beetlebugorg/penplotter/hardware/reference/SOURCES.md

# CR-10 V2/V3 reference models

Creality does not publish CAD for the CR-10 V3. These are models that owners made from the real parts.

| File | Source | Author | License |
|---|---|---|---|
| `carriage_plate_Bear.step` | <https://www.printables.com/model/205016> | Bear | CC BY |
| `carriage_plate_J_Cross.step` | <https://www.printables.com/model/139901> | J_Cross | CC BY |
| `titan_coupling_InternalError33.step` | <https://www.printables.com/model/188638> | InternalError33 | Public domain |

The two carriage plate models agree on the tool head hole pattern to about 1 mm.
