beetlebugorg/penplotter/hardware/docs/hero-dark.png

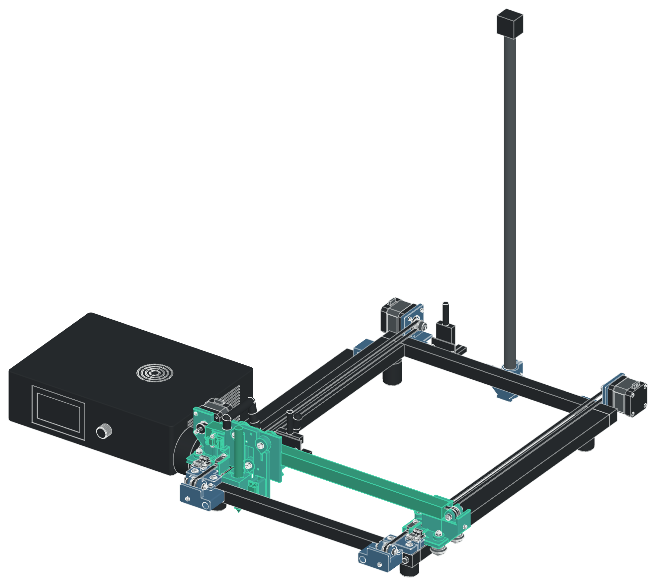
hardware/docs/hero-dark.png
