beetlebugorg/penplotter/hardware/cad/pen-lift-assembly.step

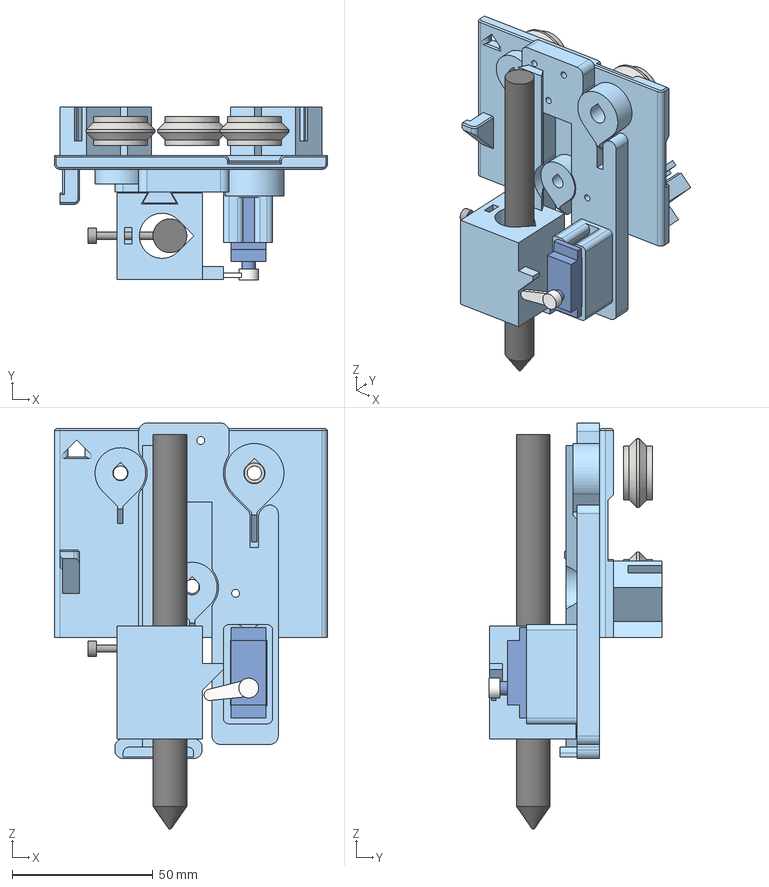
[picture p3: CAD file, 2026-11-12]
hardware/cad/pen-lift-assembly.step
96.9 x 61.5 x 144.0 mm
pen_lift
pen_slider
servo
horn_down
pen
screw
X plate
X wheel 0
X wheel 1
X wheel 2
