beetlebugorg/penplotter/hardware/cad/y_idler_bracket_right.step

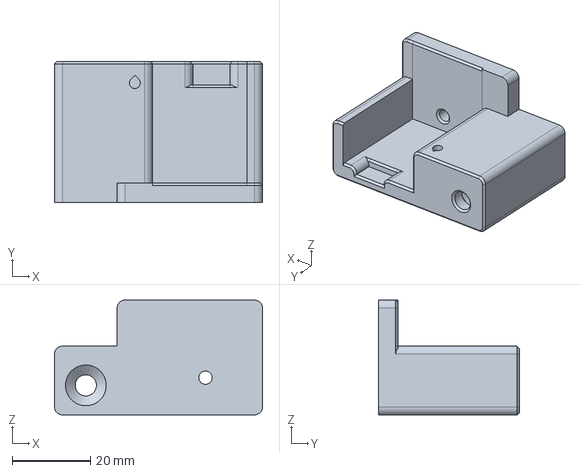
[picture p4: CAD file, 2026-11-12]
hardware/cad/y_idler_bracket_right.step
53.1 x 36.0 x 29.3 mm
