beetlebugorg/penplotter/hardware/stl/context/x_wheels.stl

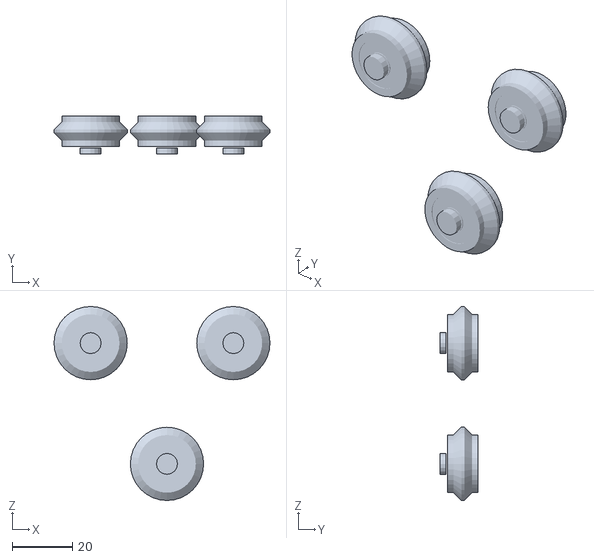
[picture p5: CAD file, 2026-11-12]
hardware/stl/context/x_wheels.stl
71.9 x 12.7 x 64.6
