beetlebugorg/penplotter/hardware/stl/detail/gantry_steel.stl

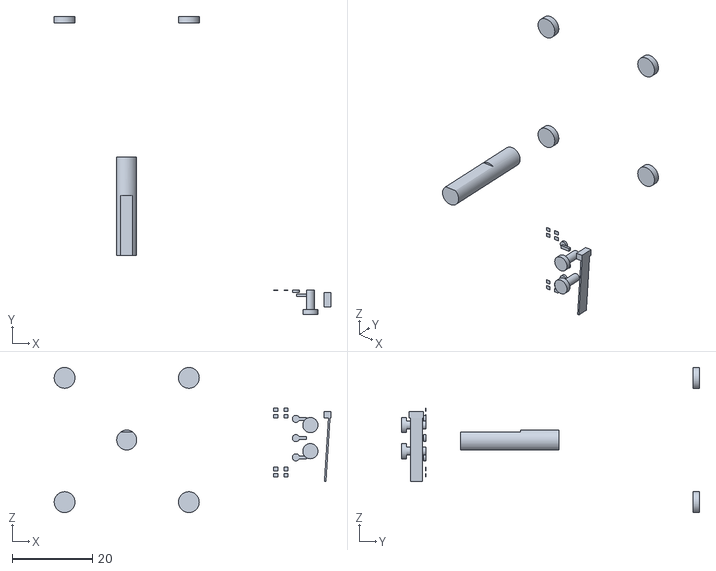
[picture p6: CAD file, 2026-11-12]
hardware/stl/detail/gantry_steel.stl
69.0 x 74.3 x 36.2
