beetlebugorg/penplotter/hardware/stl/sim2/fasteners_carriage.stl

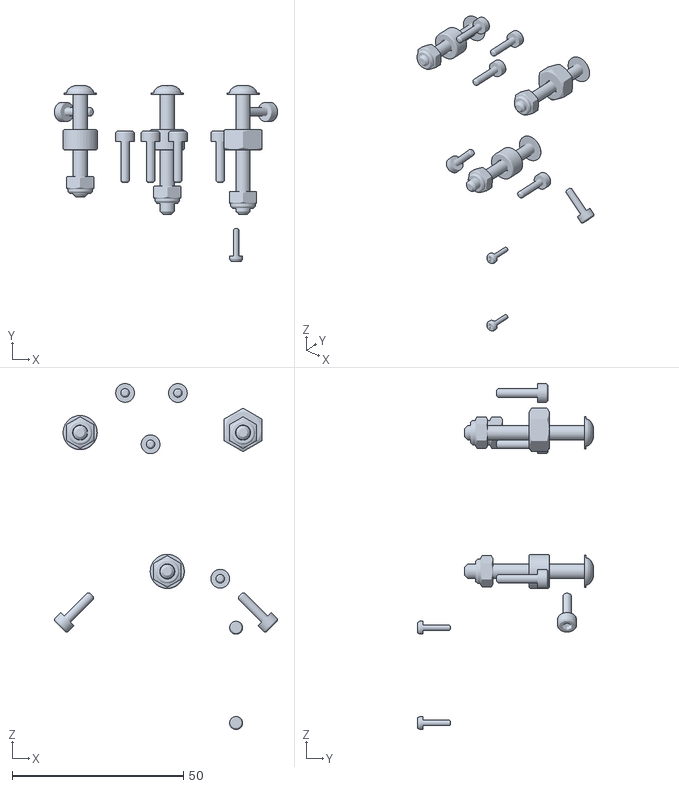
[picture p7: CAD file, 2026-11-12]
hardware/stl/sim2/fasteners_carriage.stl
65.1 x 51.3 x 101.0
