beetlebugorg/penplotter/hardware/cad/x_idler_fork.step

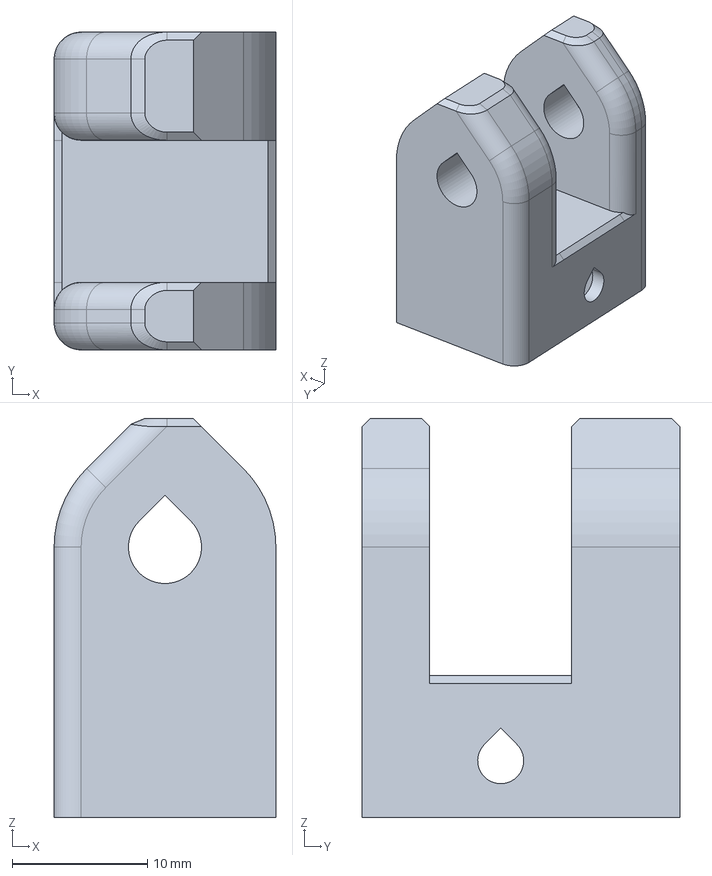
[picture p8: CAD file, 2026-11-12]
hardware/cad/x_idler_fork.step
16.4 x 23.5 x 29.5 mm
