beetlebugorg/penplotter/hardware/stl/context/x_belt.stl

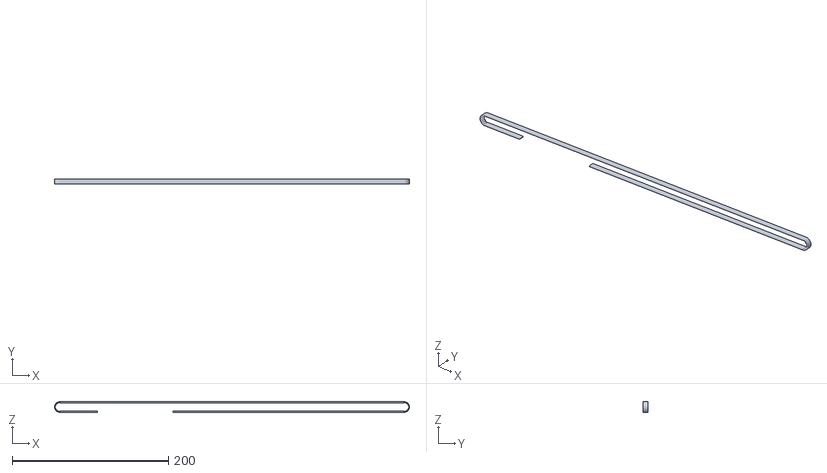
[picture p9: CAD file, 2026-11-12]
hardware/stl/context/x_belt.stl
454.0 x 6.00 x 13.5
