beetlebugorg/penplotter/hardware/stl/detail/gantry_smd_light.stl

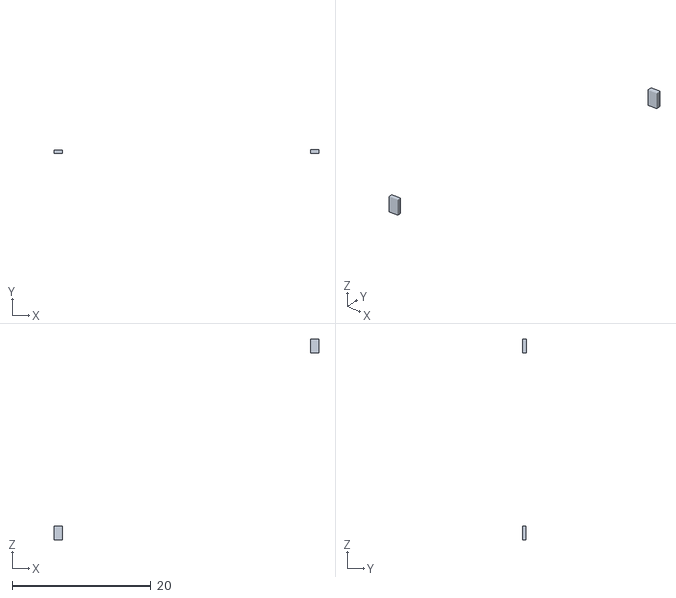
[picture p10: CAD file, 2026-11-12]
hardware/stl/detail/gantry_smd_light.stl
38.2 x 0.6 x 29.0
