beetlebugorg/penplotter/hardware/stl/sim2/y_carriage_right.stl

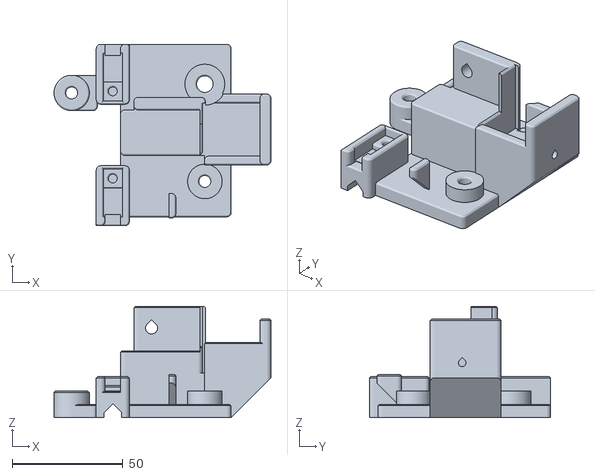
[picture p11: CAD file, 2026-11-12]
hardware/stl/sim2/y_carriage_right.stl
98.1 x 82.0 x 50.3
