beetlebugorg/penplotter/hardware/cad/pen_slider.step

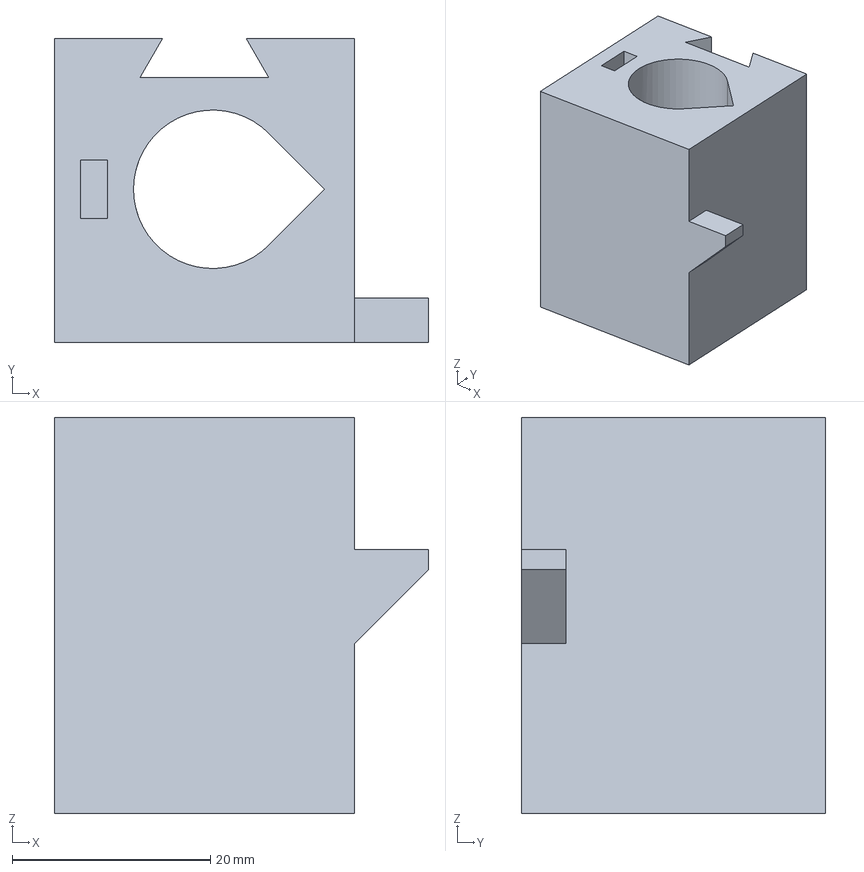
[picture p12: CAD file, 2026-11-12]
hardware/cad/pen_slider.step
37.8 x 30.7 x 40.0 mm
