beetlebugorg/penplotter/hardware/stl/context/servo_loom.stl

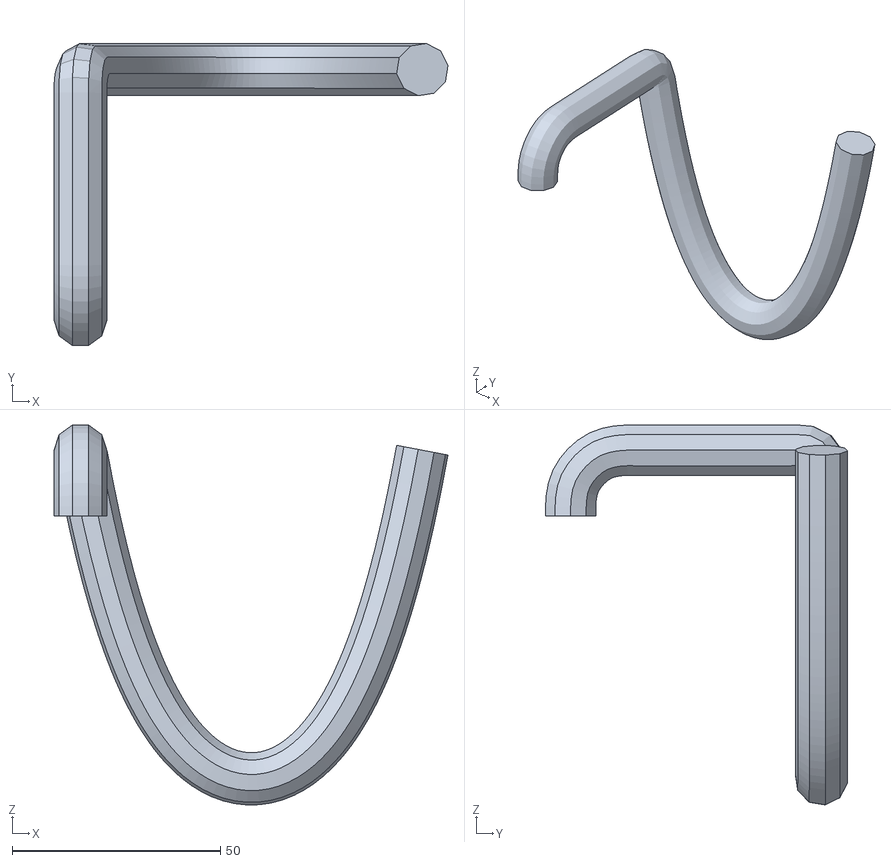
[picture p13: CAD file, 2026-11-12]
hardware/stl/context/servo_loom.stl
94.6 x 72.5 x 91.2
