beetlebugorg/penplotter/hardware/stl/detail/gantry_x_pulley.stl

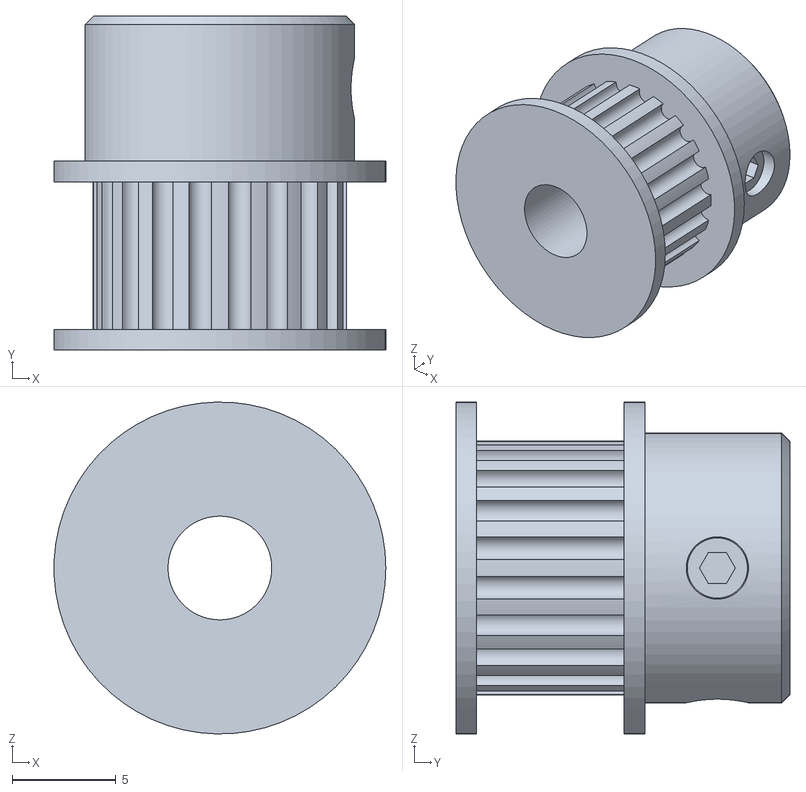
[picture p14: CAD file, 2026-11-12]
hardware/stl/detail/gantry_x_pulley.stl
16.0 x 16.1 x 16.0
