beetlebugorg/penplotter/hardware/stl/hardware/carriage/eccentric_eccentric_spacer_stock-yp.stl

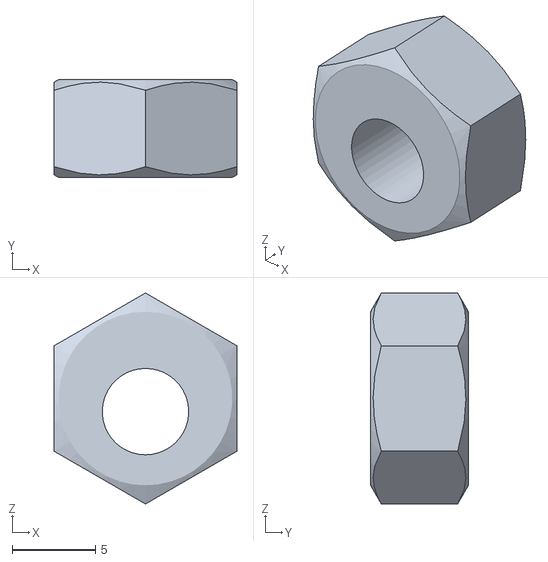
[picture p15: CAD file, 2026-11-12]
hardware/stl/hardware/carriage/eccentric_eccentric_spacer_stock-yp.stl
11.0 x 5.90 x 12.7
