beetlebugorg/penplotter/hardware/stl/hardware/left/insert_m3_heat_set_insert_5_7_mm-yn.stl

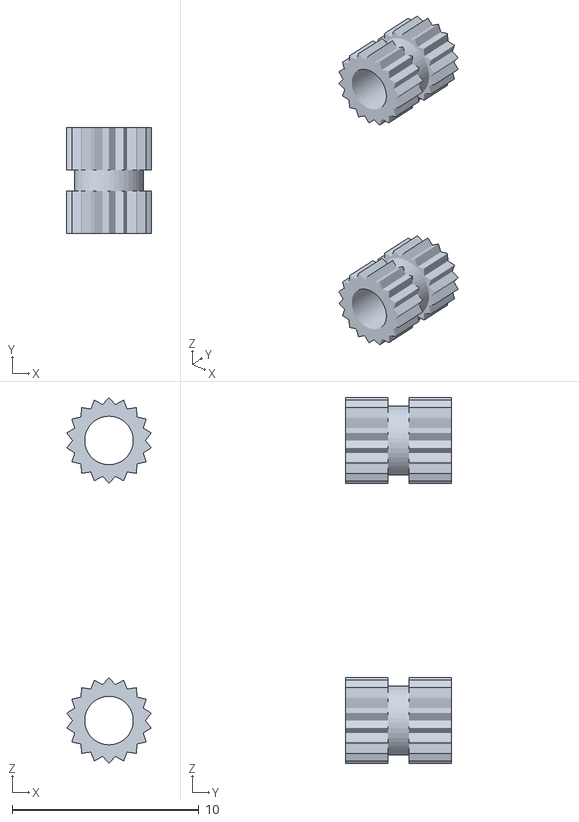
[picture p16: CAD file, 2026-11-12]
hardware/stl/hardware/left/insert_m3_heat_set_insert_5_7_mm-yn.stl
4.53 x 5.65 x 19.6
