beetlebugorg/penplotter/hardware/stl/sim2/x_carriage_plate.stl

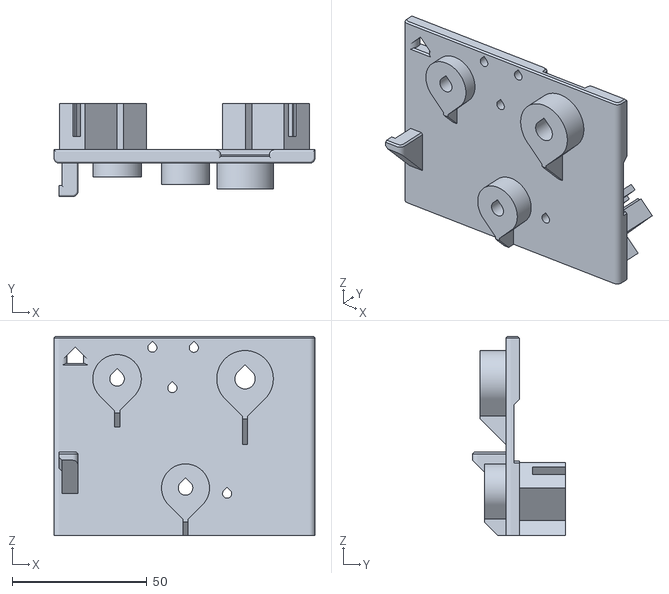
[picture p17: CAD file, 2026-11-12]
hardware/stl/sim2/x_carriage_plate.stl
96.9 x 34.6 x 74.0
