beetlebugorg/penplotter/hardware/cad/y_front_left.step

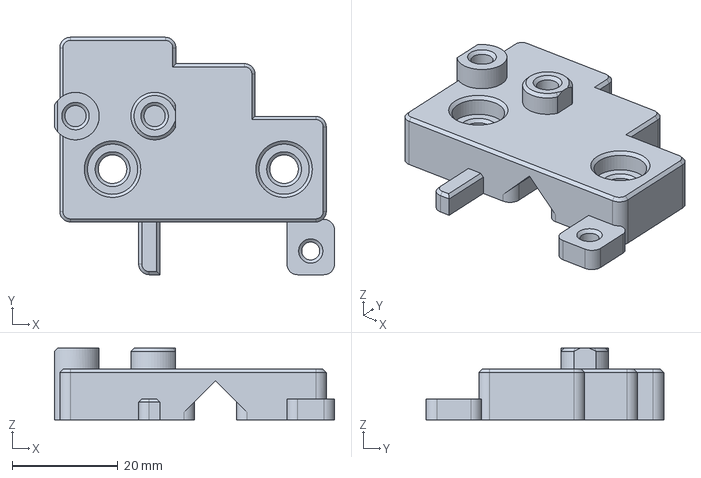
[picture p18: CAD file, 2026-11-12]
hardware/cad/y_front_left.step
53.0 x 45.0 x 13.6 mm
