beetlebugorg/penplotter/hardware/stl/context/y_wheels.stl

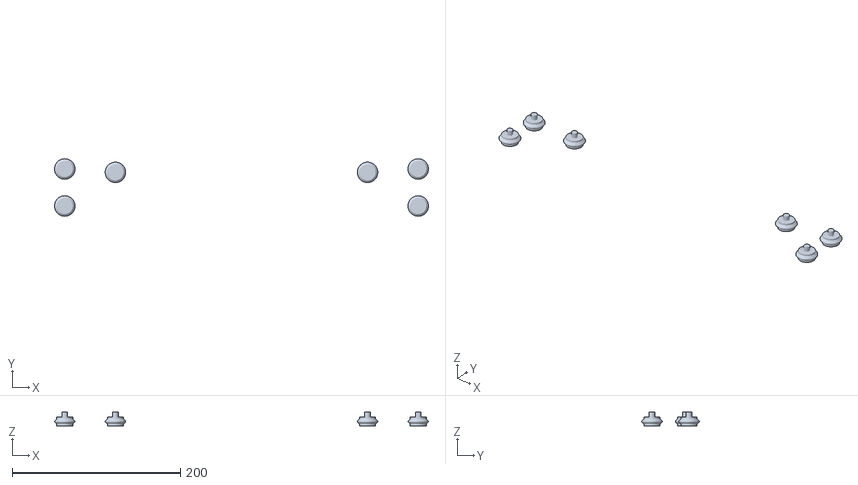
[picture p19: CAD file, 2026-11-12]
hardware/stl/context/y_wheels.stl
444.6 x 68.4 x 16.1
