beetlebugorg/penplotter/hardware/stl/detail/gantry_switch.stl

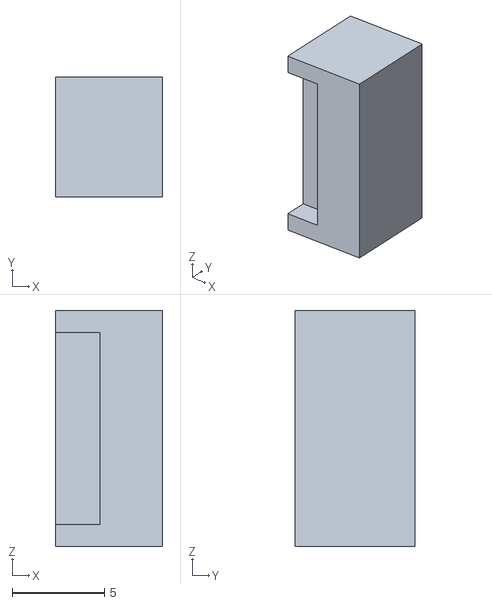
[picture p20: CAD file, 2026-11-12]
hardware/stl/detail/gantry_switch.stl
5.80 x 6.50 x 12.8
