beetlebugorg/penplotter/hardware/stl/hardware/carriage/insert_m3_heat_set_insert_5_7_mm-n0707_p0000_n0707.stl

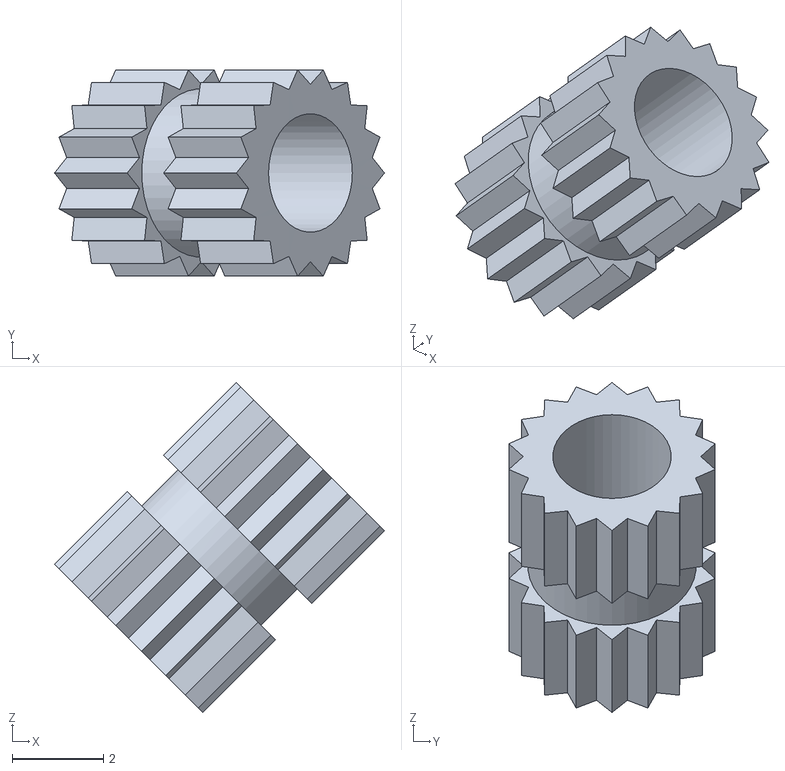
[picture p21: CAD file, 2026-11-12]
hardware/stl/hardware/carriage/insert_m3_heat_set_insert_5_7_mm-n0707_p0000_n0707.stl
7.25 x 4.53 x 7.25
