beetlebugorg/penplotter/hardware/stl/sim2/pen_carriage.stl

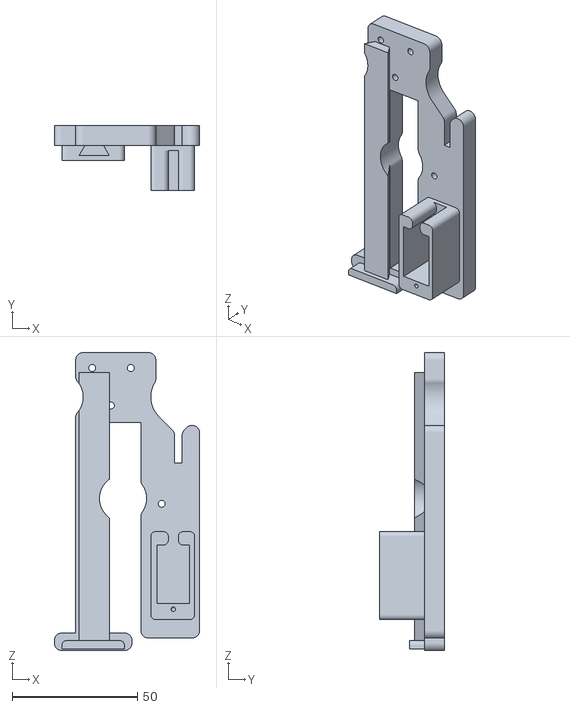
[picture p22: CAD file, 2026-11-12]
hardware/stl/sim2/pen_carriage.stl
58.0 x 25.9 x 119.0
