beetlebugorg/penplotter/hardware/cad/y_motor_mount_right.step

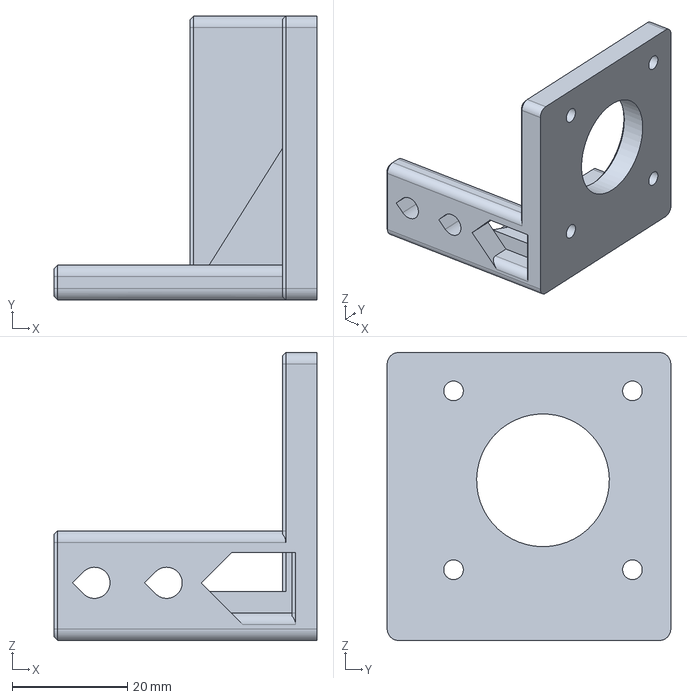
[picture p23: CAD file, 2026-11-12]
hardware/cad/y_motor_mount_right.step
45.6 x 49.1 x 49.9 mm
