beetlebugorg/penplotter/hardware/stl/context/x_beam.stl

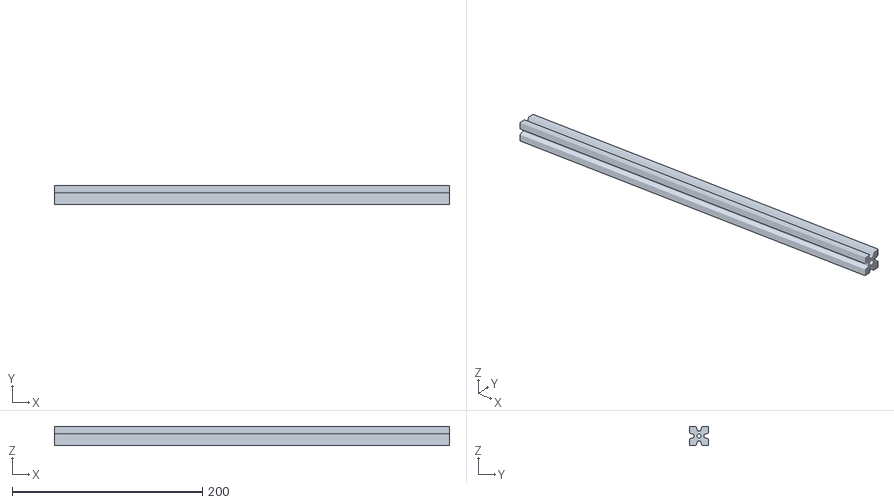
[picture p24: CAD file, 2026-11-12]
hardware/stl/context/x_beam.stl
415.0 x 20.0 x 20.0
