beetlebugorg/penplotter/hardware/stl/detail/carriage_wire_brown.stl

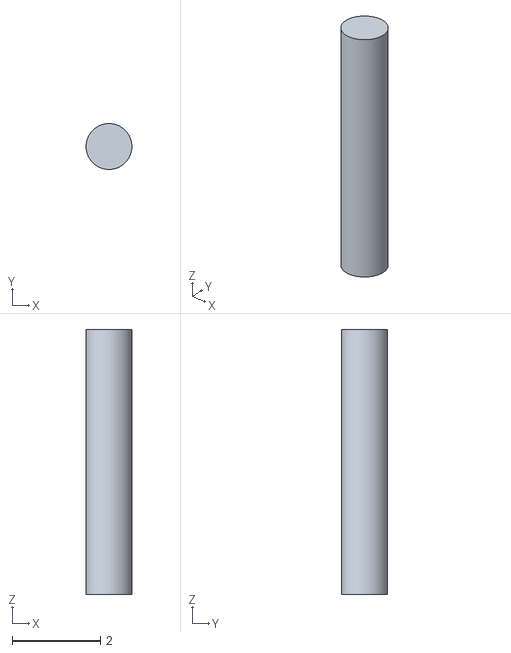
[picture p25: CAD file, 2026-11-12]
hardware/stl/detail/carriage_wire_brown.stl
1.04 x 1.04 x 6.00
