beetlebugorg/penplotter/hardware/stl/hardware/carriage/wheel_v_wheel_stock-yp.stl

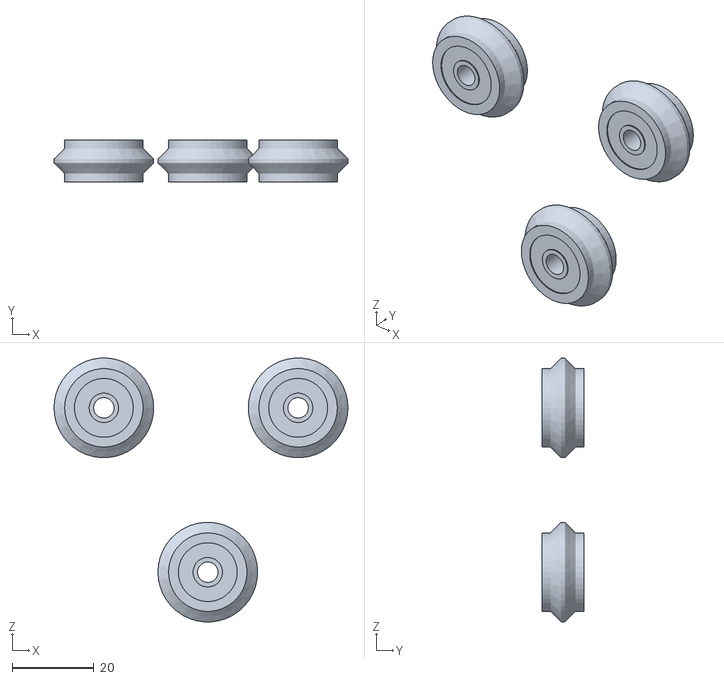
[picture p26: CAD file, 2026-11-12]
hardware/stl/hardware/carriage/wheel_v_wheel_stock-yp.stl
71.9 x 10.2 x 64.5
