beetlebugorg/penplotter/hardware/stl/hardware/right/clip_belt_jaw_printed-zp.stl

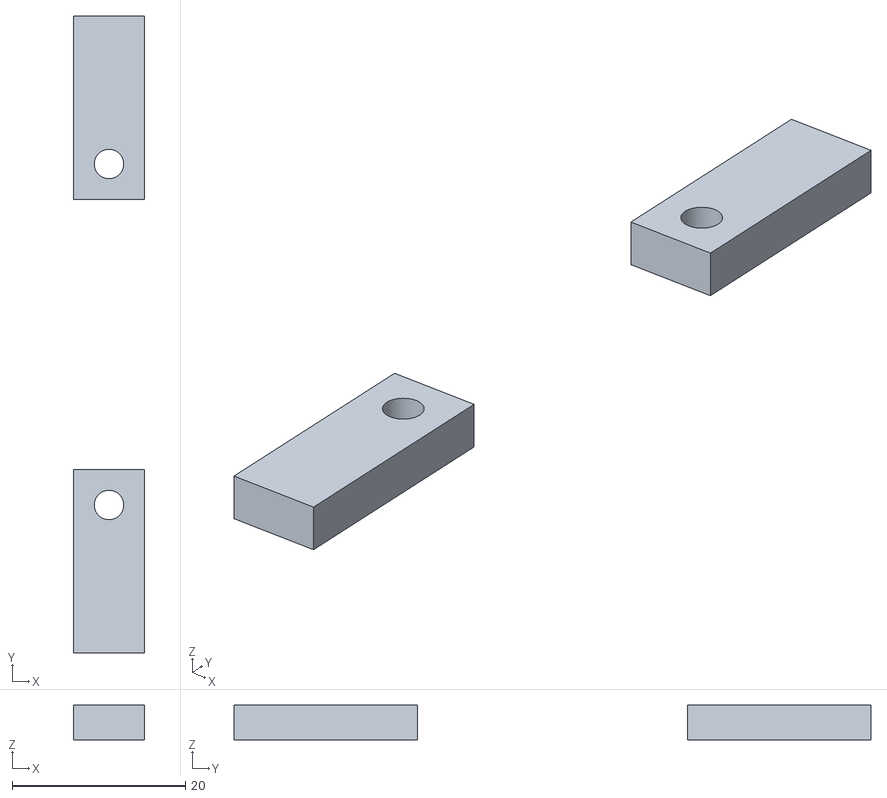
[picture p27: CAD file, 2026-11-12]
hardware/stl/hardware/right/clip_belt_jaw_printed-zp.stl
8.20 x 73.6 x 4.00
