beetlebugorg/penplotter/hardware/stl/sim2/fasteners_gantry.stl

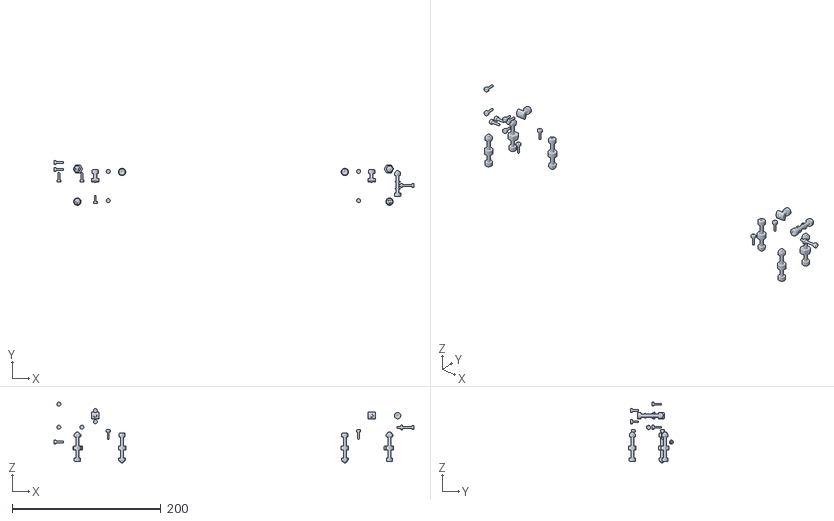
[picture p28: CAD file, 2026-11-12]
hardware/stl/sim2/fasteners_gantry.stl
484.5 x 60.2 x 81.7
