beetlebugorg/penplotter/hardware/cad/fit_rail.step

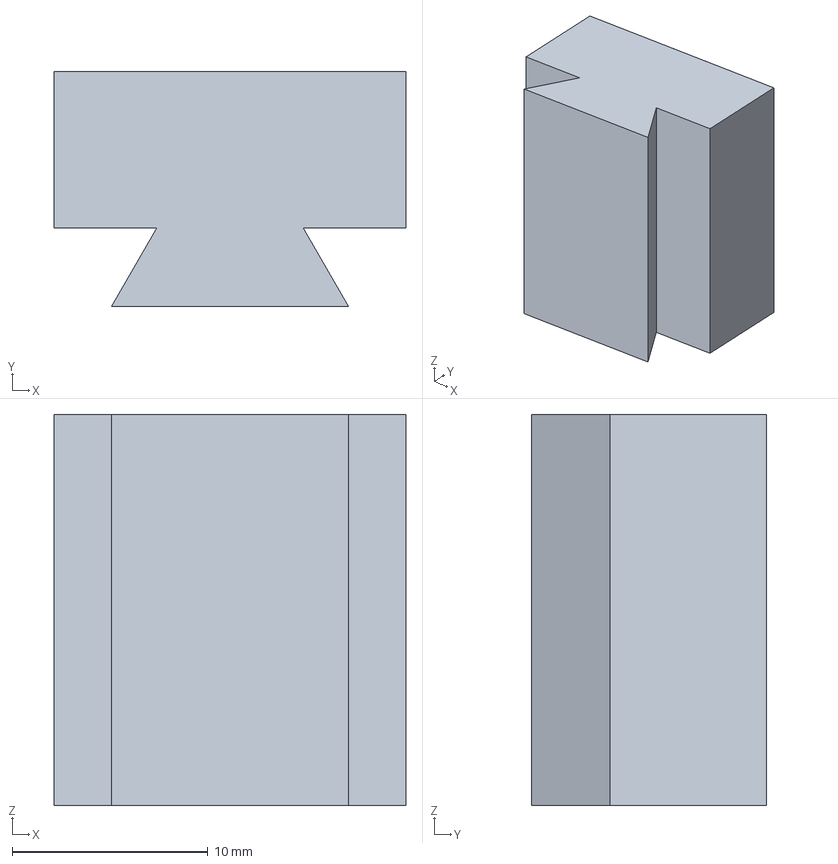
[picture p29: CAD file, 2026-11-12]
hardware/cad/fit_rail.step
18.0 x 12.0 x 20.0 mm
