beetlebugorg/penplotter/hardware/stl/context/x_endstop.stl

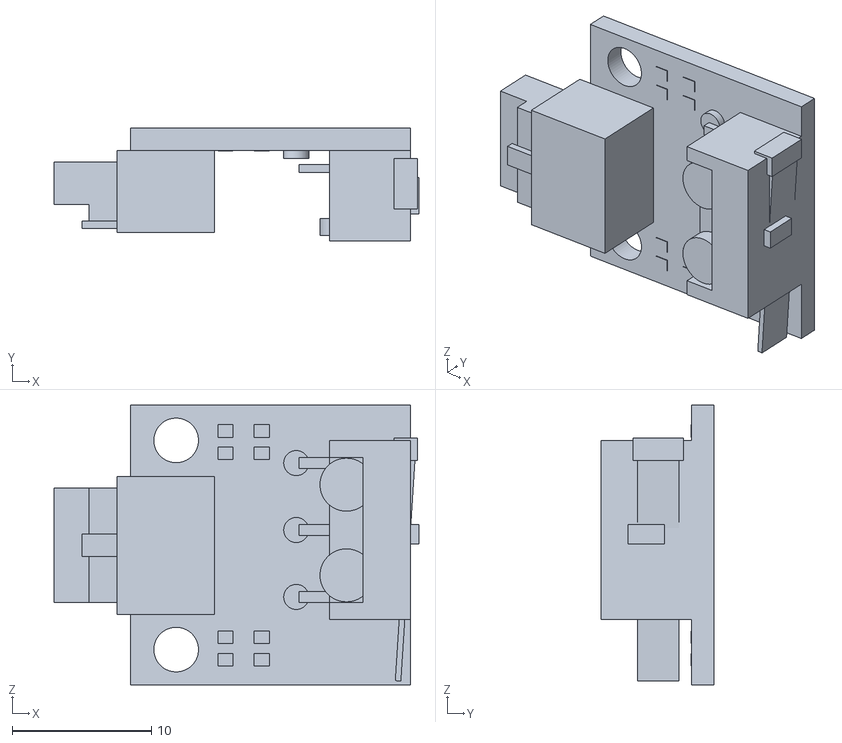
[picture p30: CAD file, 2026-11-12]
hardware/stl/context/x_endstop.stl
26.2 x 8.10 x 20.1
