beetlebugorg/penplotter/hardware/stl/detail/carriage_servo.stl

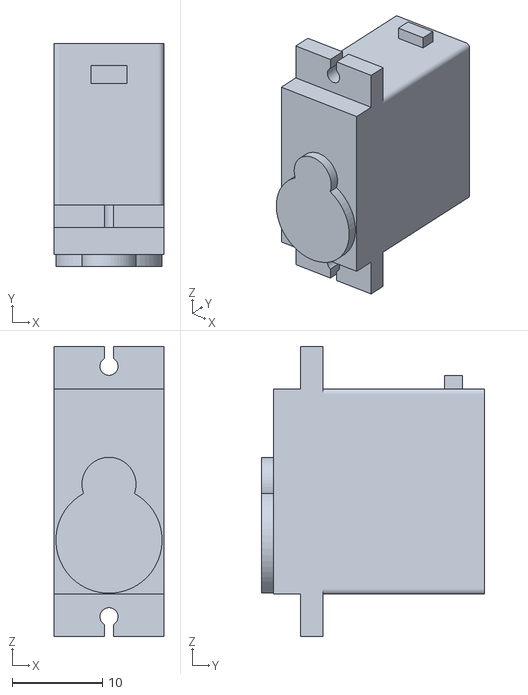
[picture p31: CAD file, 2026-11-12]
hardware/stl/detail/carriage_servo.stl
12.2 x 24.7 x 32.2
