beetlebugorg/penplotter/hardware/stl/sim2/y_carriage_left.stl

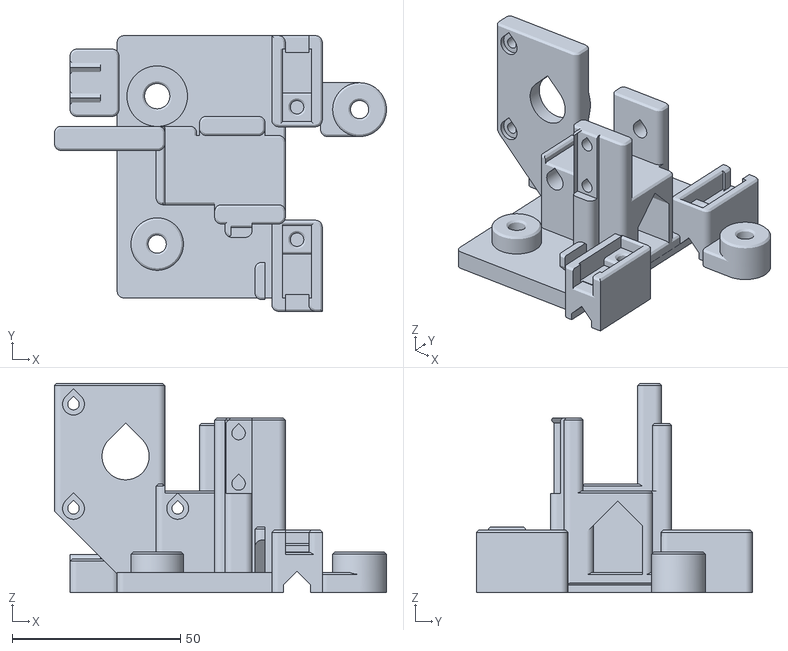
[picture p32: CAD file, 2026-11-12]
hardware/stl/sim2/y_carriage_left.stl
98.8 x 82.0 x 62.2
