beetlebugorg/penplotter/hardware/cad/mast_foot.step

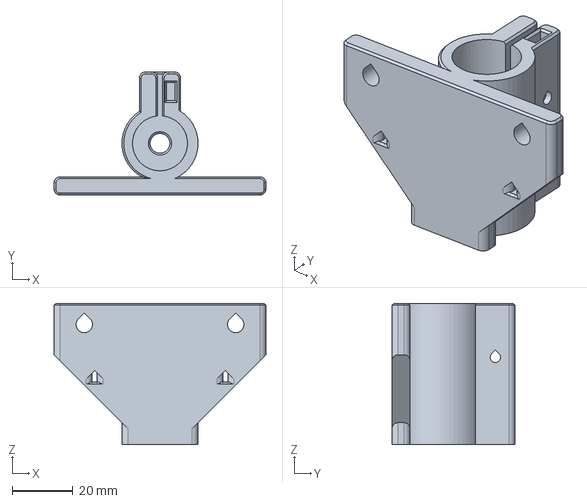
[picture p33: CAD file, 2026-11-12]
hardware/cad/mast_foot.step
70.0 x 40.6 x 46.7 mm
