beetlebugorg/penplotter/hardware/stl/context/camera_pole.stl

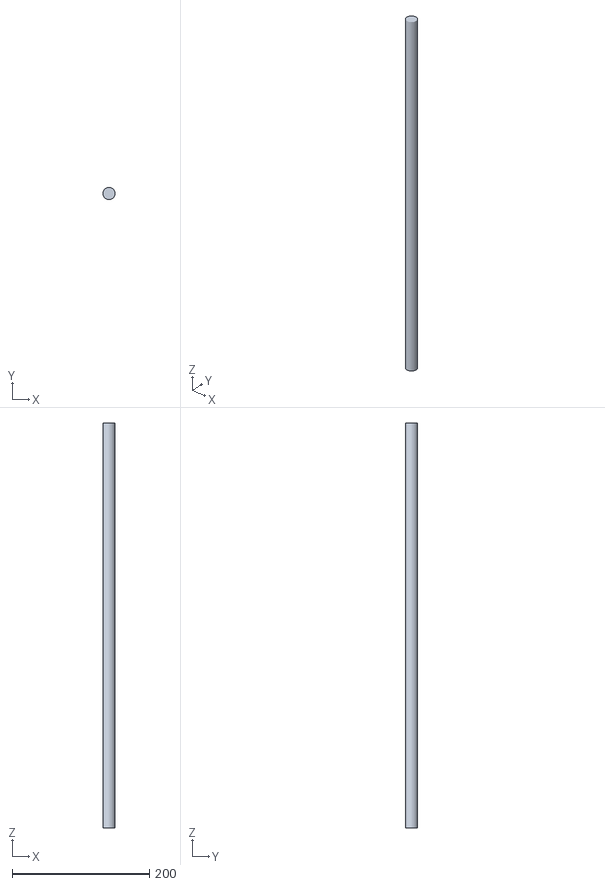
[picture p34: CAD file, 2026-11-12]
hardware/stl/context/camera_pole.stl
17.9 x 17.9 x 590.0
