beetlebugorg/penplotter/hardware/stl/detail/gantry_plunger.stl

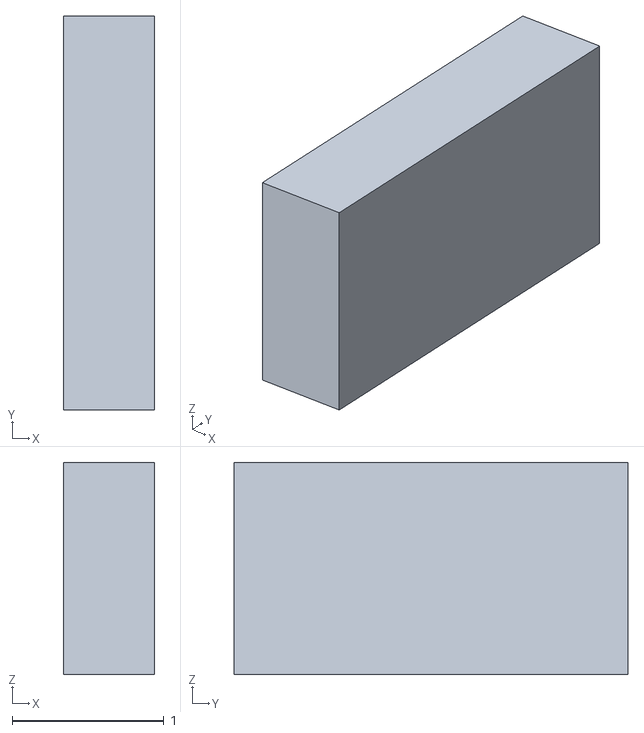
[picture p35: CAD file, 2026-11-12]
hardware/stl/detail/gantry_plunger.stl
0.6 x 2.60 x 1.40
