beetlebugorg/penplotter/hardware/stl/hardware/left/wheel_v_wheel_stock-zn.stl

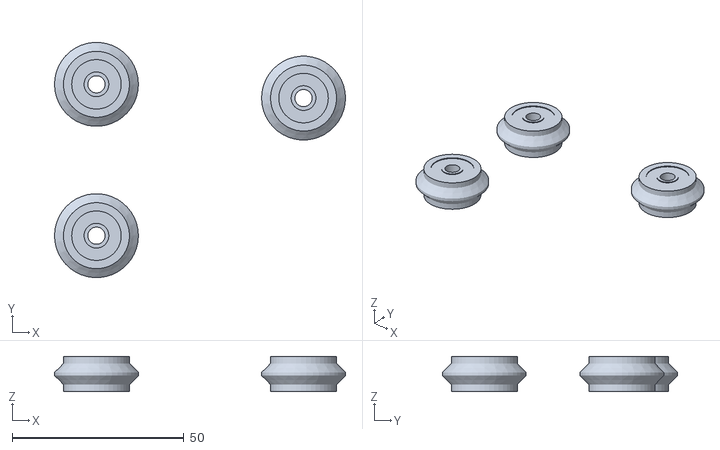
[picture p36: CAD file, 2026-11-12]
hardware/stl/hardware/left/wheel_v_wheel_stock-zn.stl
84.6 x 68.3 x 10.2
