beetlebugorg/penplotter/hardware/stl/sim2/inserts_carriage.stl

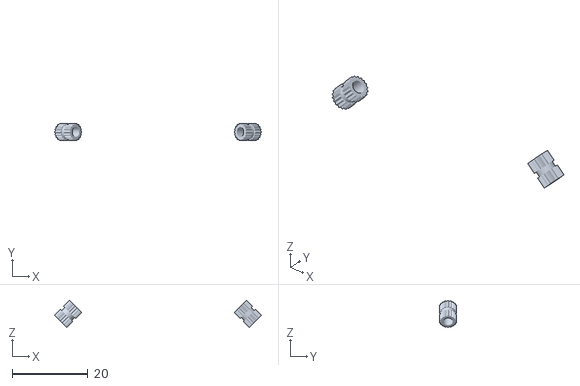
[picture p37: CAD file, 2026-11-12]
hardware/stl/sim2/inserts_carriage.stl
54.8 x 4.53 x 7.25
