beetlebugorg/penplotter/hardware/stl/context/y_belts.stl

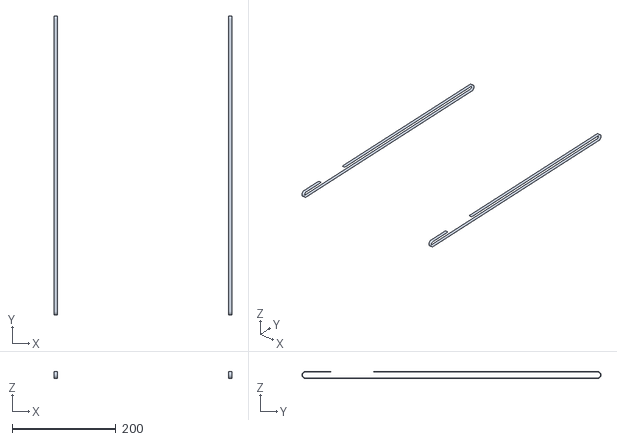
[picture p38: CAD file, 2026-11-12]
hardware/stl/context/y_belts.stl
343.0 x 577.5 x 13.5
