beetlebugorg/penplotter/hardware/stl/detail/gantry_black_plastic.stl

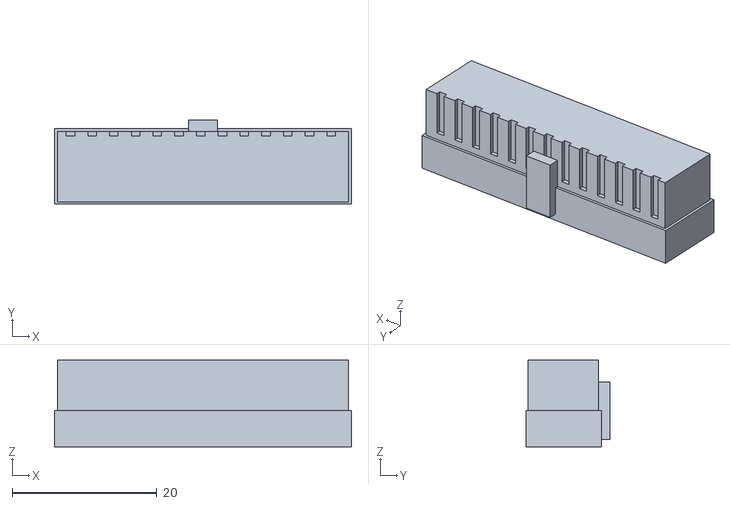
[picture p39: CAD file, 2026-11-12]
hardware/stl/detail/gantry_black_plastic.stl
41.0 x 11.6 x 12.0
