beetlebugorg/penplotter/hardware/stl/sim2/inserts_gantry.stl

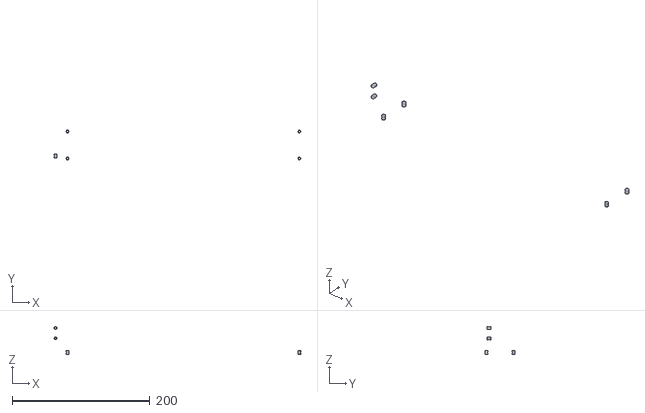
[picture p40: CAD file, 2026-11-12]
hardware/stl/sim2/inserts_gantry.stl
359.0 x 43.9 x 40.9
