beetlebugorg/penplotter/hardware/stl/context/drag_chain_moving.stl

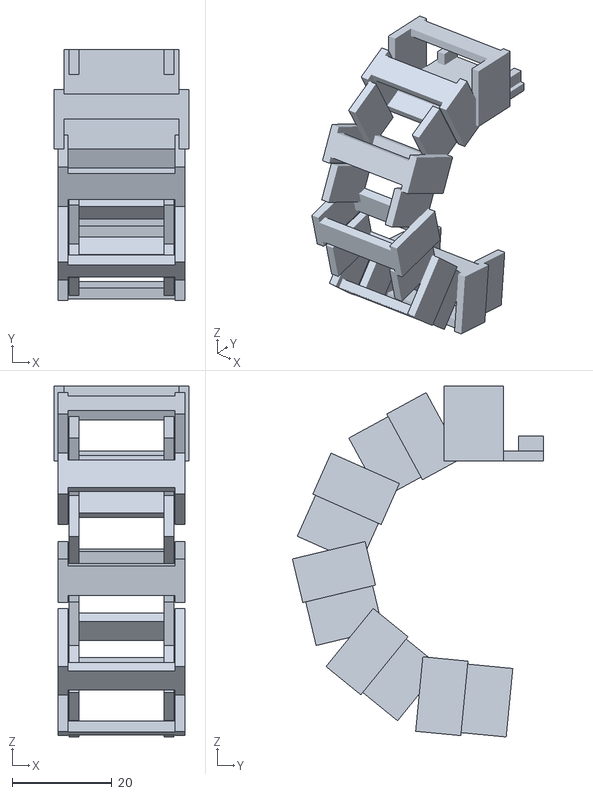
[picture p41: CAD file, 2026-11-12]
hardware/stl/context/drag_chain_moving.stl
27.0 x 50.4 x 70.4
