beetlebugorg/penplotter/hardware/stl/detail/gantry_pcb.stl

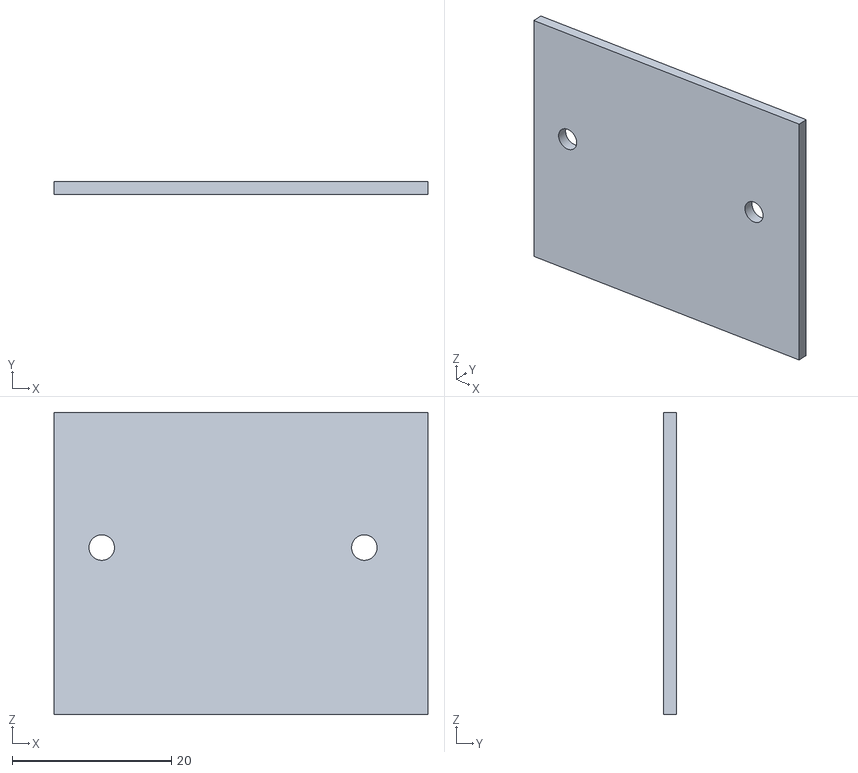
[picture p42: CAD file, 2026-11-12]
hardware/stl/detail/gantry_pcb.stl
47.0 x 1.60 x 38.0
