beetlebugorg/penplotter/hardware/stl/hardware/carriage/spacer_m5_spacer_6_mm_stock-yp.stl

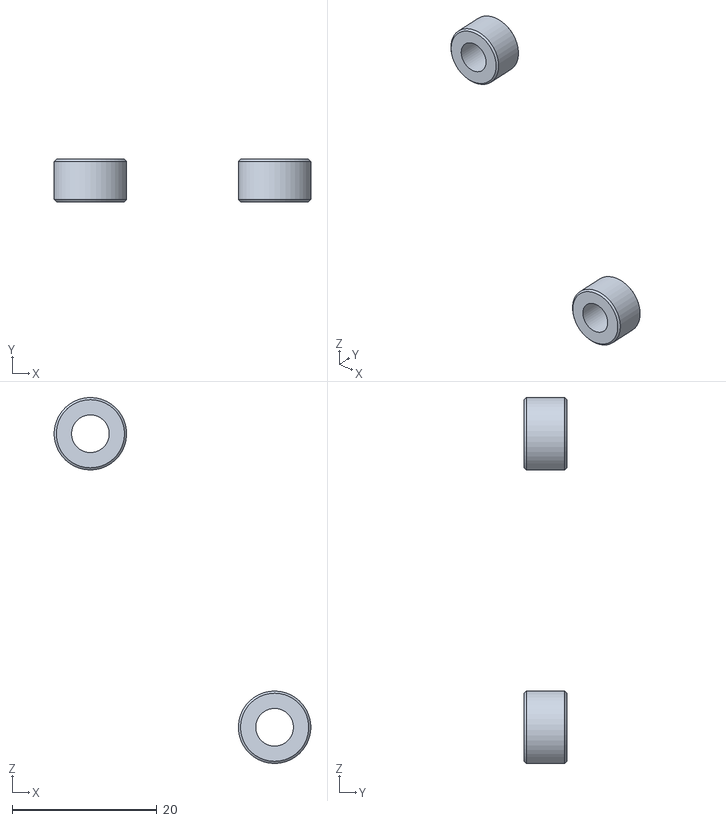
[picture p43: CAD file, 2026-11-12]
hardware/stl/hardware/carriage/spacer_m5_spacer_6_mm_stock-yp.stl
35.4 x 5.90 x 50.5
