beetlebugorg/penplotter/hardware/cad/y_chain_anchor.step

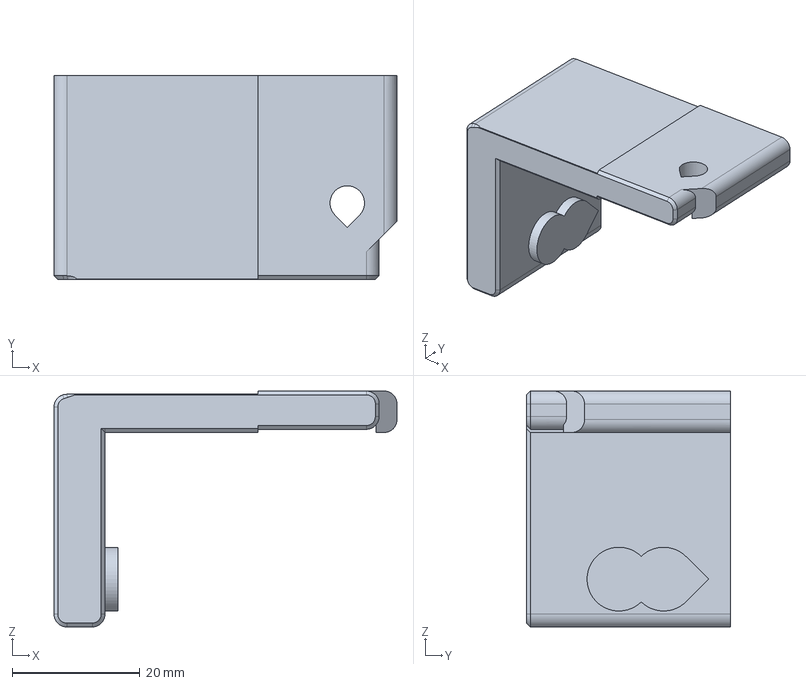
[picture p44: CAD file, 2026-11-12]
hardware/cad/y_chain_anchor.step
53.8 x 32.0 x 37.0 mm
