beetlebugorg/penplotter/hardware/stl/context/webcam.stl

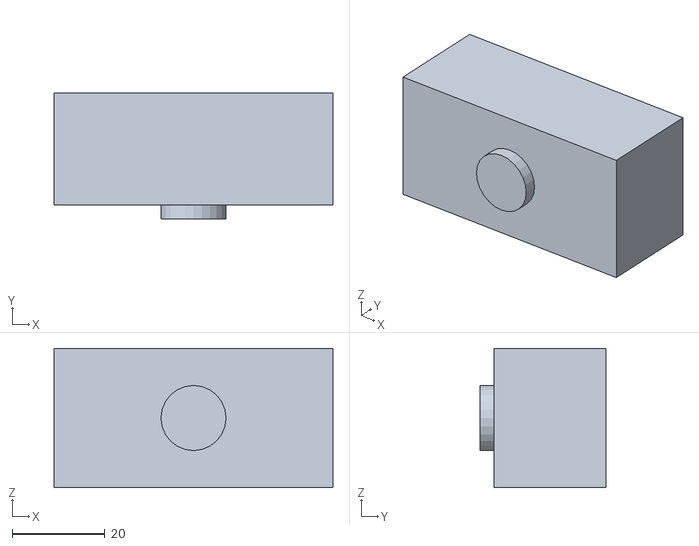
[picture p45: CAD file, 2026-11-12]
hardware/stl/context/webcam.stl
60.0 x 27.0 x 30.0
