beetlebugorg/penplotter/hardware/stl/detail/gantry_gold.stl

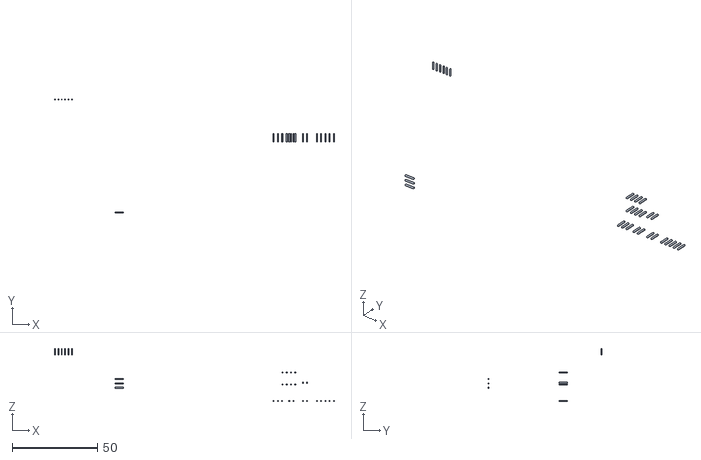
[picture p46: CAD file, 2026-11-12]
hardware/stl/detail/gantry_gold.stl
164.6 x 66.9 x 31.2
