beetlebugorg/penplotter/hardware/stl/hardware/carriage/clip_belt_jaw_printed-yp.stl

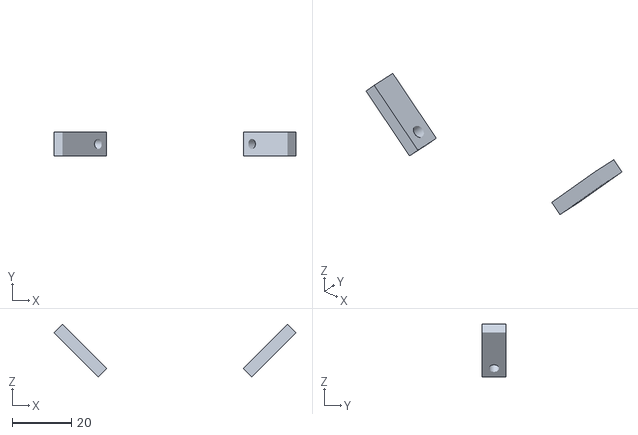
[picture p47: CAD file, 2026-11-12]
hardware/stl/hardware/carriage/clip_belt_jaw_printed-yp.stl
81.8 x 8.20 x 17.8
