beetlebugorg/penplotter/hardware/stl/sim2/belt_ends_gantry.stl

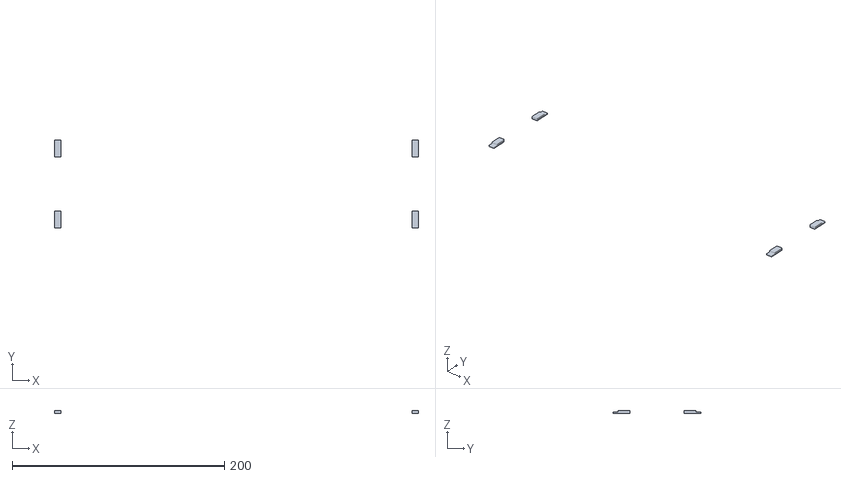
[picture p48: CAD file, 2026-11-12]
hardware/stl/sim2/belt_ends_gantry.stl
343.0 x 83.0 x 2.80
