beetlebugorg/penplotter/hardware/stl/context/control_box.stl

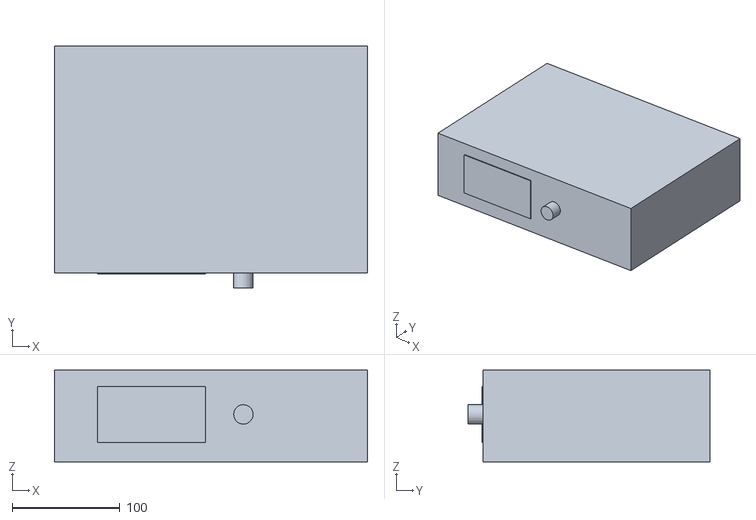
[picture p49: CAD file, 2026-11-10]
hardware/stl/context/control_box.stl
290.0 x 224.0 x 85.0
