beetlebugorg/penplotter/hardware/stl/detail/gantry_motor_cap.stl

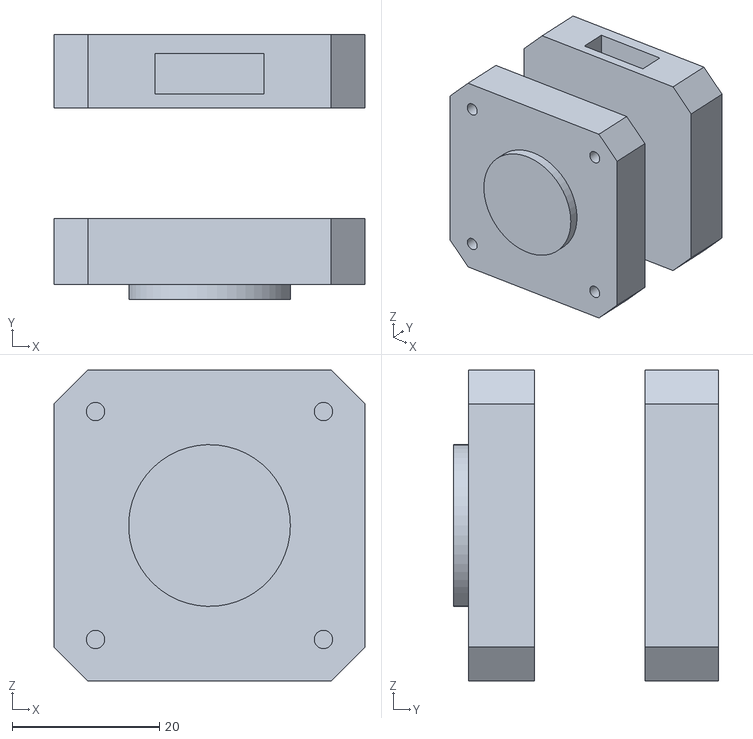
[picture p50: CAD file, 2026-11-12]
hardware/stl/detail/gantry_motor_cap.stl
42.3 x 36.0 x 42.3
