beetlebugorg/penplotter/hardware/stl/sim2/servo.stl

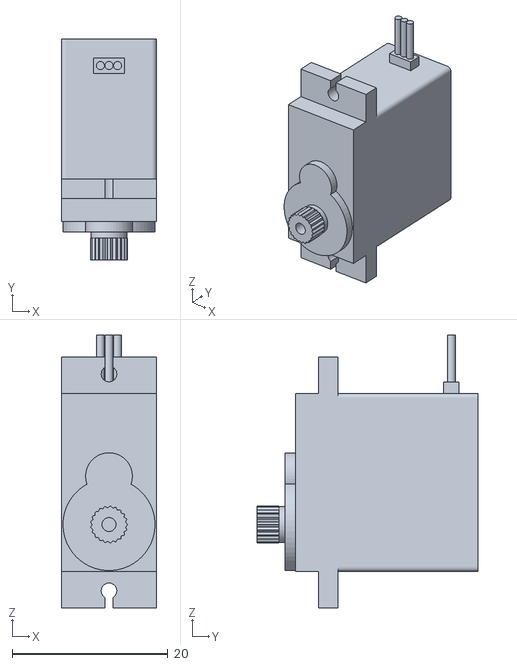
[picture p51: CAD file, 2026-11-12]
hardware/stl/sim2/servo.stl
12.2 x 28.3 x 35.0
