beetlebugorg/penplotter/hardware/stl/context/drag_chain_fixed.stl

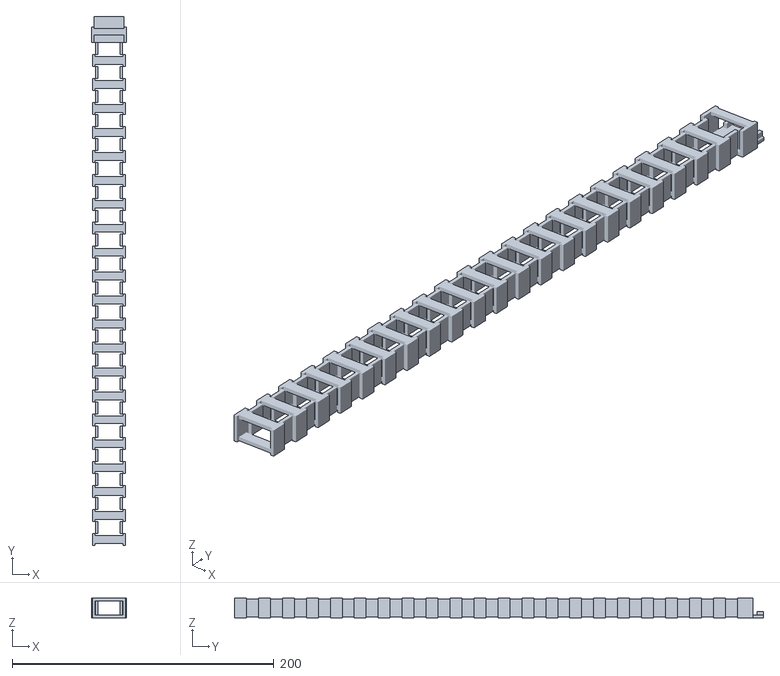
[picture p52: CAD file, 2026-11-10]
hardware/stl/context/drag_chain_fixed.stl
27.0 x 404.4 x 15.0
