beetlebugorg/penplotter/hardware/stl/detail/gantry_smd.stl

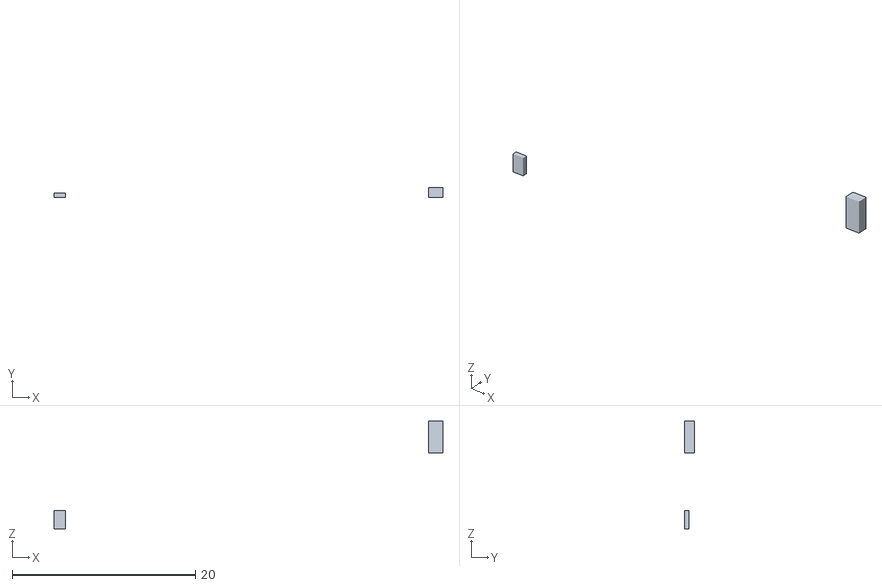
[picture p53: CAD file, 2026-11-12]
hardware/stl/detail/gantry_smd.stl
42.4 x 1.10 x 11.8
