beetlebugorg/penplotter/hardware/stl/hardware/left/insert_m3_heat_set_insert_5_7_mm-zp.stl

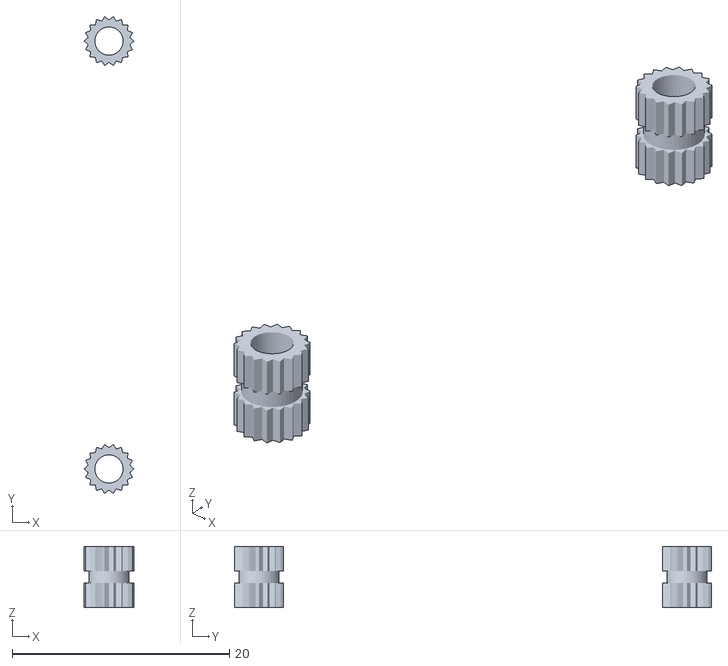
[picture p54: CAD file, 2026-11-12]
hardware/stl/hardware/left/insert_m3_heat_set_insert_5_7_mm-zp.stl
4.60 x 43.9 x 5.65
