beetlebugorg/penplotter/hardware/cad/fit_wheel.step

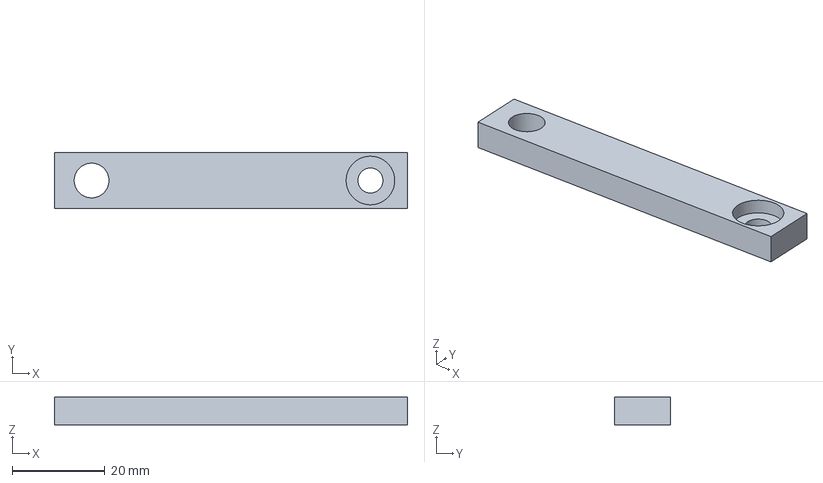
[picture p55: CAD file, 2026-11-12]
hardware/cad/fit_wheel.step
76.2 x 12.0 x 6.00 mm
