beetlebugorg/penplotter/hardware/stl/context/frame.stl

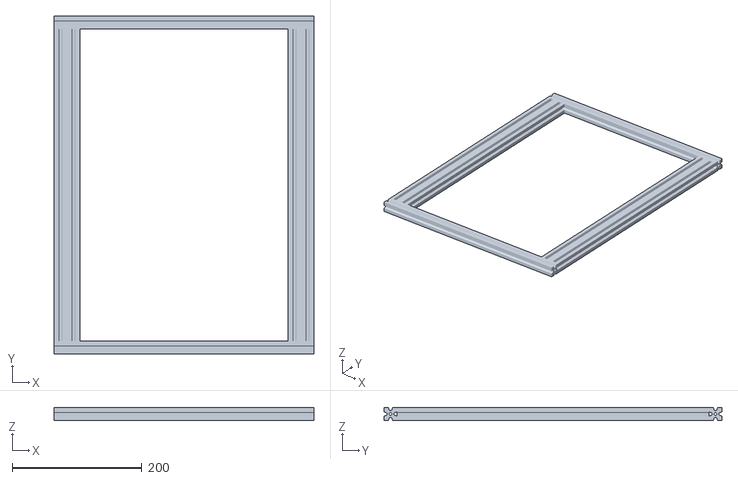
[picture p56: CAD file, 2026-11-10]
hardware/stl/context/frame.stl
400.0 x 520.0 x 20.0
