beetlebugorg/penplotter/hardware/stl/hardware/right/spacer_m5_spacer_6_mm_stock-zn.stl

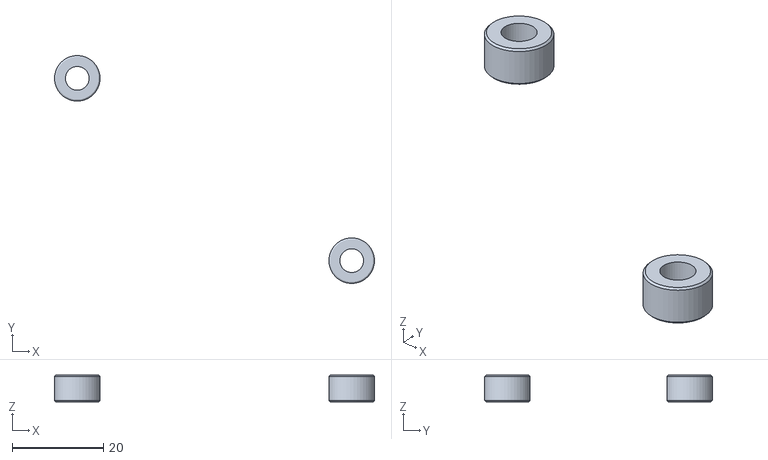
[picture p57: CAD file, 2026-11-12]
hardware/stl/hardware/right/spacer_m5_spacer_6_mm_stock-zn.stl
70.2 x 50.0 x 5.90
