beetlebugorg/penplotter/hardware/stl/context/feet.stl

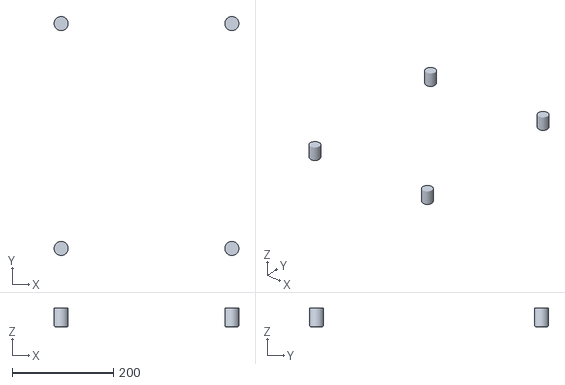
[picture p58: CAD file, 2026-11-10]
hardware/stl/context/feet.stl
366.0 x 473.0 x 37.0
