beetlebugorg/penplotter/hardware/stl/detail/gantry_motor_stack.stl

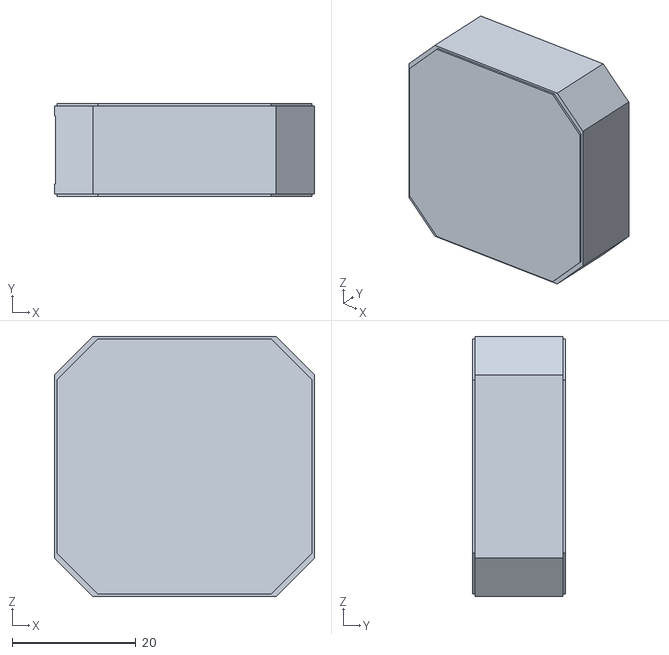
[picture p59: CAD file, 2026-11-12]
hardware/stl/detail/gantry_motor_stack.stl
42.0 x 15.0 x 42.0
