beetlebugorg/penplotter/hardware/stl/sim2/inserts_static.stl

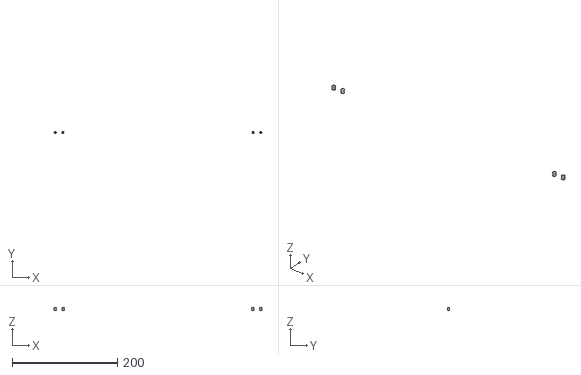
[picture p60: CAD file, 2026-11-12]
hardware/stl/sim2/inserts_static.stl
394.7 x 4.53 x 5.65
