beetlebugorg/penplotter/hardware/cad/belt_jaw.step

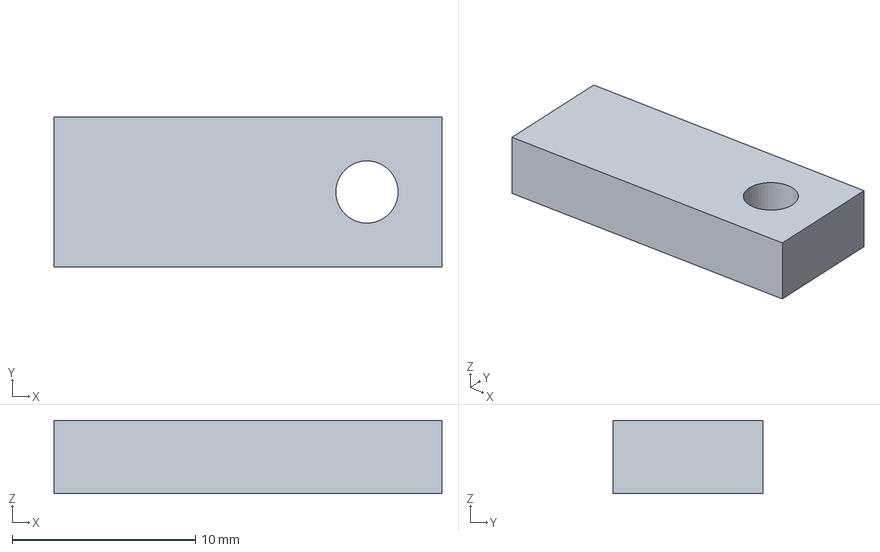
[picture p61: CAD file, 2026-11-12]
hardware/cad/belt_jaw.step
21.2 x 8.20 x 4.00 mm
