beetlebugorg/penplotter/hardware/stl/detail/gantry_pcb_dark.stl

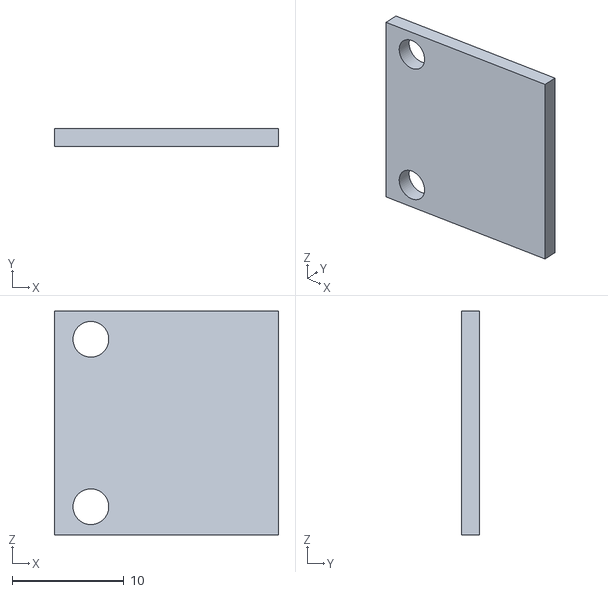
[picture p62: CAD file, 2026-11-12]
hardware/stl/detail/gantry_pcb_dark.stl
20.1 x 1.60 x 20.1
