beetlebugorg/penplotter/hardware/stl/sim2/x_idler.stl

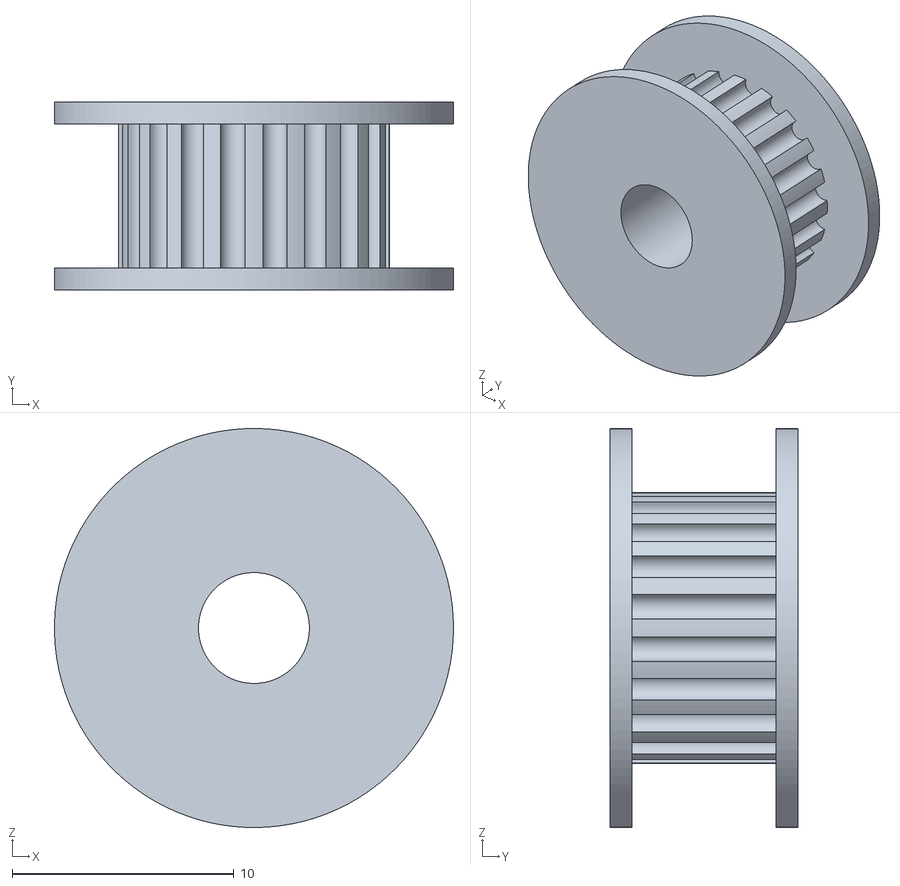
[picture p63: CAD file, 2026-11-12]
hardware/stl/sim2/x_idler.stl
18.0 x 8.50 x 18.0
