beetlebugorg/penplotter/hardware/cad/fit_slider.step

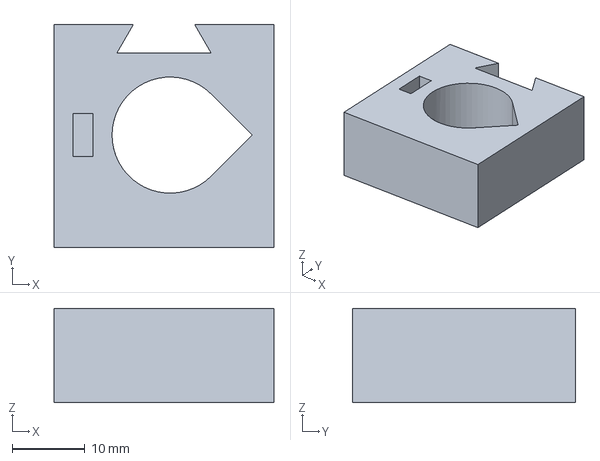
[picture p64: CAD file, 2026-11-12]
hardware/cad/fit_slider.step
30.3 x 30.7 x 13.0 mm
