beetlebugorg/penplotter/hardware/stl/sim2/beam.stl

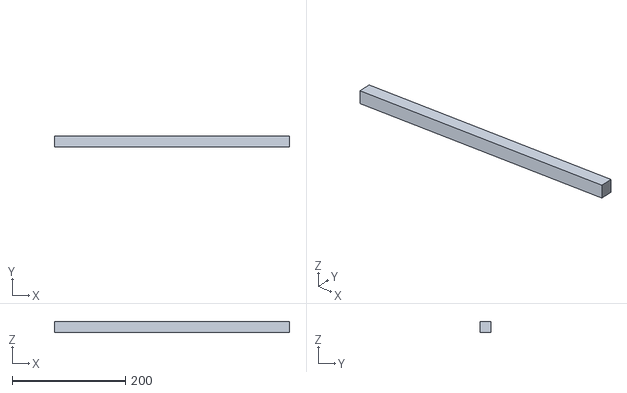
[picture p65: CAD file, 2026-11-12]
hardware/stl/sim2/beam.stl
415.0 x 20.0 x 20.0
