beetlebugorg/penplotter/hardware/stl/detail/gantry_label.stl

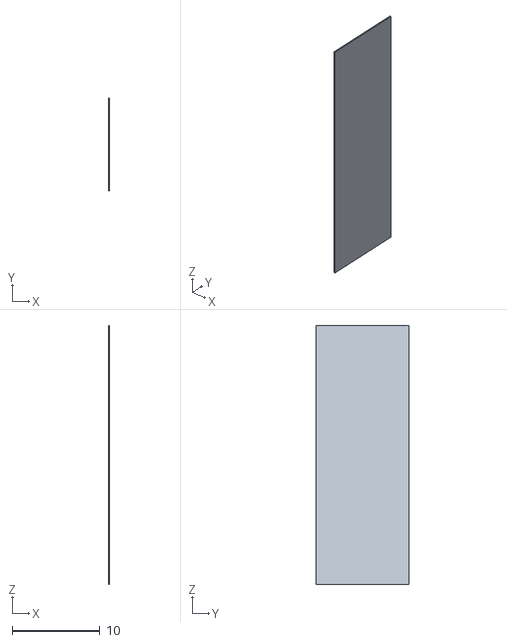
[picture p66: CAD file, 2026-11-12]
hardware/stl/detail/gantry_label.stl
0.15 x 10.6 x 29.6
