beetlebugorg/penplotter/hardware/stl/detail/static_steel.stl

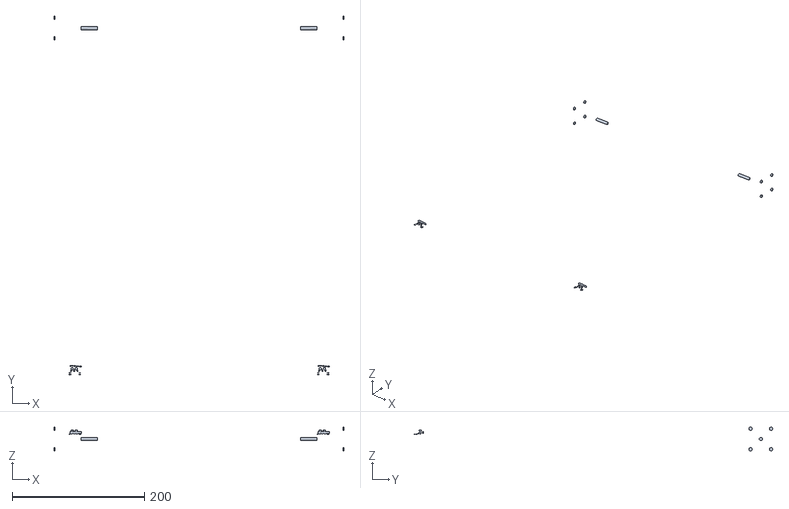
[picture p67: CAD file, 2026-11-12]
hardware/stl/detail/static_steel.stl
438.3 x 542.0 x 36.2
