beetlebugorg/penplotter/hardware/stl/sim2/fasteners_static.stl

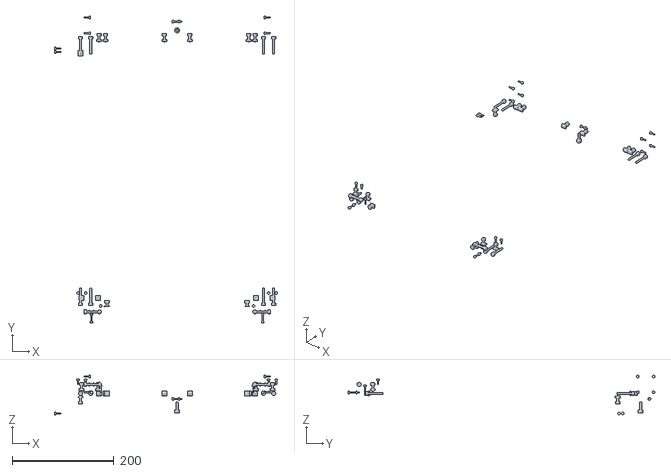
[picture p68: CAD file, 2026-11-12]
hardware/stl/sim2/fasteners_static.stl
439.3 x 604.2 x 78.3
