beetlebugorg/penplotter/hardware/stl/detail/carriage_black_plastic.stl

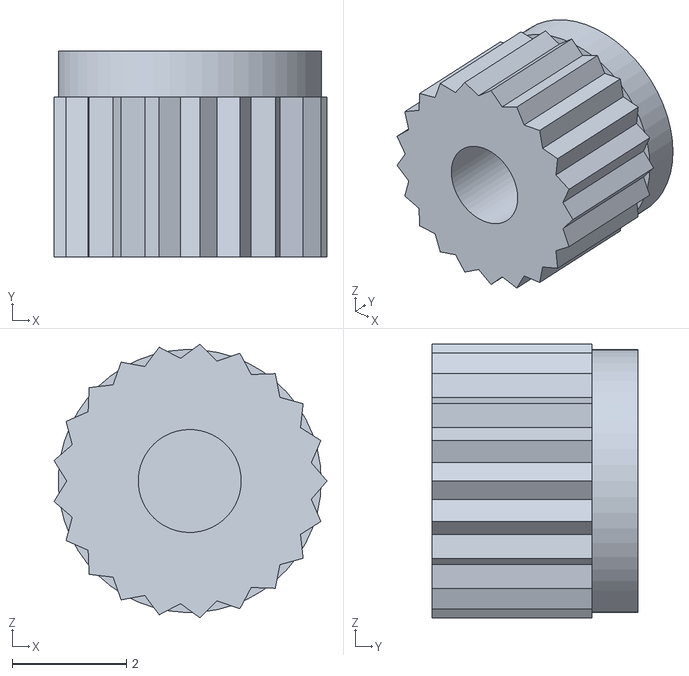
[picture p69: CAD file, 2026-11-12]
hardware/stl/detail/carriage_black_plastic.stl
4.77 x 3.60 x 4.79
