beetlebugorg/penplotter/hardware/stl/detail/gantry_nylon.stl

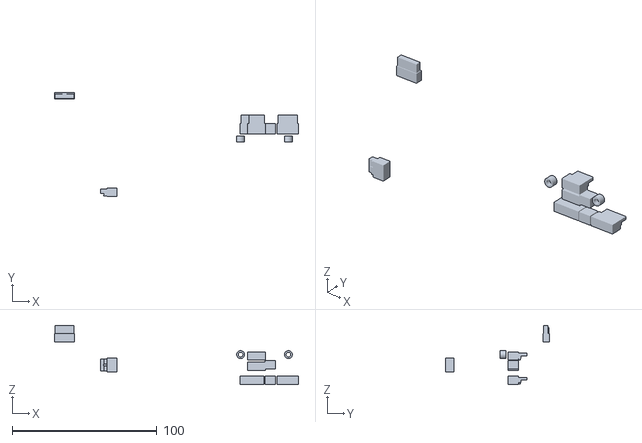
[picture p70: CAD file, 2026-11-12]
hardware/stl/detail/gantry_nylon.stl
168.4 x 71.5 x 40.7
