beetlebugorg/penplotter/hardware/stl/detail/static_nylon.stl

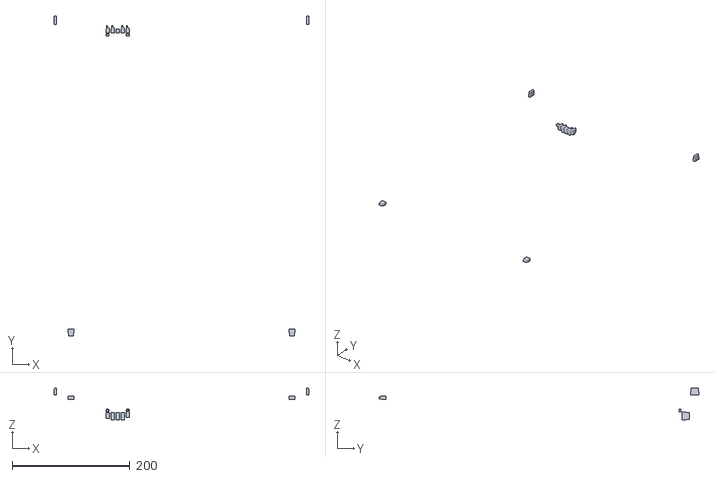
[picture p71: CAD file, 2026-11-10]
hardware/stl/detail/static_nylon.stl
433.0 x 542.7 x 53.8
