beetlebugorg/penplotter/hardware/stl/sim2/x_motor.stl

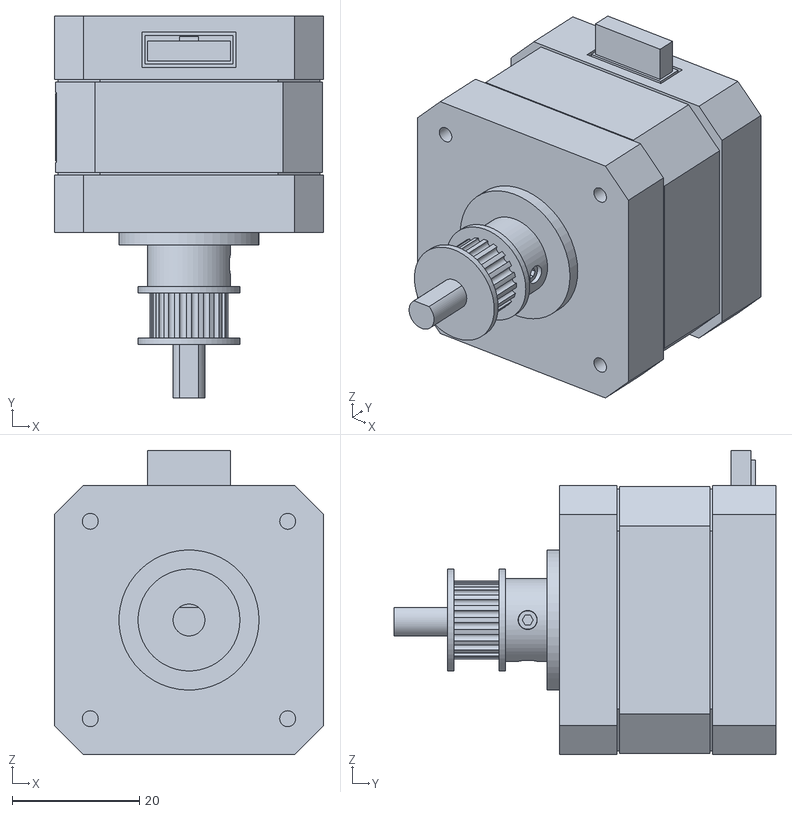
[picture p72: CAD file, 2026-11-12]
hardware/stl/sim2/x_motor.stl
42.3 x 60.0 x 47.8
