beetlebugorg/penplotter/hardware/stl/detail/static_pcb.stl

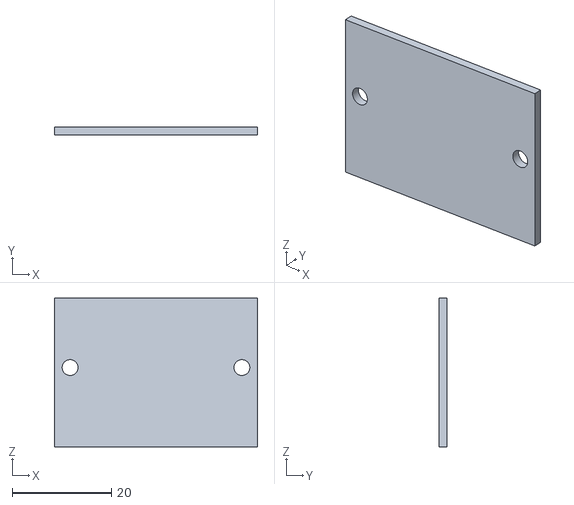
[picture p73: CAD file, 2026-11-10]
hardware/stl/detail/static_pcb.stl
41.0 x 1.60 x 30.0
