beetlebugorg/penplotter/hardware/stl/sim2/fasteners_pen.stl

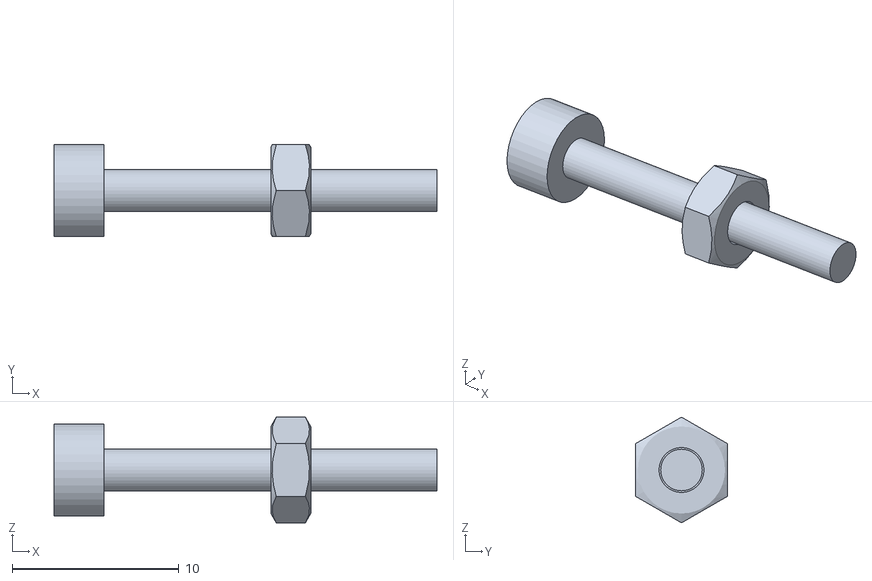
[picture p74: CAD file, 2026-11-12]
hardware/stl/sim2/fasteners_pen.stl
23.0 x 5.50 x 6.35
