beetlebugorg/penplotter/hardware/stl/detail/static_pcb_dark.stl

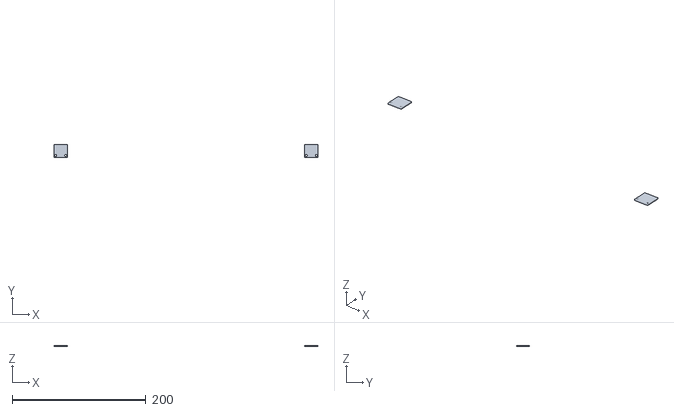
[picture p75: CAD file, 2026-11-10]
hardware/stl/detail/static_pcb_dark.stl
395.0 x 20.1 x 1.60
