beetlebugorg/penplotter/hardware/stl/detail/ctrl_rubber.stl

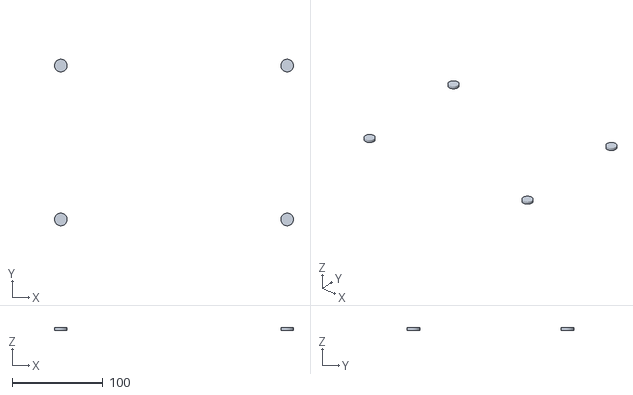
[picture p76: CAD file, 2026-11-10]
hardware/stl/detail/ctrl_rubber.stl
264.0 x 184.0 x 3.50
