beetlebugorg/penplotter/hardware/stl/sim2/belt_clips_gantry.stl

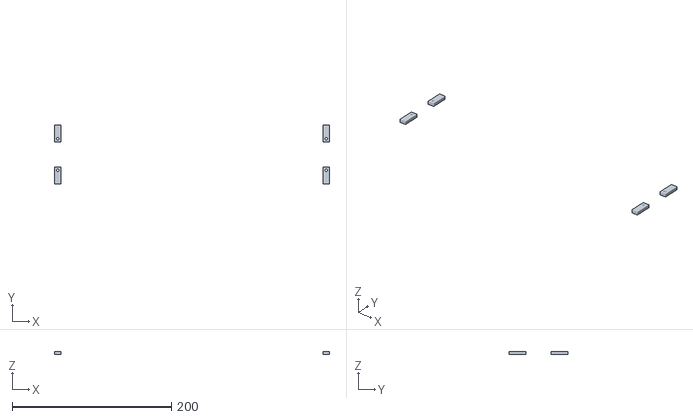
[picture p77: CAD file, 2026-11-12]
hardware/stl/sim2/belt_clips_gantry.stl
345.2 x 73.6 x 4.00
