beetlebugorg/penplotter/hardware/stl/detail/ctrl_box.stl

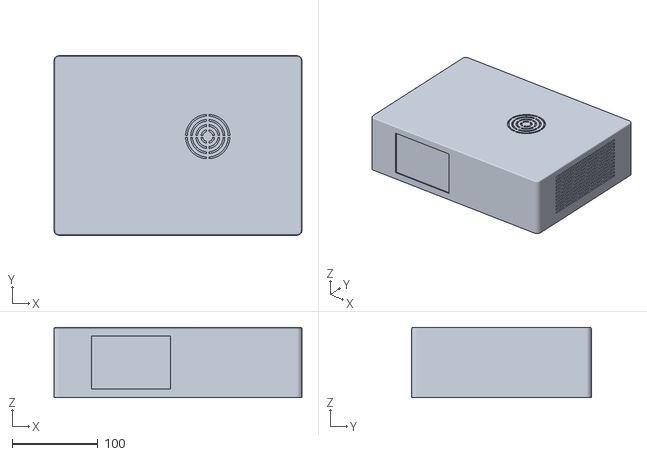
[picture p78: CAD file, 2026-11-10]
hardware/stl/detail/ctrl_box.stl
290.0 x 210.0 x 82.0
