beetlebugorg/penplotter/hardware/stl/sim2/belt_ends_carriage.stl

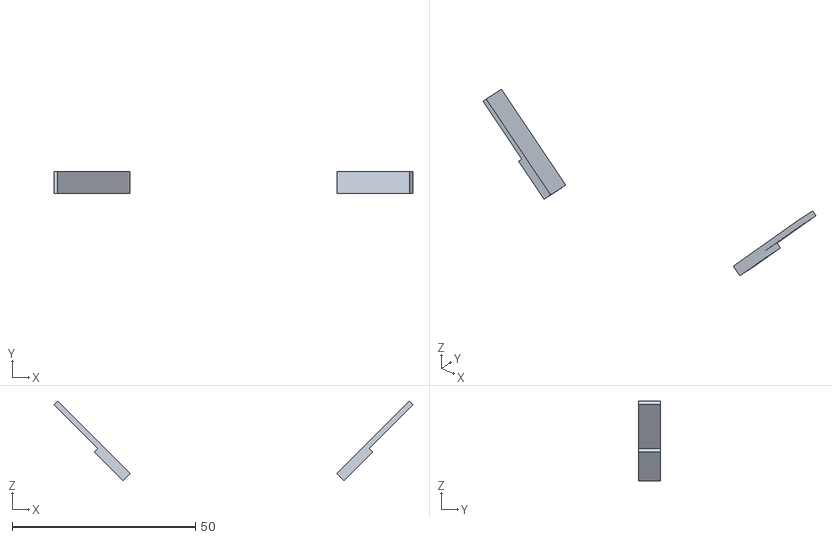
[picture p79: CAD file, 2026-11-12]
hardware/stl/sim2/belt_ends_carriage.stl
97.9 x 6.00 x 21.8
