beetlebugorg/penplotter/hardware/stl/detail/static_smd.stl

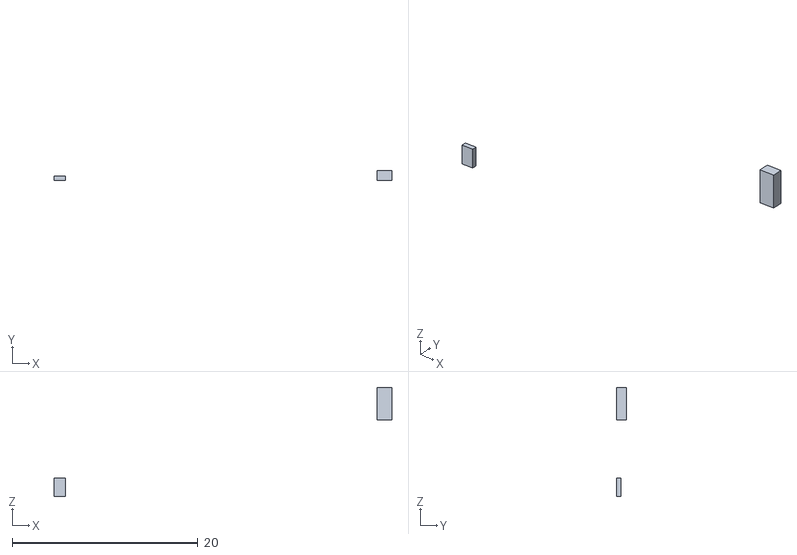
[picture p80: CAD file, 2026-11-10]
hardware/stl/detail/static_smd.stl
36.4 x 1.10 x 11.8
