beetlebugorg/penplotter/hardware/stl/detail/static_smd_light.stl

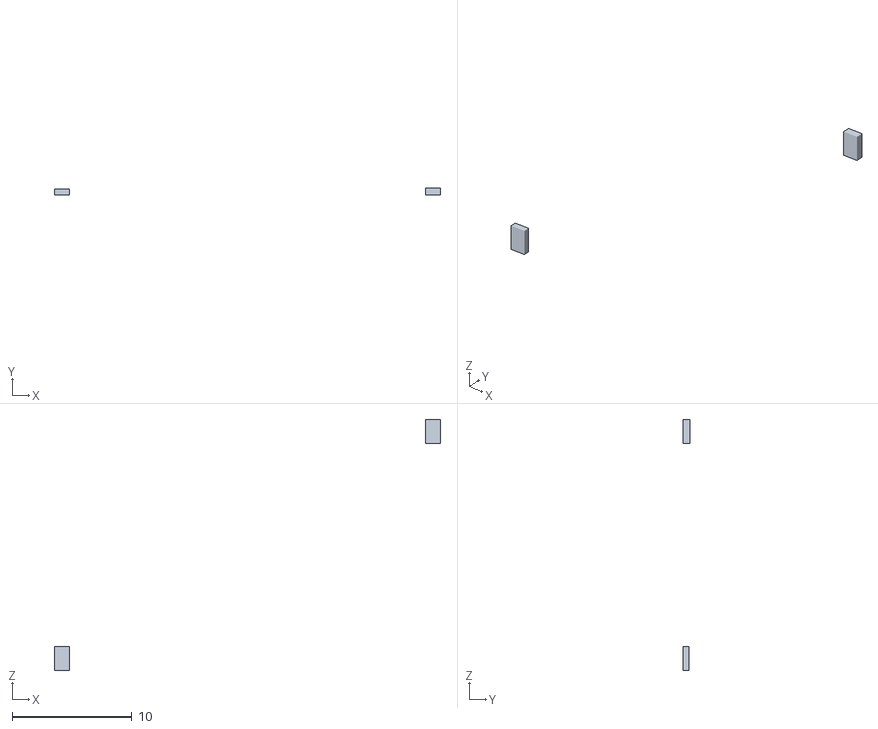
[picture p81: CAD file, 2026-11-10]
hardware/stl/detail/static_smd_light.stl
32.2 x 0.6 x 21.0
