beetlebugorg/penplotter/hardware/stl/detail/ctrl_wire_red.stl

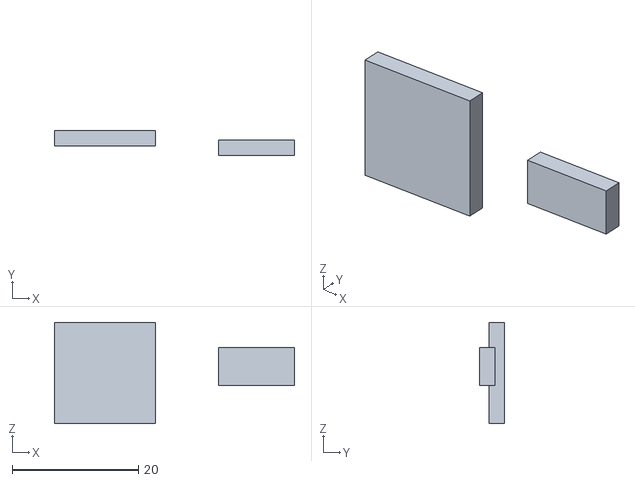
[picture p82: CAD file, 2026-11-10]
hardware/stl/detail/ctrl_wire_red.stl
38.0 x 4.00 x 16.0
