beetlebugorg/penplotter/hardware/stl/sim2/y_endstops.stl

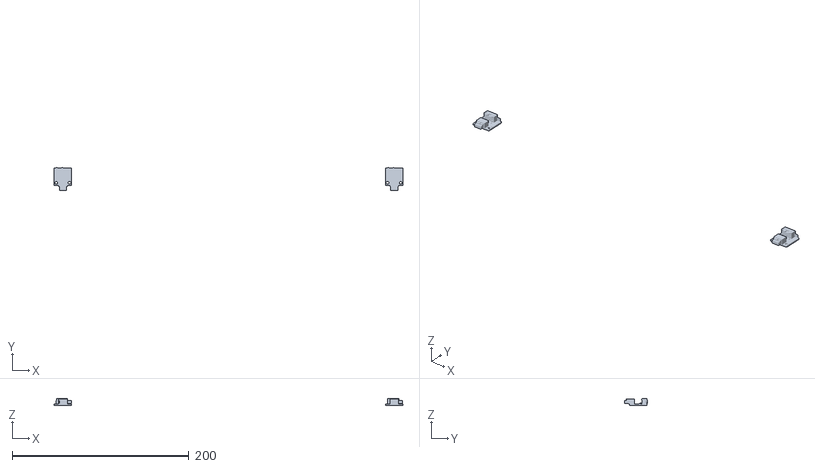
[picture p83: CAD file, 2026-11-12]
hardware/stl/sim2/y_endstops.stl
395.0 x 26.2 x 8.10
