beetlebugorg/penplotter/hardware/stl/detail/static_black_plastic.stl

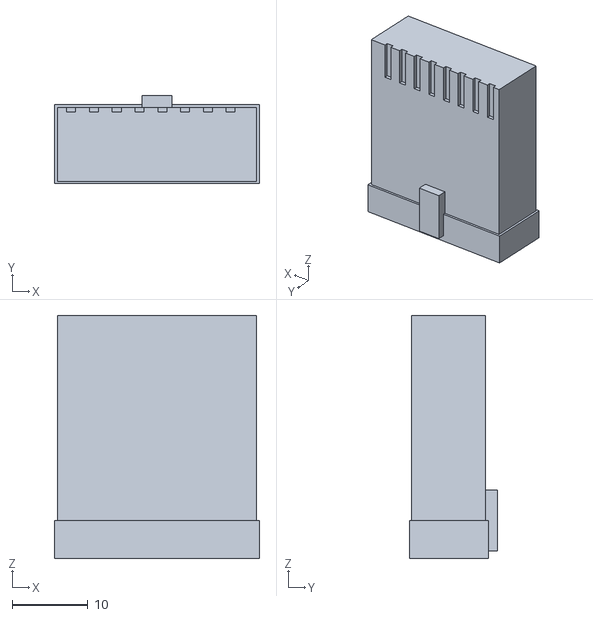
[picture p84: CAD file, 2026-11-10]
hardware/stl/detail/static_black_plastic.stl
27.0 x 11.6 x 32.0
