beetlebugorg/penplotter/hardware/stl/sim2/head_board.stl

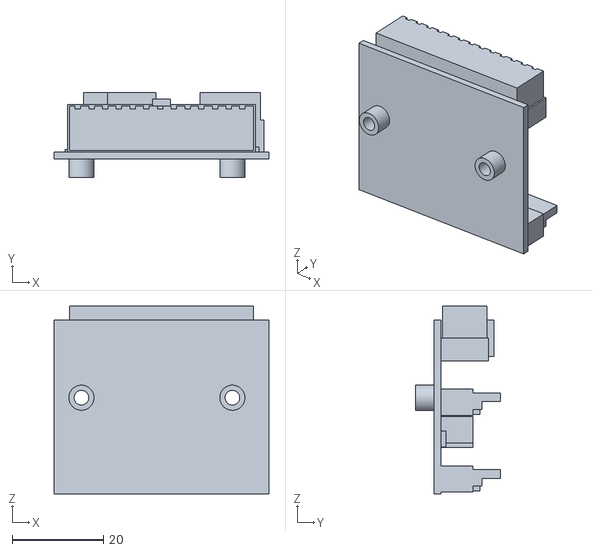
[picture p85: CAD file, 2026-11-12]
hardware/stl/sim2/head_board.stl
47.0 x 18.6 x 41.0
