beetlebugorg/penplotter/hardware/stl/detail/static_motor_stack.stl

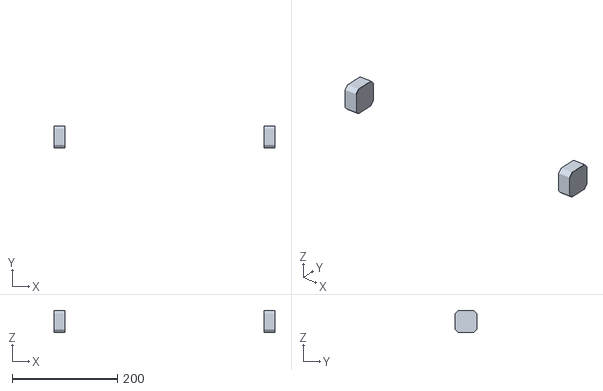
[picture p86: CAD file, 2026-11-10]
hardware/stl/detail/static_motor_stack.stl
419.1 x 42.0 x 42.0
