beetlebugorg/penplotter/hardware/stl/detail/static_motor_cap.stl

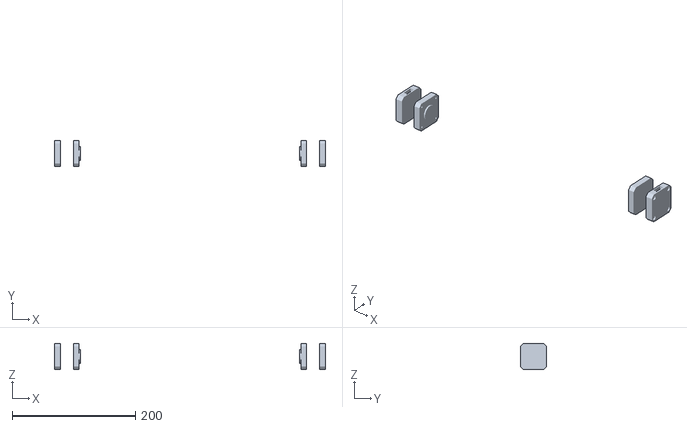
[picture p87: CAD file, 2026-11-10]
hardware/stl/detail/static_motor_cap.stl
439.1 x 42.3 x 42.3
