beetlebugorg/penplotter/hardware/stl/detail/ctrl_box_vent.stl

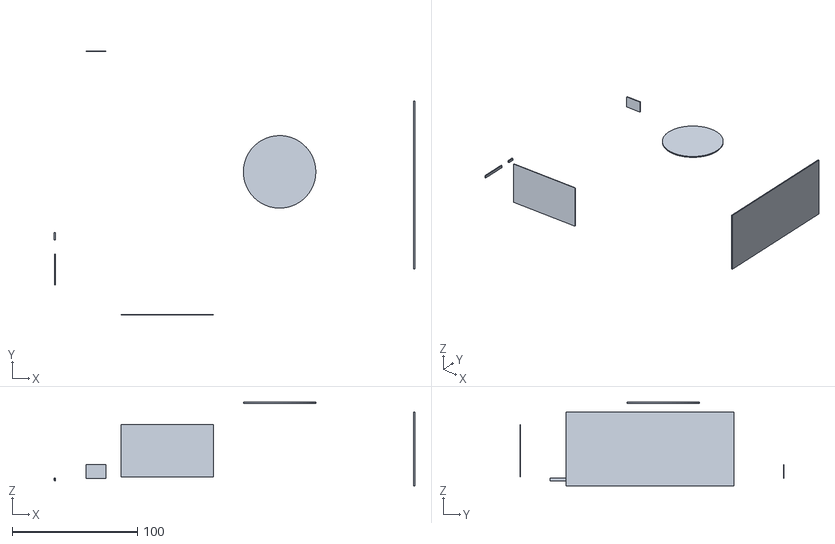
[picture p88: CAD file, 2026-11-10]
hardware/stl/detail/ctrl_box_vent.stl
288.5 x 211.2 x 67.0
