beetlebugorg/penplotter/hardware/stl/detail/static_label.stl

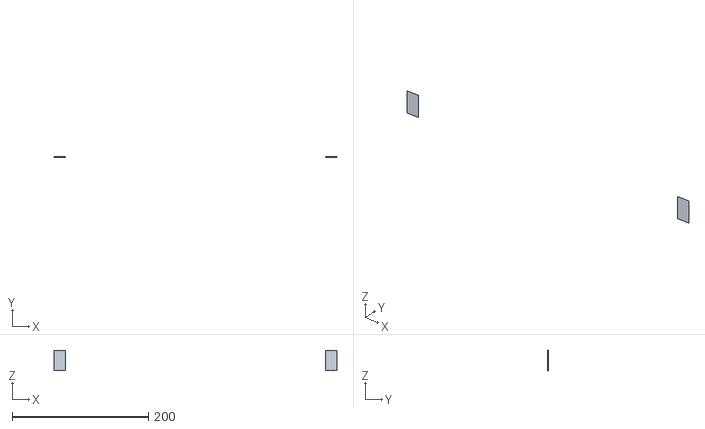
[picture p89: CAD file, 2026-11-10]
hardware/stl/detail/static_label.stl
414.7 x 0.15 x 29.6
