beetlebugorg/penplotter/hardware/stl/sim2/pen.stl

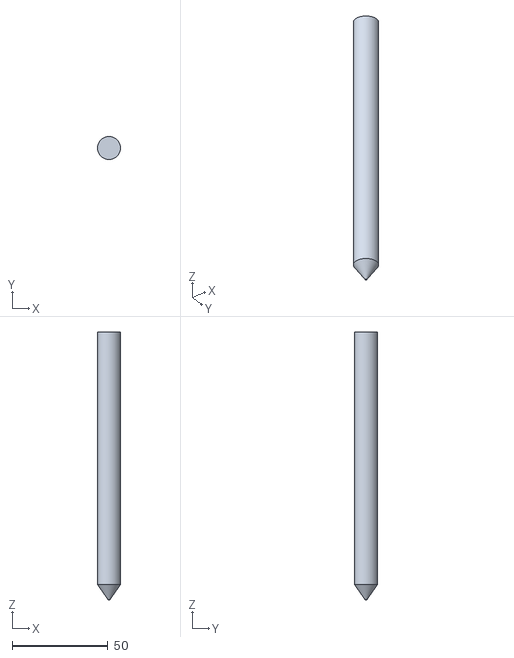
[picture p90: CAD file, 2026-11-10]
hardware/stl/sim2/pen.stl
12.0 x 12.0 x 140.0
