beetlebugorg/penplotter/hardware/stl/detail/static_switch.stl

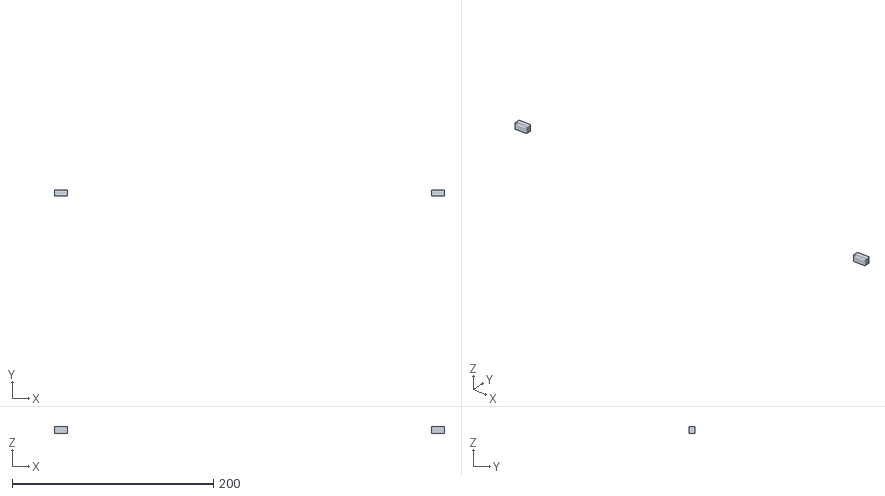
[picture p91: CAD file, 2026-11-10]
hardware/stl/detail/static_switch.stl
387.8 x 5.80 x 6.50
