beetlebugorg/penplotter/hardware/stl/sim2/y_stepper_right.stl

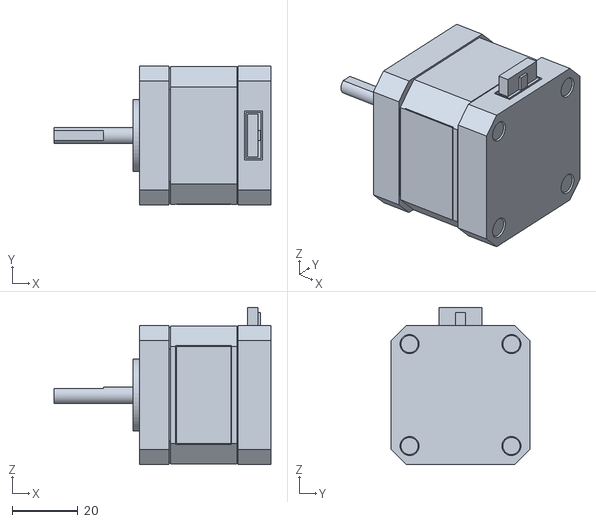
[picture p92: CAD file, 2026-11-10]
hardware/stl/sim2/y_stepper_right.stl
66.0 x 42.3 x 47.8
