beetlebugorg/penplotter/hardware/stl/detail/static_plunger.stl

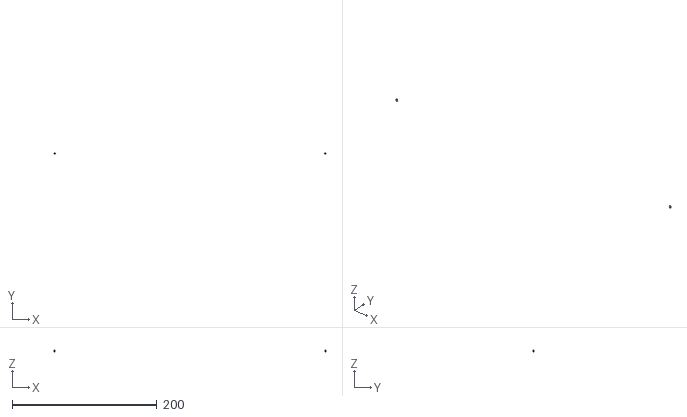
[picture p93: CAD file, 2026-11-10]
hardware/stl/detail/static_plunger.stl
376.4 x 0.6 x 2.60
