beetlebugorg/penplotter/hardware/stl/detail/ctrl_steel.stl

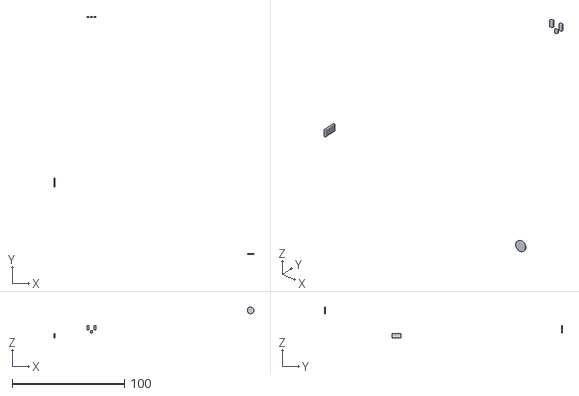
[picture p94: CAD file, 2026-11-10]
hardware/stl/detail/ctrl_steel.stl
178.4 x 212.6 x 27.5
