beetlebugorg/penplotter/hardware/stl/detail/ctrl_black_plastic.stl

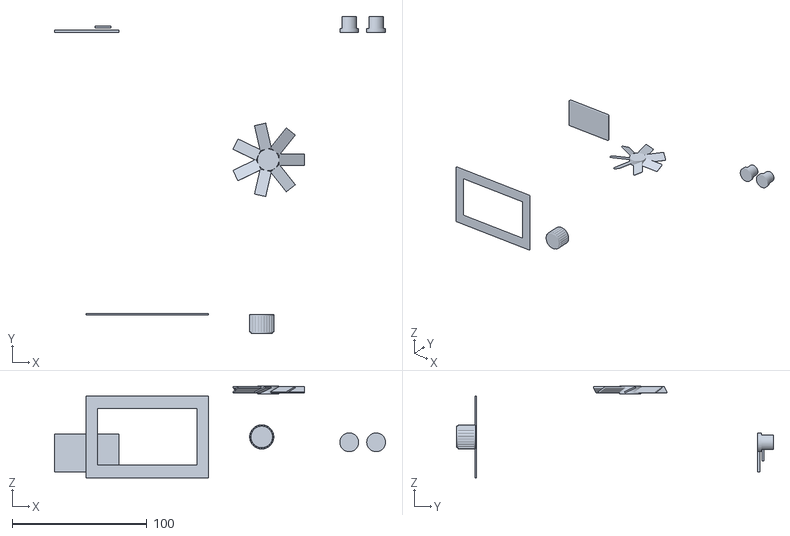
[picture p95: CAD file, 2026-11-10]
hardware/stl/detail/ctrl_black_plastic.stl
246.0 x 235.5 x 68.3
