beetlebugorg/penplotter/hardware/stl/sim2/y_pulleys_left.stl

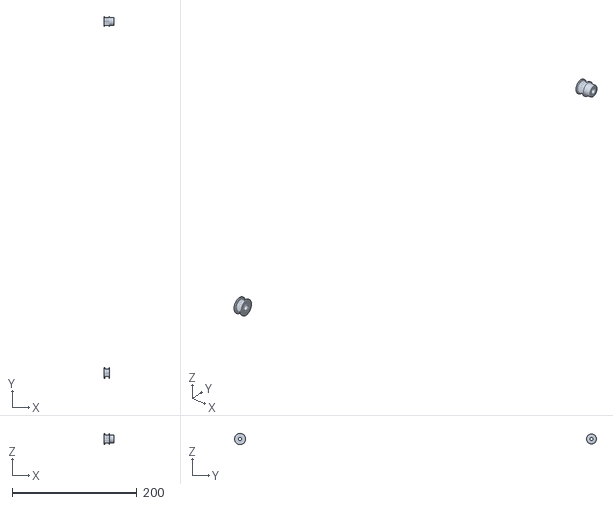
[picture p96: CAD file, 2026-11-10]
hardware/stl/sim2/y_pulleys_left.stl
16.1 x 581.0 x 18.0
