beetlebugorg/penplotter/hardware/stl/detail/static_gold.stl

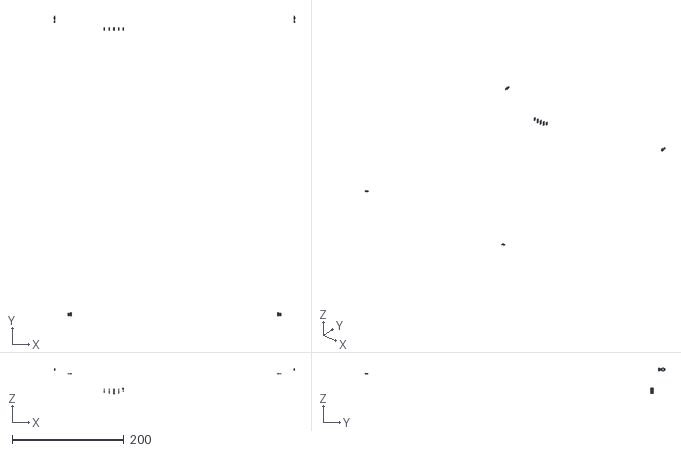
[picture p97: CAD file, 2026-11-10]
hardware/stl/detail/static_gold.stl
429.0 x 535.5 x 45.0
