beetlebugorg/penplotter/hardware/stl/sim2/base_board.stl

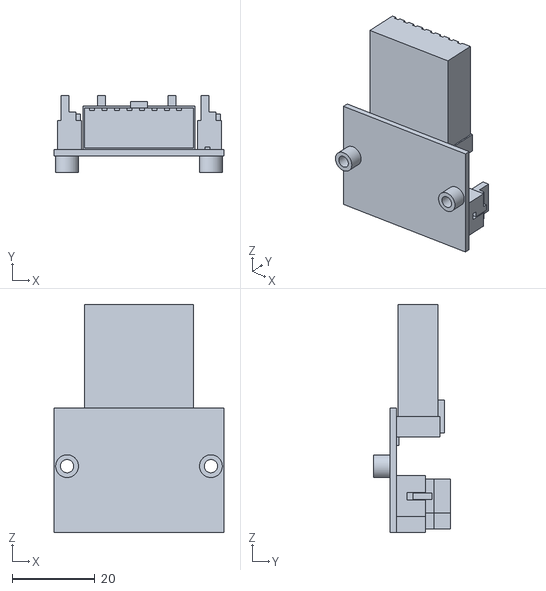
[picture p98: CAD file, 2026-11-10]
hardware/stl/sim2/base_board.stl
41.0 x 18.6 x 55.0
