beetlebugorg/penplotter/hardware/stl/sim2/horn.stl

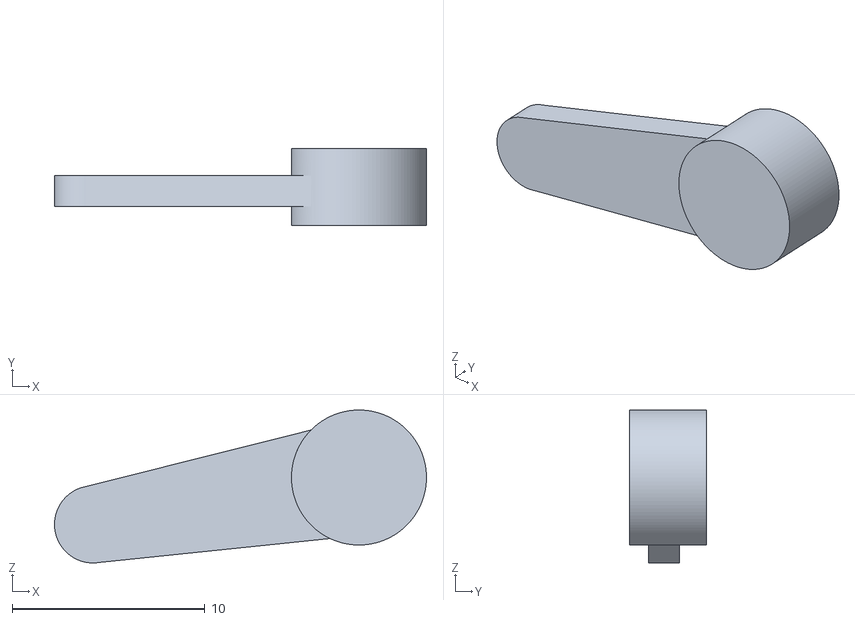
[picture p99: CAD file, 2026-11-10]
hardware/stl/sim2/horn.stl
19.3 x 4.00 x 7.93
