beetlebugorg/penplotter/(list of files, cad)

Other CAD files:
hardware/stl/hardware/carriage/insert_m3_heat_set_insert_5_7_mm-p0707_p0000_n0707.stl
hardware/cad/y_idler_fork.step
hardware/cad/y_front_right.step
hardware/stl/sim2/pen_slider.stl
hardware/stl/hardware/right/eccentric_eccentric_spacer_stock-zn.stl
hardware/cad/y_carriage_left.step
hardware/stl/hardware/left/clip_belt_jaw_printed-zp.stl
hardware/cad/x_carriage_plate.step
hardware/stl/hardware/yfront/insert_m3_heat_set_insert_5_7_mm-zp.stl
hardware/stl/sim2/x_pulley.stl
hardware/stl/detail/carriage_wire_red.stl
hardware/stl/sim2/x_idler_fork.stl
hardware/stl/hardware/left/spacer_m5_spacer_6_mm_stock-zn.stl
hardware/stl/hardware/right/insert_m3_heat_set_insert_5_7_mm-zp.stl
hardware/stl/hardware/left/eccentric_eccentric_spacer_stock-zn.stl
hardware/stl/hardware/right/wheel_v_wheel_stock-zn.stl
hardware/stl/detail/carriage_wire_orange.stl
hardware/cad/y_carriage_right.step
hardware/stl/sim2/y_idler_fork_left.stl
hardware/cad/y_motor_mount_left.step
hardware/cad/pen_carriage.step
hardware/stl/sim2/y_idler_bracket_right.stl
hardware/cad/y_idler_bracket_left.step
hardware/stl/sim2/mast_foot.stl
hardware/stl/sim2/y_idler_bracket_left.stl
hardware/stl/sim2/belt_clips_carriage.stl
hardware/stl/sim2/y_idler_fork_right.stl
hardware/stl/sim2/y_chain_anchor.stl
hardware/stl/sim2/y_front_left.stl
hardware/stl/sim2/y_motor_mount_left.stl
hardware/stl/sim2/y_front_right.stl
hardware/stl/sim2/y_stepper_left.stl
hardware/stl/sim2/y_motor_mount_right.stl
hardware/stl/sim2/y_pulleys_right.stl
hardware/stl/belt_jaw.stl
hardware/stl/fit_rail.stl
hardware/stl/fit_slider.stl
hardware/stl/fit_wheel.stl
hardware/stl/hardware/anchor/screw_m3_x_10_socket_head-xn.stl
hardware/stl/hardware/anchor/screw_m5_x_12_socket_head-zn.stl
hardware/stl/hardware/anchor/tnut_m5_drop_in_t_nut-zp.stl
hardware/stl/hardware/carriage/nut_m3_nut-zp.stl
hardware/stl/hardware/carriage/nyloc_m5_nyloc_nut-yn.stl
hardware/stl/hardware/carriage/screw_m2_x_8_self_tapping_stock_in_the_servo_bag-yn.stl
hardware/stl/hardware/carriage/screw_m3_x_10_socket_head-n0707_p0000_n0707.stl
hardware/stl/hardware/carriage/screw_m3_x_10_socket_head-p0707_p0000_n0707.stl
hardware/stl/hardware/carriage/screw_m3_x_12_socket_head-yp.stl
hardware/stl/hardware/carriage/screw_m3_x_20_socket_head-xp.stl
hardware/stl/hardware/carriage/screw_m5_x_30_button_head_iso_7380-yp.stl
hardware/stl/hardware/carriage/screw_m5_x_35_button_head_iso_7380-yp.stl
hardware/stl/hardware/foot/nut_m3_nut-zp.stl
hardware/stl/hardware/foot/screw_m3_x_16_socket_head-xn.stl
hardware/stl/hardware/foot/screw_m5_x_12_socket_head-yp.stl
hardware/stl/hardware/foot/screw_m6_x_16_socket_head-zn.stl
hardware/stl/hardware/foot/tnut_m5_drop_in_t_nut-yn.stl
hardware/stl/hardware/left/nyloc_m5_nyloc_nut-zn.stl
hardware/stl/hardware/left/nyloc_m5_nyloc_nut-zp.stl
hardware/stl/hardware/left/screw_m3_x_10_socket_head-xn.stl
hardware/stl/hardware/left/screw_m3_x_10_socket_head-yn.stl
hardware/stl/hardware/left/screw_m3_x_10_socket_head-zp.stl
hardware/stl/hardware/left/screw_m3_x_8_socket_head-yn.stl
hardware/stl/hardware/left/screw_m5_x_12_socket_head-yp.stl
hardware/stl/hardware/left/screw_m5_x_35_socket_head-zn.stl
hardware/stl/hardware/left/screw_m5_x_35_socket_head-zp.stl
hardware/stl/hardware/left/tnut_m5_drop_in_t_nut-yn.stl
hardware/stl/hardware/right/nut_m3_nut-zp.stl
hardware/stl/hardware/right/nyloc_m5_nyloc_nut-yp.stl
hardware/stl/hardware/right/nyloc_m5_nyloc_nut-zn.stl
hardware/stl/hardware/right/nyloc_m5_nyloc_nut-zp.stl
hardware/stl/hardware/right/screw_m3_x_10_socket_head-zp.stl
hardware/stl/hardware/right/screw_m3_x_20_socket_head-xp.stl
hardware/stl/hardware/right/screw_m5_x_12_socket_head-yp.stl
hardware/stl/hardware/right/screw_m5_x_30_socket_head-yn.stl
hardware/stl/hardware/right/screw_m5_x_35_socket_head-zn.stl
hardware/stl/hardware/right/screw_m5_x_35_socket_head-zp.stl
hardware/stl/hardware/right/tnut_m5_drop_in_t_nut-yn.stl
hardware/stl/hardware/right/washer_m5_washer_7_5_mm_across_small-yn.stl
hardware/stl/hardware/yfront/nut_m3_nut-zp.stl
hardware/stl/hardware/yfront/nyloc_m5_nyloc_nut-xp.stl
hardware/stl/hardware/yfront/screw_m3_x_12_socket_head-zp.stl
hardware/stl/hardware/yfront/screw_m3_x_20_socket_head-yn.stl
hardware/stl/hardware/yfront/screw_m3_x_8_socket_head-zp.stl
hardware/stl/hardware/yfront/screw_m5_x_12_countersunk_iso_10642-yn.stl
hardware/stl/hardware/yfront/screw_m5_x_12_socket_head-zp.stl
hardware/stl/hardware/yfront/screw_m5_x_30_socket_head-xn.stl
hardware/stl/hardware/yfront/tnut_m5_drop_in_t_nut-yp.stl
hardware/stl/hardware/yfront/tnut_m5_drop_in_t_nut-zn.stl
hardware/stl/hardware/yfront/washer_m5_washer_7_5_mm_across_small-xn.stl
hardware/stl/hardware/ymotor/screw_m3_x_10_socket_head-xp.stl
hardware/stl/hardware/ymotor/screw_m5_x_12_socket_head-yp.stl
hardware/stl/hardware/ymotor/tnut_m5_drop_in_t_nut-yn.stl
hardware/stl/mast_foot.stl
hardware/stl/pen_carriage.stl
hardware/stl/pen_slider.stl
hardware/stl/x_carriage_plate.stl
hardware/stl/x_idler_fork.stl
hardware/stl/y_carriage_left.stl
hardware/stl/y_carriage_right.stl
hardware/stl/y_chain_anchor.stl
hardware/stl/y_front_left.stl
hardware/stl/y_front_right.stl
hardware/stl/y_idler_bracket_left.stl
hardware/stl/y_idler_bracket_right.stl
hardware/stl/y_idler_fork.stl
hardware/stl/y_motor_mount_left.stl
hardware/stl/y_motor_mount_right.stl
