beetlebugorg/penplotter/hardware/penplotter-build-guide.pdf

# PEN PLOTTER

# A table plotter from a CR-10 V3

The base frame of a CR-10 V3 stands on the table, and the table is the bed. Stock V-wheels carry both axes: three under each flat Y carriage plate, in the side slots of the frame rail, and three on the printed X plate on the beam. The X belt runs in the top and bottom slots of the beam, as on the stock CR-10. Two Y motors stand still behind the back bar and move the gantry, and homing squares it on two switches. A servo lifts a pen slider on a dovetail rail; the weight of the slider and the pen is the pen force. The stock CR-10 V3 control box stands beside the frame, and the stock harness stays. Its two breakout boards stand on nylon standoffs, held by cable ties. The firmware is written in Go and runs on the ATmega2560 of the stock board. A camera and plotstudio place a drawing on the paper

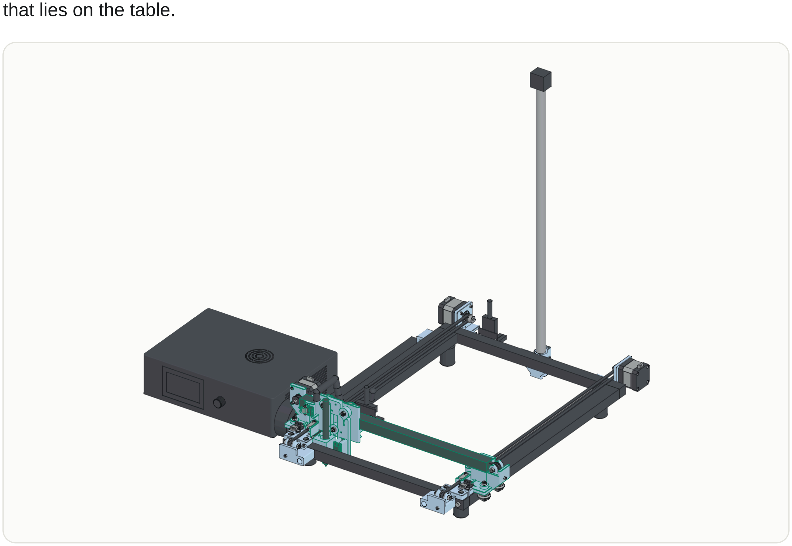
[picture p139: figure]
that lies on the table.

The plotter at home, from the front right, with the control box at the left. Travel 246 × 395 mm.

Measurements. The frame sizes are measured. The servo sizes, the wheel sizes, the breakout boards and the control box are data sheet values or estimates. Print the fit tests first. MEASURE.md lists the measurements to take.

CR-10 V3 table plotter · build guide | 1

## Printed parts

Part | Size on the bed (mm) | Print time Filament Length | Cost
fit_rail | 18 × 20 × 12 | 10 min | 3 g | 0.4 m $0.06
fit_slider | 30 × 31 × 13 | 22 min | 6 g | 0.8 m $0.12
fit_wheel | 76 × 12 × 6 | 17 min | 5 g | 0.6 m $0.10
y_carriage_left | 99 × 82 × 62 | 3 h 53 min | 68 g | 8.6 m $1.36
y_carriage_right | 98 × 82 × 50 | 3 h 39 min | 66 g | 8.3 m $1.32
x_carriage_plate | 97 × 35 × 74 | 2 h 46 min | 50 g | 6.4 m $1.00
y_front_left | 53 × 45 × 14 | 42 min | 12 g | 1.5 m $0.24
y_front_right | 53 × 45 × 14 | 42 min | 12 g | 1.5 m $0.24
y_idler_fork × 2 | 24 × 16 × 30 | 51 min | 14 g | 1.8 m $0.28
y_idler_bracket_left | 53 × 29 × 36 | 1 h 16 min | 23 g | 2.9 m $0.46
y_idler_bracket_right | 53 × 29 × 36 | 1 h 16 min | 23 g | 2.9 m $0.46
y_motor_mount_left | 50 × 49 × 46 | 1 h 08 min | 19 g | 2.4 m $0.38
y_motor_mount_right | 50 × 49 × 46 | 1 h 08 min | 19 g | 2.4 m $0.38
y_chain_anchor | 54 × 37 × 32 | 40 min | 12 g | 1.5 m $0.24
x_idler_fork | 16 × 24 × 30 | 25 min | 7 g | 0.9 m $0.14
pen_carriage | 58 × 119 × 26 | 2 h 09 min | 38 g | 4.8 m $0.76
pen_slider | 38 × 31 × 40 | 54 min | 16 g | 2.0 m $0.32
mast_foot | 70 × 41 × 47 | 1 h 23 min | 23 g | 2.9 m $0.46
belt_jaw × 6 | 21 × 8 × 4 | 19 min | 6 g | 0.6 m $0.12

Total (25 parts, with the
fit tests) | 23 h 59 min | 422 g 53.2 m $8.44

Print time, filament and cost from slices with the Cura profiles of this project (CuraEngine, 0.3 mm layers, PLA, TAZ Workhorse SE 0.5 mm), with the skirt. The print times are CuraEngine estimates. Cost at $19.99/kg. The fit test parts are for the first print only. The camera pole foot is optional.

## Hardware

1×

The stock CR-10 V3 control box (v2.5.2 board, 350 W supply, LCD, knob) and its harness, with the two breakout boards
3×

NEMA 17 steppers from the CR-10 (on hand): one 42-34 for X (it rides on the gantry: shorter and lighter), two 42-40 for Y1 and Y2
9×

Stock V-wheels (625 bearings): 3 for the X plate and 6 for the Y carriages, with 6 × 6 mm spacers and 3 eccentric spacers (from the stock X plate, the Z carriages and the bed carriage)
6×

M5 × 35 socket head screws and M5 nyloc nuts: the outer Y wheel axles, front and back (4, the head under the wheel, the nut on the 6 mm boss), and the inner Y wheel axles, the head on the 12 mm boss (2)
3×

X wheel axles: M5 × 30 (top left), M5 × 35 (top right, eccentric) and M5 × 35 (bottom), each with an M5 nyloc nut in front; 2 stock 6 mm spacers
17×

M5 drop-in T-nuts for 2020 slots: 4 for the Y front bases, 2 for the ears of the Y idler brackets, 4 for the Y motor brackets, 2 for the beam, 1 for the Y chain anchor, 2 for the camera pole foot, and 2 spare
2×

M5 × 12 countersunk screws (ISO 10642): the ears of the Y idler brackets, into T-nuts in the front face slot of the front bar
13×

M5 × 12 screws: the front bases (4), the Y motor brackets (4), the beam (2, through the back wall of each saddle into the back slot), the Y chain anchor (1), the camera pole foot (2) (T-nuts above)
3×

Idler forks: an M5 × 30 axle through both cheeks with 2 small washers and a nyloc nut, and an M3 × 20 tension screw with an M3 nut (one X fork, two Y forks)
3× | GT2 20T toothed idlers, 5 mm bore: one X idler, two Y idlers
6× | Belt jaws (printed), each with an M3 × 10 screw and an M3 heat-set insert: 2 on each Y carriage and 2 on the X plate
4× | M3 × 12 screws from the back of the X plate into the pen carriage (T1, T2, H1, H2); they cut their own thread
11×
| Motor screws, M3 × 10: 3 for the X motor (from the front of its wall), 8 for the Y motors (4 each, from inside the bracket)
4× | M3 × 10 screws: the two end links of the Y chain; they cut their own thread
3×
| Creality endstop boards (the stock X, Y and Z boards: 20 × 20 mm, KW12 switch, XH plug), 6 M3 × 8 screws and 6 M3 heat-set inserts (the belt jaws have 6 more)
4× | Nylon M3 standoffs, 4 mm: two under each breakout board
1× | 3-wire servo pigtail with an XH 5-pin plug: the pen servo on BL_T of the head board
1×
| 1/2 inch split wire loom (on hand), about 34 cm: the servo lead from the head board to the X plate, a free loop behind the beam

1×

| Openable drag chain, inner 10 × 20 mm (10 × 15 is enough now), R28, about 0.5 m (cut from 1 m): the head harness only

18×

| Cable ties, 2.5 mm: 2 for each breakout board (through the board holes and round the extrusion), 1 at each end of the servo loom, and 12 for the harness on the gantry and on the back bar
1× | MG90S or SG90 servo, with its horn and its two screws
1×
| GT2 open belt, 2 mm pitch, 6 mm wide, glass fibre, 5 m roll (the two Y belts are 1.12 m each and the X belt 0.88 m between the folds); 3 20T pulleys (5 mm bore) and 3 20T toothed idlers (5 mm bore)

1×

| Camera pole foot (optional): 2 M5 × 12 screws (T-nuts above), 1 M6 × 16 screw into the pole end, 1 M3 × 16 screw and an M3 nut for the collar

1×

| Calipers, hex keys (2.5, 3, 4, 5 mm), the wrench for the stock eccentric spacers (8 mm, as on the CR-10), and a soldering iron with an M3 heat-set insert tip

The electronics and the sources are in docs/bom.md of the project.

## Print

Profiles

One Cura profile for each part: run python3 cura/make_profiles.py -install with Cura closed, then pick “Pen plotter - …”.

Material

PLA, 2.85 mm, 0.5 mm nozzle. PLA softens at about 55 °C. Keep the printed parts out of the sun and away from heat.
Temperature 220 °C nozzle (215 °C first layer), 60 °C bed, fan 100 %. The PLA values of the desiccant project on this printer.

Layers

0.3 mm layers, 0.9 mm top and bottom, 15 % gyroid infill, skirt. 3 walls (1.5 mm). The rail fit test has 4 walls (2 mm). Outer walls 40 mm/s.
Supports Off. A slice with supports on (60°, everywhere) adds 0 g of support to each part.
The STL files are in their print orientation. Load them, do not turn them. The settings are for the LulzBot TAZ

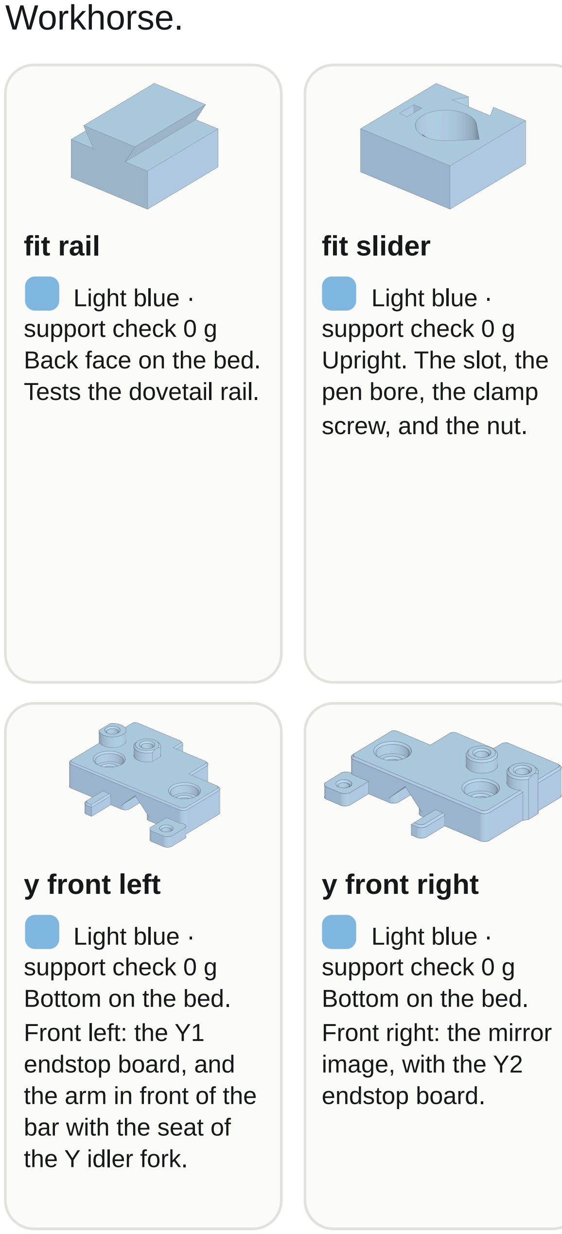
[picture p140: figure]
Workhorse.; fit rail; Light blue · support check 0 g Back face on the bed. Tests the dovetail rail.; fit slider; Light blue · support check 0 g Upright. The slot, the pen bore, the clamp screw, and the nut.; y front left; Light blue · support check 0 g Bottom on the bed. Front left: the Y1 endstop board, and the arm in front of the bar with the seat of the Y idler fork.; y front right; Light blue · support check 0 g Bottom on the bed. Front right: the mirror image, with the Y2 endstop board.
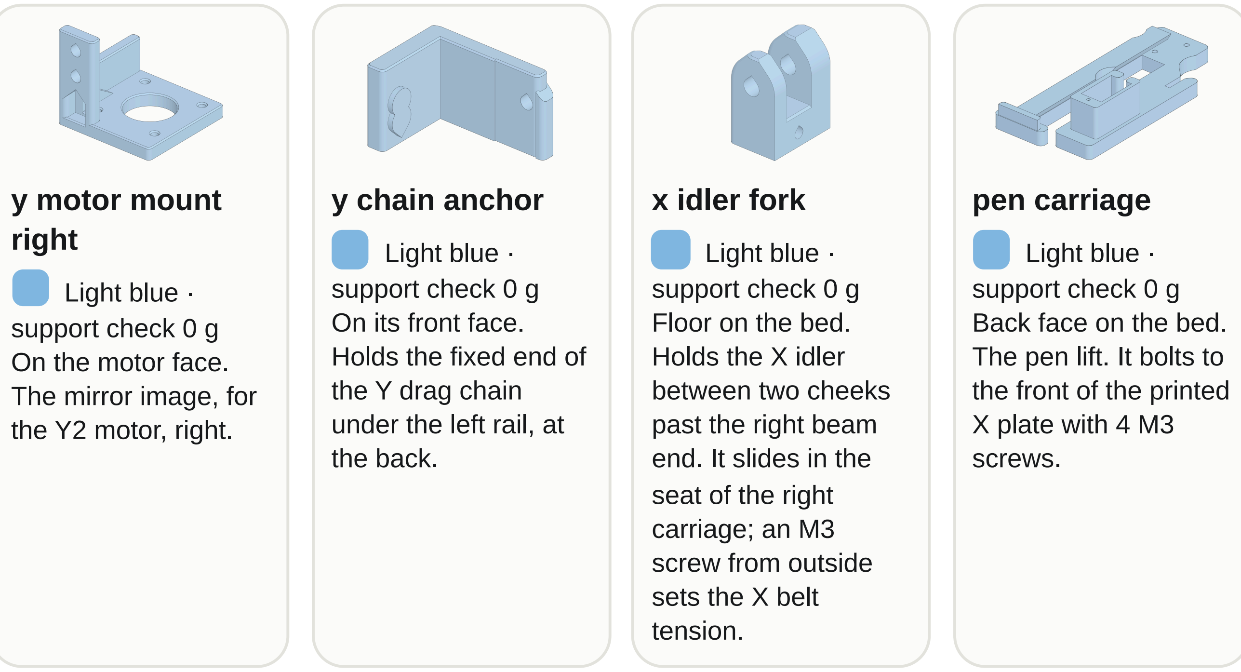
[picture p141: figure]
y motor mount right; Light blue · support check 0 g On the motor face. The mirror image, for the Y2 motor, right.; y chain anchor; Light blue · support check 0 g On its front face. Holds the fixed end of the Y drag chain under the left rail, at the back.; x idler fork; Light blue · support check 0 g Floor on the bed. Holds the X idler between two cheeks past the right beam end. It slides in the seat of the right carriage; an M3 screw from outside sets the X belt tension.; pen carriage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

belt jaw

Light blue ·
support check 0 g
Flat on the bed. Print
6: one for each belt
end (2 on each Y

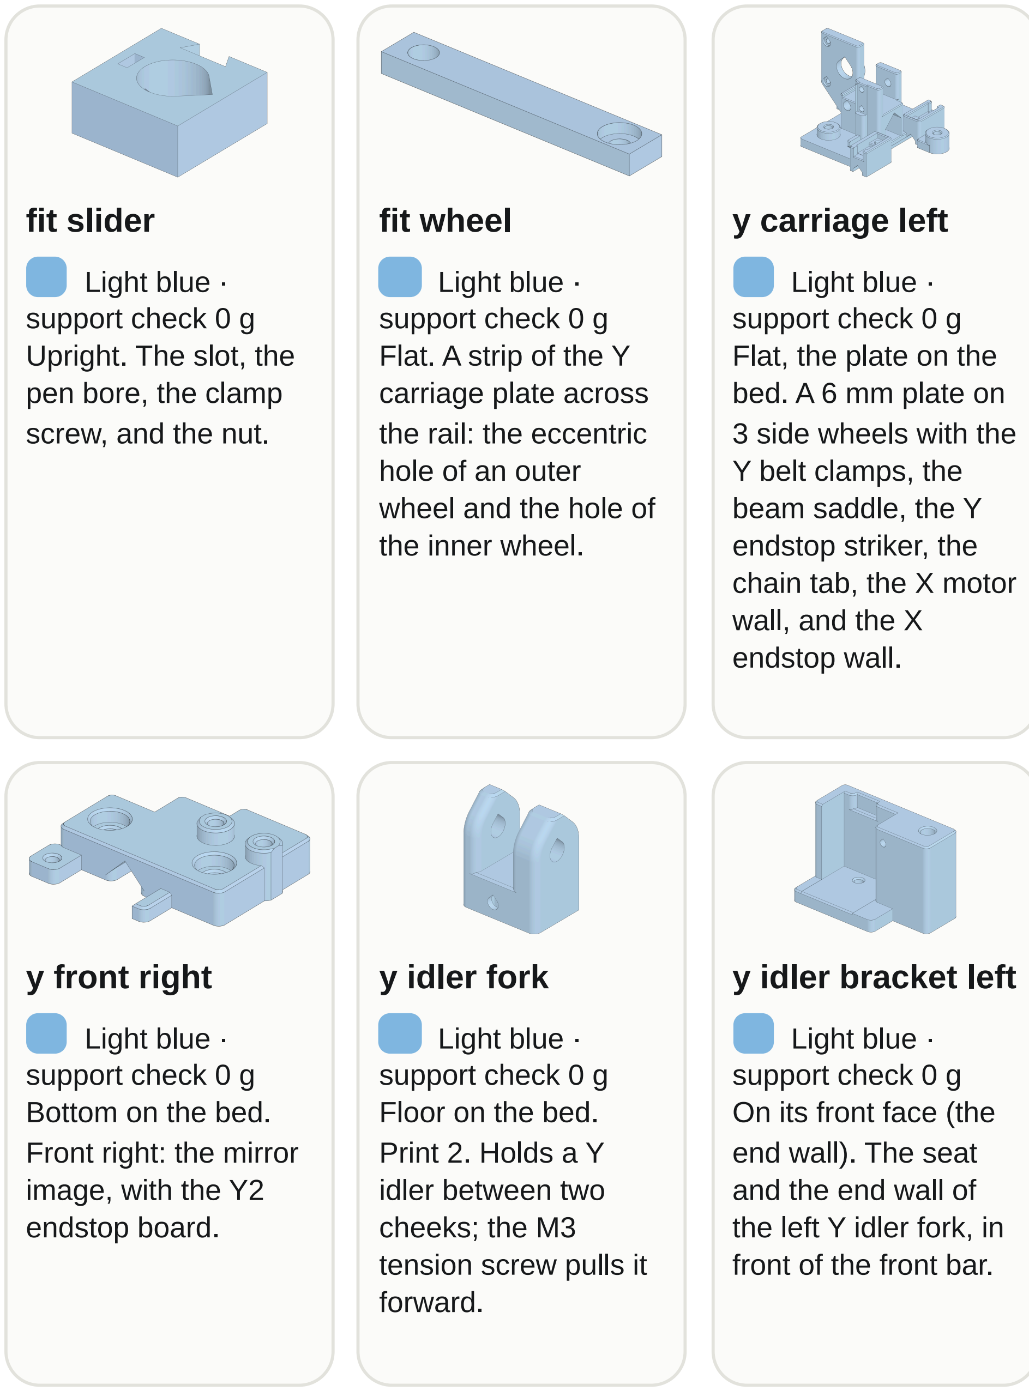
[picture p142: figure]
fit wheel; Light blue · support check 0 g Flat. A strip of the Y carriage plate across the rail: the eccentric hole of an outer wheel and the hole of the inner wheel.; y carriage left; Light blue · support check 0 g Flat, the plate on the bed. A 6 mm plate on 3 side wheels with the Y belt clamps, the beam saddle, the Y endstop striker, the chain tab, the X motor wall, and the X endstop wall.; y idler fork; Light blue · support check 0 g Floor on the bed. Print 2. Holds a Y idler between two cheeks; the M3 tension screw pulls it forward.; y idler bracket left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
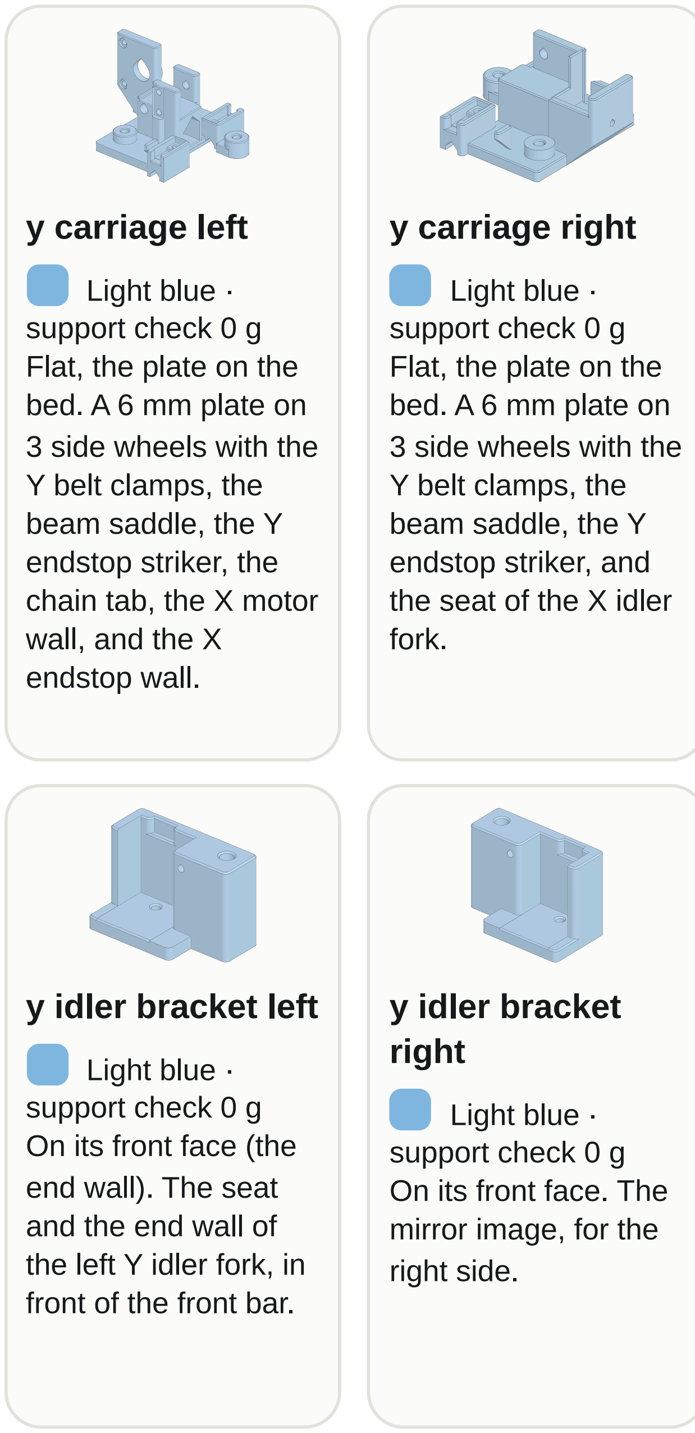
[picture p143: figure]
y carriage right; Light blue · support check 0 g Flat, the plate on the bed. A 6 mm plate on 3 side wheels with the Y belt clamps, the beam saddle, the Y endstop striker, and the seat of the X idler fork.; y idler bracket right; Light blue · support check 0 g On its front face. The mirror image, for the right side.
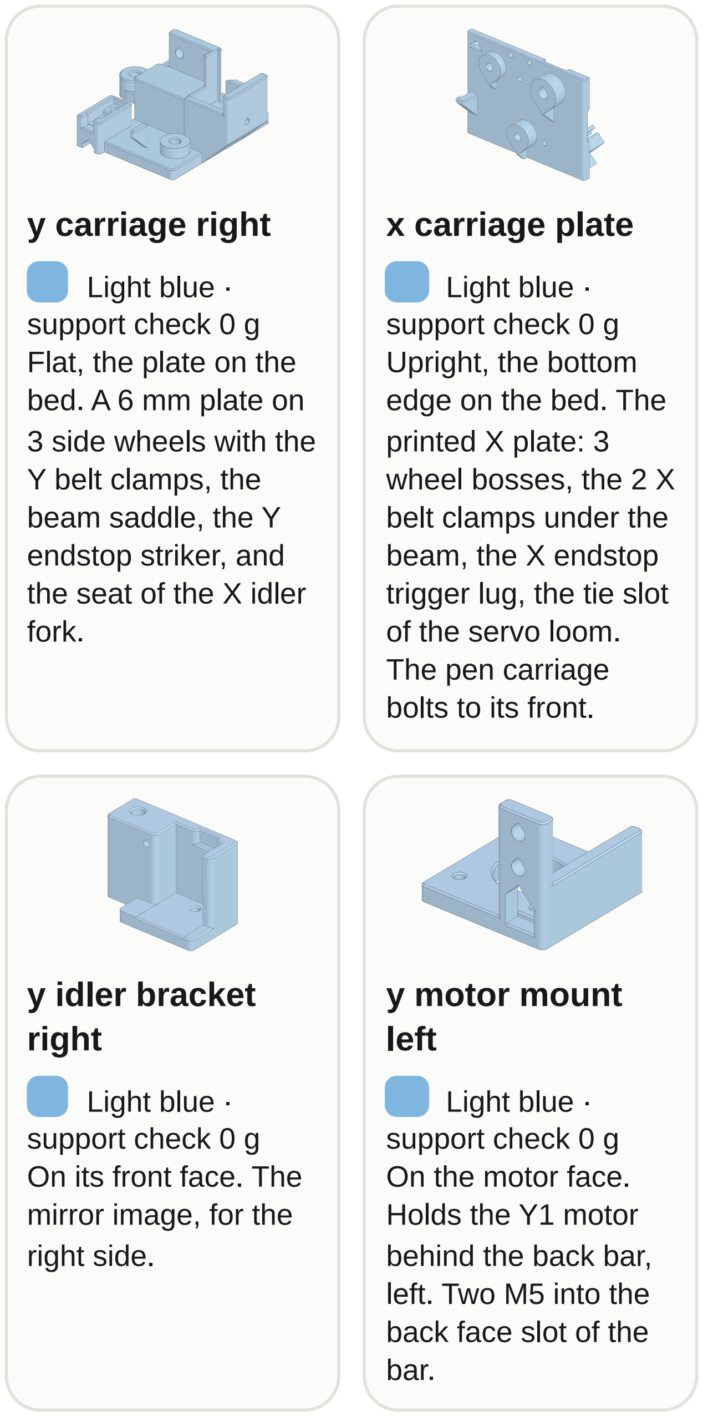
[picture p144: figure]
x carriage plate; Light blue · support check 0 g Upright, the bottom edge on the bed. The printed X plate: 3 wheel bosses, the 2 X belt clamps under the beam, the X endstop trigger lug, the tie slot of the servo loom. The pen carriage bolts to its front.; y motor mount left; Light blue · support check 0 g On the motor face. Holds the Y1 motor behind the back bar, left. Two M5 into the back face slot of the bar.
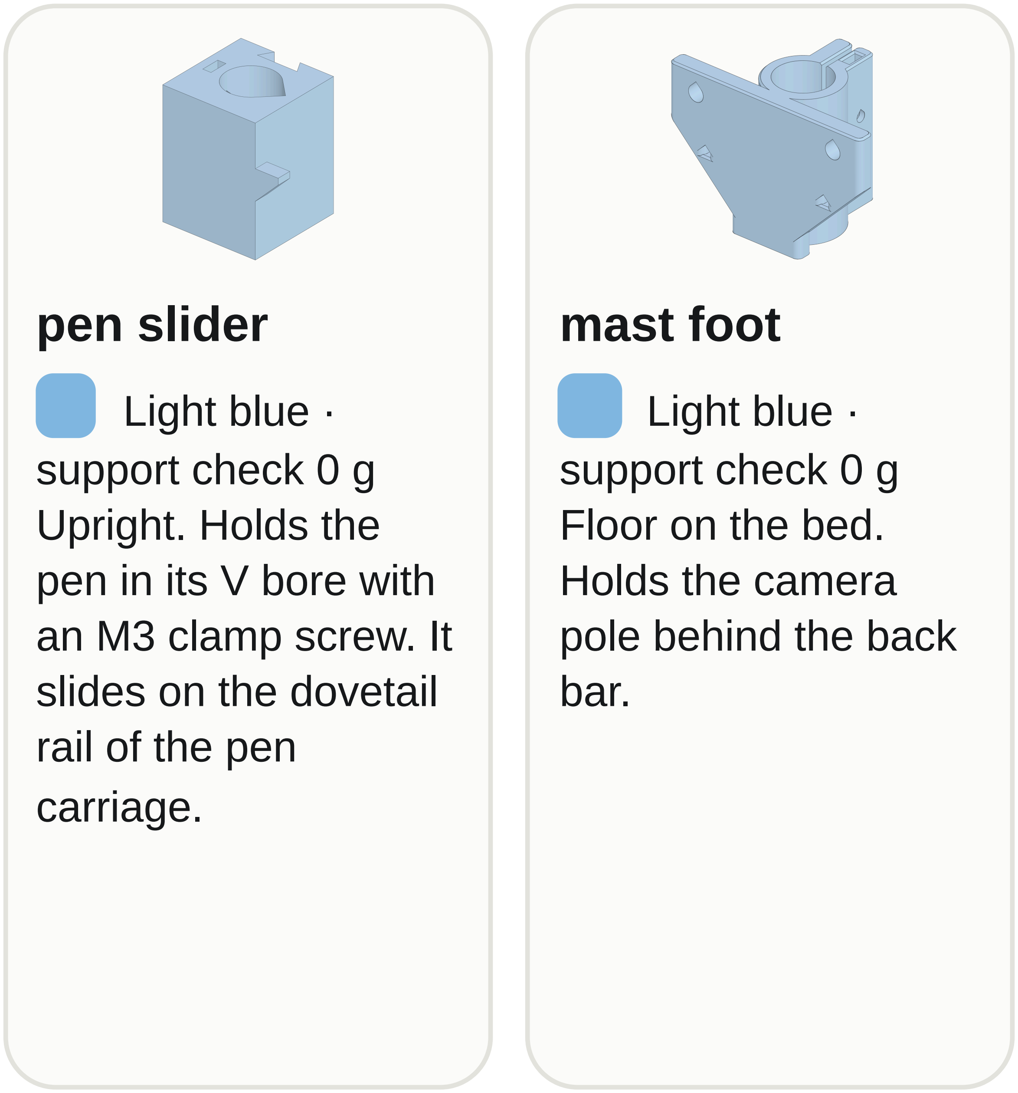
[picture p145: figure]
pen slider; Light blue · support check 0 g Upright. Holds the pen in its V bore with an M3 clamp screw. It slides on the dovetail rail of the pen carriage.; mast foot; Light blue · support check 0 g Floor on the bed. Holds the camera pole behind the back bar.

## Fasteners

The model has each screw, nut, washer, spacer and T-nut of the main build. The fit check moves them with the parts over the whole travel. No fastener touches a printed part, the frame, a belt or another fastener. The exceptions are the intended contacts: a T-nut in a slot, a screw in a motor thread or in a heat-set insert. The build uses 12 M3 heat-set inserts: 6 for the endstop boards and 6 for the belt jaws. Each wheel axle has a nyloc nut. The other M2 and M3 screws in plastic cut their own thread.

Part | Items | Fasteners
Frame (stock screws) | 8 | 8 × M5 × 30 socket head (stock)
Y front base, left | 8 | 2 × M3 heat-set insert, 5.7 mm, 2 × M3 × 8 socket head, 2 × M5 drop-in T-nut, 2 × M5 × 12 socket head
Y front base, right | 8 | 2 × M3 heat-set insert, 5.7 mm, 2 × M3 × 8 socket head, 2 × M5 drop-in T-nut, 2 × M5 × 12 socket head
Y idler fork, left | 5 | 1 × M3 nut, 1 × M5 nyloc nut, 2 × M5 washer, 7.5 mm across (small), 1 × M5 × 30 socket head
Y idler fork, right | 5 | 1 × M3 nut, 1 × M5 nyloc nut, 2 × M5 washer, 7.5 mm across (small), 1 × M5 × 30 socket head
Y motor bracket, left | 8 | 4 × M3 × 10 socket head, 2 × M5 drop-in T-nut, 2 × M5 × 12 socket head
Y motor bracket, right | 8 | 4 × M3 × 10 socket head, 2 × M5 drop-in T-nut, 2 × M5 × 12 socket head
Y idler bracket, left | 4 | 1 × M3 × 12 socket head, 1 × M3 × 20 socket head, 1 × M5 drop-in T-nut, 1 × M5 × 12 countersunk (ISO 10642)
Y idler bracket, right | 4 | 1 × M3 × 12 socket head, 1 × M3 × 20 socket head, 1 × M5 drop-in T-nut, 1 × M5 × 12 countersunk (ISO 10642)
Y chain anchor | 4 | 2 × M3 × 10 socket head, 1 × M5 drop-in T-nut, 1 × M5 × 12 socket head
Y carriage, left (X motor) | 26 | 4 × M3 heat-set insert, 5.7 mm, 7 × M3 × 10 socket head, 2 × M3 × 8 socket head, 1 × M5 drop-in T-nut, 3 × M5 nyloc nut, 2 × M5 spacer, 6 mm (stock), 1 × M5 × 12 socket head, 3 × M5 × 35 socket head, 2 × belt jaw (printed), 1 × eccentric spacer (stock)
Y carriage, right (X idler) | 18 | 2 × M3 heat-set insert, 5.7 mm, 2 × M3 × 10 socket head, 1 × M3 × 20 socket head, 1 × M5 drop-in T-nut, 3 × M5 nyloc nut, 2 × M5 spacer, 6 mm (stock), 1 × M5 × 12 socket head, 3 × M5 × 35 socket head, 2 × belt jaw (printed), 1 × eccentric spacer (stock)
X idler fork | 5 | 1 × M3 nut, 1 × M5 nyloc nut, 2 × M5 washer, 7.5 mm across (small), 1 × M5 × 30 socket head
Pen carriage | 2 | 2 × M2 × 8 self-tapping (stock, in the servo bag)
Pen slider | 2 | 1 × M3 nut, 1 × M3 × 20 socket head
X plate | 19 | 2 × M3 heat-set insert, 5.7 mm, 2 × M3 × 10 socket head, 4 × M3 × 12 socket head, 3 × M5 nyloc nut, 2 × M5 spacer, 6 mm (stock), 1 × M5 × 30 button head (ISO 7380), 2 × M5 × 35 button head (ISO 7380), 2 × belt jaw (printed), 1 × eccentric spacer (stock)
Camera pole foot (optional) | 7 | 1 × M3 nut, 1 × M3 × 16 socket head, 2 × M5 drop-in T-nut, 2 × M5 × 12 socket head, 1 × M6 × 16 socket head

To buy (in the model): 12 × M3 heat-set insert, 5.7 mm, 5 × M3 nut, 21 × M3 × 10 socket head, 6 × M3 × 12 socket head, 1 × M3 × 16 socket head, 4 × M3 × 20 socket head, 6 × M3 × 8 socket head, 15 × M5 drop-in T-nut, 12 × M5 nyloc nut, 6 × M5 washer, 7.5 mm across (small), 2 × M5 × 12 countersunk (ISO 10642), 13 × M5 × 12 socket head, 1 × M5 × 30 button head (ISO 7380), 3 × M5 × 30 socket head, 2 × M5 × 35 button head (ISO 7380), 6 × M5 × 35 socket head, 1 × M6 × 16 socket head, 6 × belt jaw (printed). Buy 2 more T-nuts as spares. Stock: 2 × M2 × 8 self-tapping (stock, in the servo bag), 6 × M5 spacer, 6 mm (stock), 8 × M5 × 30 socket head (stock), 3 × eccentric spacer (stock).

## Screw lengths

model.py checks each screw length. A screw into a T-nut needs at least 3 mm of thread in the T-nut, and its tip must stay out of the core of the extrusion. A screw that cuts its own thread needs enough thread in the plastic and must not reach the end of the pilot hole. A screw with a nut must stand at least 1 mm out of the nut. The slot and T-nut sizes are estimates (MEASURE.md).

Screws | Joint | Length check
8 × M5 × 30 socket head | frame (stock): M5 through the bar into the rail end | 10.0 mm of thread in a 15.0 mm thread (at least 5.0)
4 × M5 × 12 socket head | y_front: M5 into a T-nut | 4.0 mm in the T-nut, tip 6.0 mm into the slot (slot depth 6.3)
4 × M5 × 12 socket head | y_motor_mount: M5 into a T-nut | 4.0 mm in the T-nut, tip 6.0 mm into the slot (slot depth 6.3)
8 × M3 × 10 socket head | y_motor_mount: M3 into the Y motor | 4.0 mm of thread in a 4.5 mm thread (at least 2.5)
2 × M5 × 30 socket head | y_idler_fork: M5 Y idler axle through both cheeks (2 washers), nyloc nut | stands 1.5 mm out of the nut (at least 1)
2 × M3 × 12 socket head | y_idler_bracket: M3 through a lip of the front base into the bracket | 8.0 mm of thread in a 9.0 mm pilot (at least 6)
2 × M5 × 12 countersunk (ISO 10642) | y_idler_bracket: M5 into a T-nut | 3.7 mm in the T-nut, tip 5.5 mm into the slot (slot depth 6.3)
2 × M3 × 20 socket head | y_idler_bracket: M3 tension screw through the end wall into the nut of the fork (fork at the back end) | stands 2.1 mm out of the nut (at least 1)
4 × M3 × 8 socket head | y_front: M3 endstop board screw into a heat-set insert | 6.4 mm of thread in a 5.7 mm heat-set insert
1 × M5 × 12 socket head | y_chain_anchor: M5 into a T-nut | 4.0 mm in the T-nut, tip 6.0 mm into the slot (slot depth 6.3)
4 × M3 × 10 socket head | y_chain: M3 through an end link into the anchor or the carriage tab | 8.0 mm of thread in a 9.0 mm pilot (at least 6)
2 × M5 × 12 socket head | mast_foot: M5 into a T-nut | 4.0 mm in the T-nut, tip 6.0 mm into the slot (slot depth 6.3)
1 × M6 × 16 socket head | mast_foot: M6 into the pole end | 12.0 mm of thread in a 15.0 mm thread (at least 5.0)
1 × M3 × 16 socket head | mast_foot: M3 collar screw, M3 nut | stands 4.4 mm out of the nut (at least 1)
4 × M5 × 35 socket head | y_carriage: M5 outer wheel axle (head under the wheel), nyloc nut on the 6 mm boss | stands 1.8 mm out of the nut (at least 1)
2 × M5 × 35 socket head | y_carriage: M5 inner wheel axle (head on the 12 mm boss), nyloc nut under the wheel | stands 1.8 mm out of the nut (at least 1)
6 × M3 × 10 socket head | belt jaw: M3 through the jaw into a heat-set insert in the ledge | 5.7 mm of thread in a 5.7 mm heat-set insert
2 × M5 × 12 socket head | y_carriage: M5 into a T-nut | 4.0 mm in the T-nut, tip 6.0 mm into the slot (slot depth 6.3)
3 × M3 × 10 socket head | y_carriage: M3 into the X motor | 4.3 mm of thread in a 4.5 mm thread (at least 2.5)
2 × M3 × 8 socket head | y_carriage: M3 X endstop board screw into a heat-set insert | 6.4 mm of thread in a 5.7 mm heat-set insert
1 × M5 × 30 socket head | x_idler_fork: M5 X idler axle through both cheeks (2 washers), nyloc nut | stands 1.5 mm out of the nut (at least 1)
1 × M3 × 20 socket head | y_carriage: M3 X belt tension screw through the end wall into the nut in the fork (fork at the slack end) | stands 2.6 mm out of the nut (at least 1)
4 × M3 × 12 socket head | pen_carriage: M3 from the back of the X plate | 7.0 mm of thread in a 8.0 mm pilot (at least 6)
2 × M2 × 8 self-tapping (stock, in the servo bag) | pen_carriage: M2 servo screw (in the servo bag) | 5.5 mm of thread in a 8.0 mm pilot (at least 4)
1 × M5 × 30 button head (ISO 7380) | x_carriage_plate: M5 top left wheel axle (head behind the wheel), nyloc nut in front | stands 1.1 mm out of the nut (at least 1)
1 × M5 × 35 button head (ISO 7380) | x_carriage_plate: M5 eccentric top wheel axle (head behind the wheel), nyloc nut in front | stands 1.8 mm out of the nut (at least 1)
1 × M5 × 35 button head (ISO 7380) | x_carriage_plate: M5 bottom wheel axle (head behind the wheel), nyloc nut in front | stands 3.2 mm out of the nut (at least 1)

# 1 Fit tests

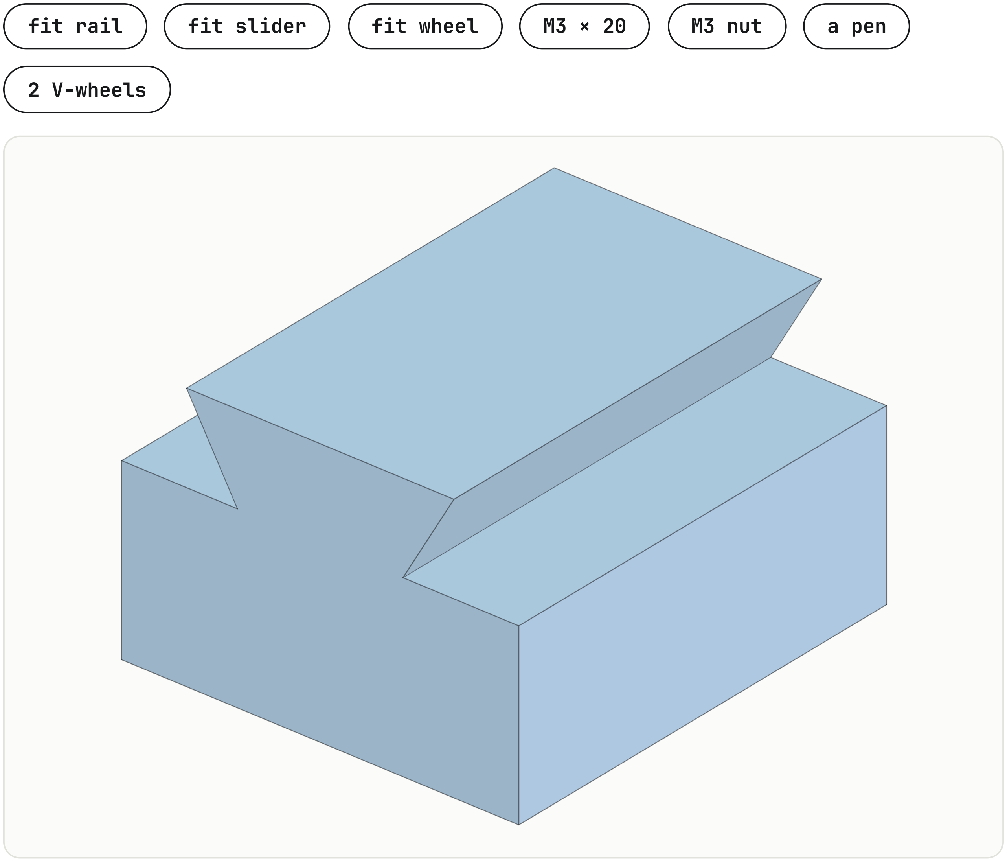
[picture p146: figure]
fit rail; fit slider; fit wheel; M3 nut; a pen; 2 V-wheels

1. Slide the fit slider onto the fit rail. It must slide by its weight, with no side play.
2. Push the nut into the slot in the top of the fit slider. Put a pen in the bore. Turn the screw until it holds the pen.
3. Put a wheel under the eccentric hole of the fit wheel strip: an M5 × 30 screw from below, the wheel, an eccentric spacer, the strip, a nyloc nut.
4. Put a wheel under the counterbored hole: an M5 × 30 button head screw from the top, the strip, a 6 mm spacer, the wheel, a nyloc nut.
5. Lay the strip across the end of a frame rail, the wheels in the two side slots. Turn the eccentric spacer. Both wheels must grip the slots before the eccentric reaches its end.

Note. If the slider is tight or loose, change DT_CLR. If the eccentric cannot reach, change WHEEL_OFF. See the last page. Then run make.sh and print the fit tests again.

# 2 Heat-set inserts (all parts)

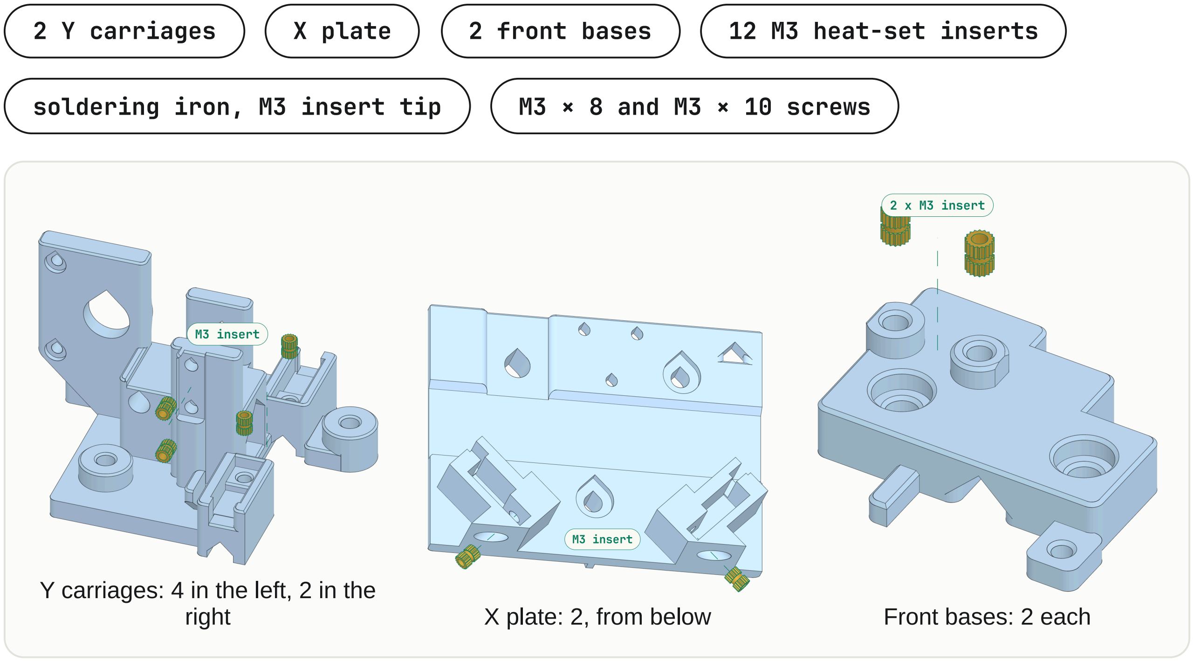
[picture p147: figure]
2 Y carriages; X plate; 2 front bases; 12 M3 heat-set inserts; Y carriages: 4 in the left, 2 in the; right; X plate: 2, from below; Front bases: 2 each

soldering iron, M3 insert tip M3 × 8 and M3 × 10 screws

1. Set the iron to 220 °C with the M3 tip. Let it get hot.
2. Y carriages: press an insert into the ledge of each belt pocket, from the top. The ledge is the raised floor at the inner end of the pocket.
3. Left Y carriage: press an insert into each of the two standoffs on the front face of the X endstop wall, from the front.
4. X plate: turn the plate so that the hole under a belt pocket points straight up. Press the insert down through this hole into the ledge. Do the other pocket the same way.
5. Front bases: press an insert into each of the two standoffs on the top of each base, from the top.
6. Put the insert on the hole, the small end down, and the tip in the insert. Push it straight in with light force until its top is flush. Take the tip out straight. Let the parts cool. Turn a screw in and out once to check each thread: M3 × 10 in the ledges, M3 × 8 in the standoffs.

Note. The 6 inserts in the ledges hold the belt jaws. The 6 inserts in the standoffs hold the three endstop boards. The right front base is the mirror image of the left base.

# 3 Wheels on the Y carriages

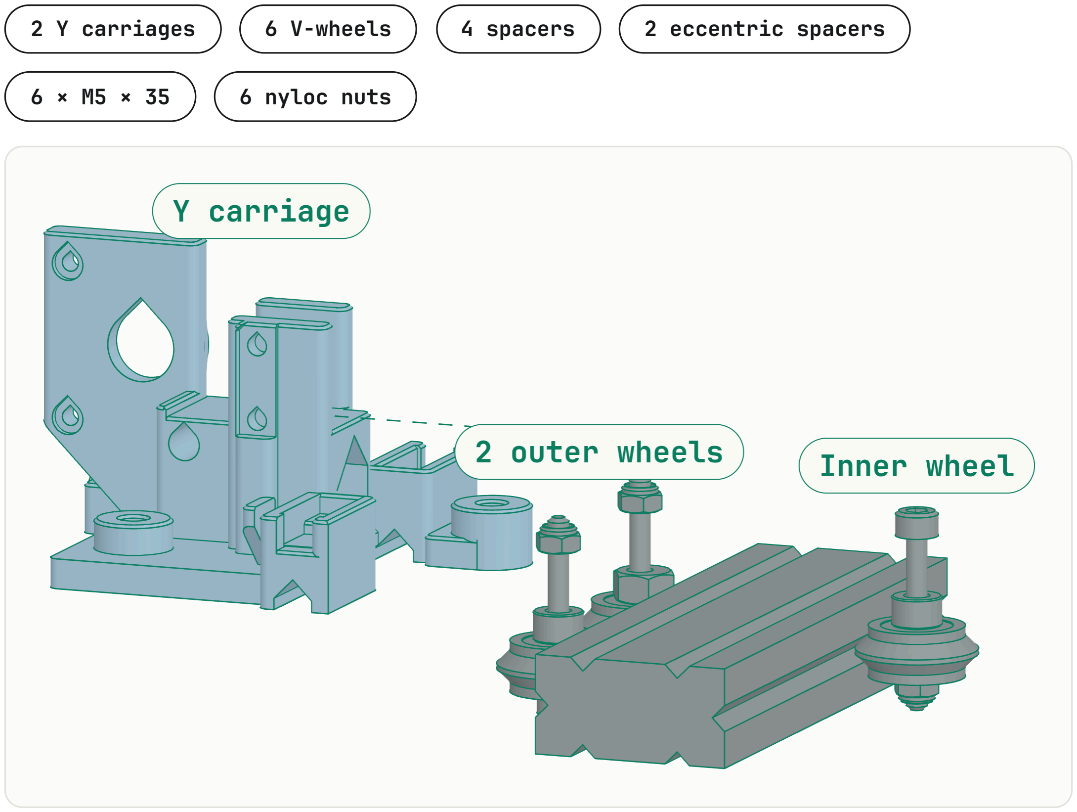
[picture p148: figure]
2 Y carriages; 6 V-wheels; 4 spacers; 2 eccentric spacers; 6 nyloc nuts

1. Front outer wheel: put an M5 × 35 screw up through a wheel and a 6 mm spacer, into the front boss of the plate, outside the rail. Put a nyloc nut on top.
2. Back outer wheel: put an M5 × 35 screw up through a wheel and an eccentric spacer, into the back hole. The hex is between the wheel and the plate. Put a nyloc nut on top.
3. Inner wheel: put an M5 × 35 screw down through the 12 mm boss behind the beam. Do not put the spacer, the wheel and the nut on yet.
4. Tighten the front screw and the back nut until the wheels turn freely with no wobble.

Note. Each carriage is a flat plate, as the stock CR-10 Z carriage plate. The left carriage has the X motor wall behind the beam end. The right carriage has the seat of the X idler fork. The inner wheel goes on when the carriage is on the rail.

# 4 Y carriages on the rails

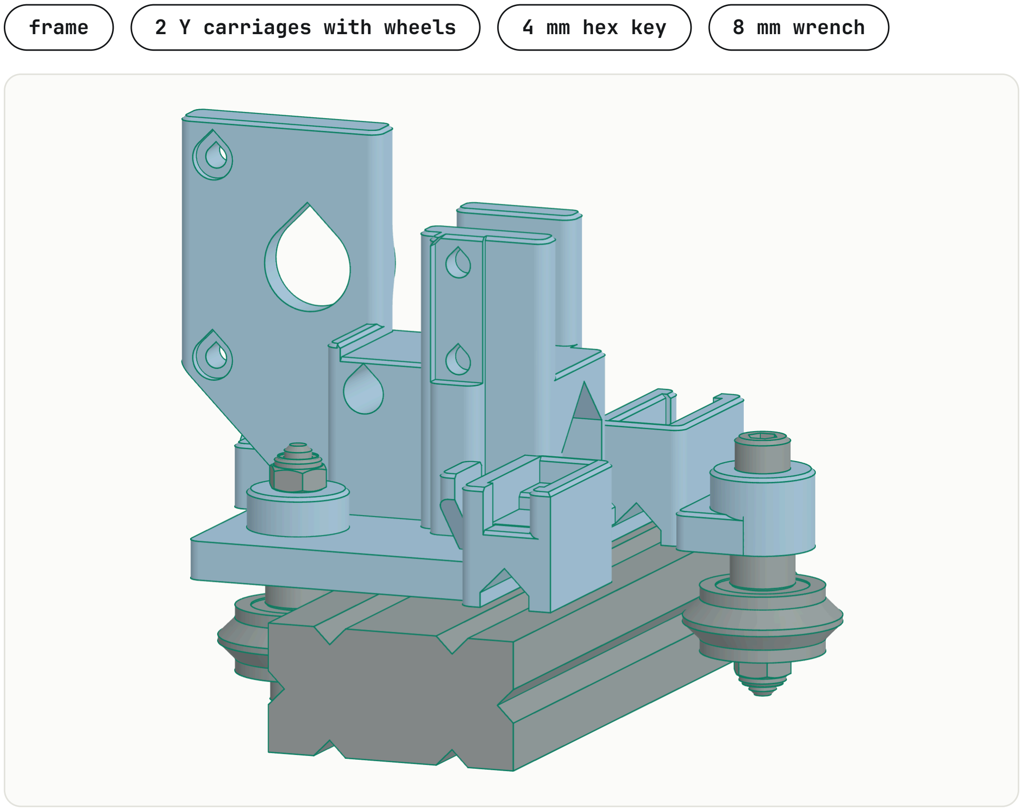
[picture p149: figure]
frame; 2 Y carriages with wheels; 4 mm hex key; 8 mm wrench

1. Stand the frame on the table, feet down.
2. Set each carriage on its rail from above: the plate on the rail top, the two outer wheels in the outer side slot.
3. Under the inner boss, put a 6 mm spacer, the inner wheel and a nyloc nut on the inner screw. The wheel runs in the inner side slot.
4. Turn the eccentric hex with the 8 mm wrench from outside the frame, until the carriage has no play. It must still roll freely. Tighten its nut.
5. Measure the two diagonals of the frame. Make them equal, then tighten the bar screws.

Note. Too much preload makes flat spots on the wheels. Stop when the play is gone. Nothing of the carriage goes under the rail, so the feet stay where they are.

# 5 Y motors behind the back bar

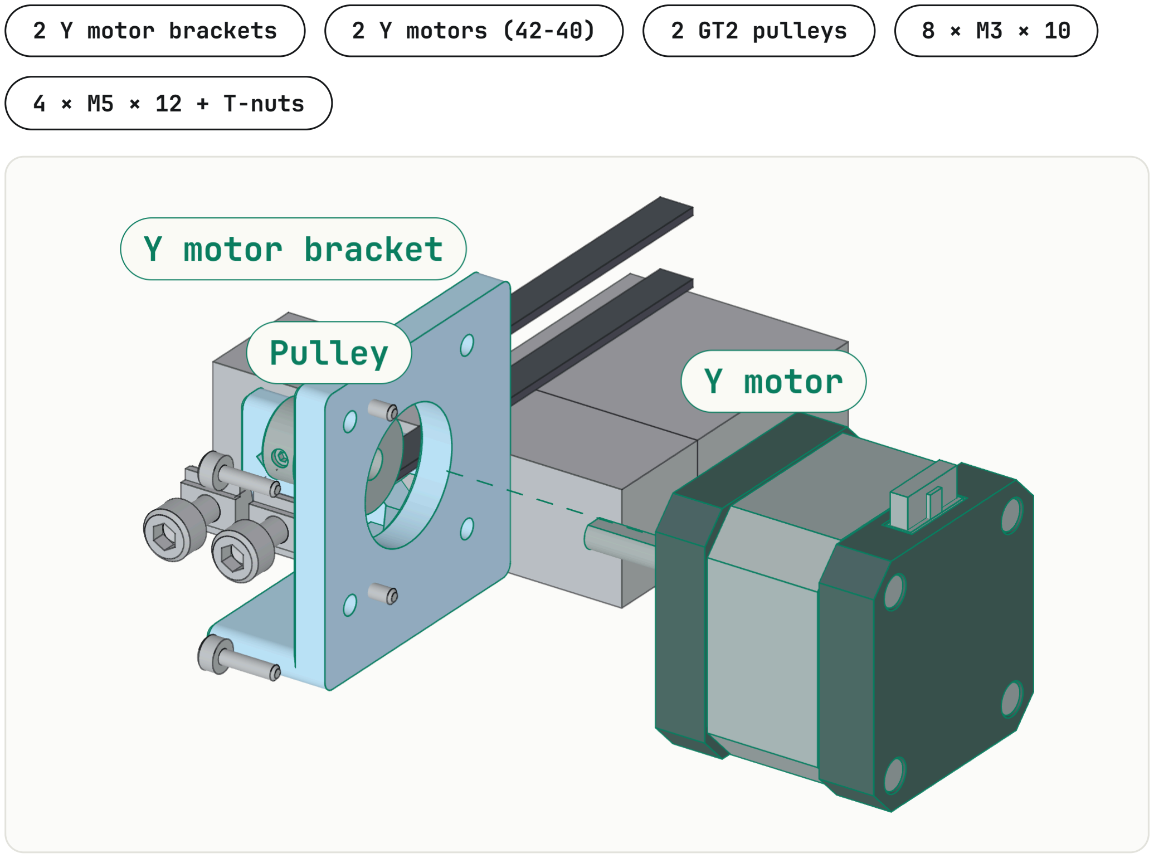
[picture p150: figure]
2 Y motor brackets; 2 Y motors (42-40); 2 GT2 pulleys; 4 × M5 × 12 + T-nuts

1. Hold a 42-40 motor on the outer face of each bracket plate, the shaft through the plate to the inside, the socket up. Put four M3 × 10 screws from the inside into the motor.
2. Put a GT2 pulley on each shaft, the hub to the inside. Line up its teeth with the inner top slot of the rail (31.5 mm from the outer face of the side). Tighten the set screws on the flat of the shaft.
3. Turn two M5 drop-in T-nuts into the slot in the back face of the back bar, near each end, right of the bar end screw heads.
4. Hold each bracket on the back face of the back bar, the recess over the head of the bar end screw. Screw it on with two M5 × 12 screws.
5. Plug in each motor cable. It goes along the table behind the frame to the base board (step "Breakout boards"). It does not move.

Note. The Y motors stand still. The gantry does not carry them, and the Y motor cables are

# 6 Front bases, Y idlers and endstops

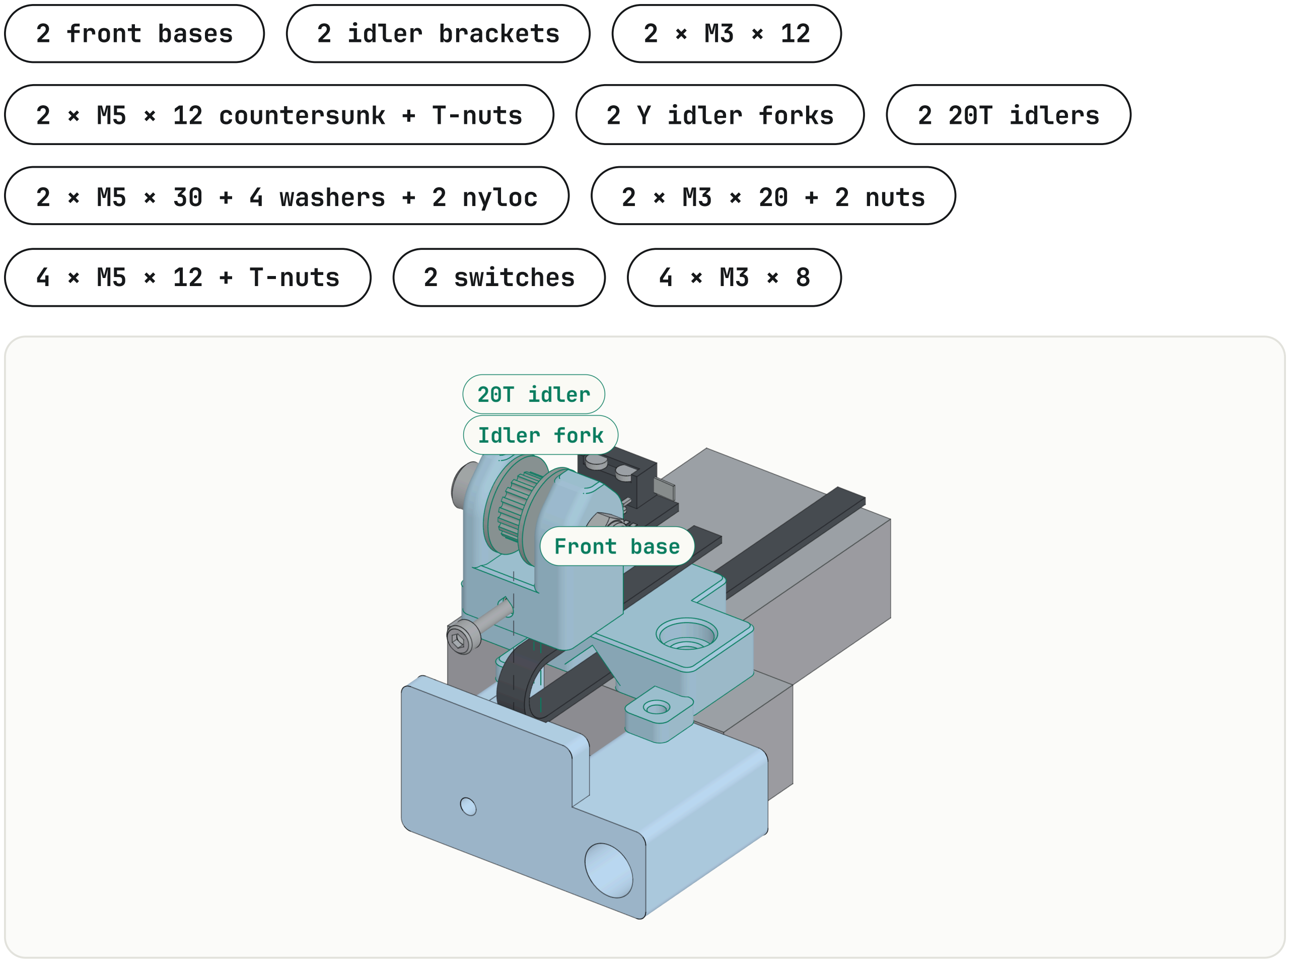
[picture p151: figure]
2 front bases; 2 idler brackets

2 × M5 × 12 countersunk + T-nuts | 2 Y idler forks | 2 20T idlers
2 × M5 × 30 + 4 washers + 2 nyloc | 2 × M3 × 20 + 2 nuts
4 × M5 × 12 + T-nuts | 2 switches | 4 × M3 × 8
1. Push an M3 nut into the slot in the floor of each Y idler fork, from below. The slot is under the middle of the idler.
2. Hold an idler between the two cheeks, a washer on each side. Put the M5 × 30 screw through. Tighten the nyloc nut until the idler turns freely with no play.
3. Turn two M5 drop-in T-nuts into the top slot of the front bar, near each end. Screw a front base on each end with two M5 × 12 screws. Its two lips reach over the front of the bar.
4. Turn an M5 drop-in T-nut into the front face slot of the front bar, behind the ear of each idler bracket.
5. Hold an idler bracket on the front face of the front bar, under the two lips. Put an M5 × 12 countersunk screw through the hole in the front of the ear into the T-nut. Tighten it.
6. Put an M3 × 12 screw down through the inner lip into the bracket.
7. Set each fork on the seat of the bracket, between the two guides. Put an M3 × 20 screw through the end wall from the front into the nut. Turn it two turns only.
8. Lay a Y endstop board on the two standoffs of each front base, the parts up, the plug to the front, the switch to the back. Screw it down with two M3 × 8 screws.
9. Plug in the endstop cable from the front. Leave 20 mm for the plug and the bend of the wires.

# 7 Breakout boards

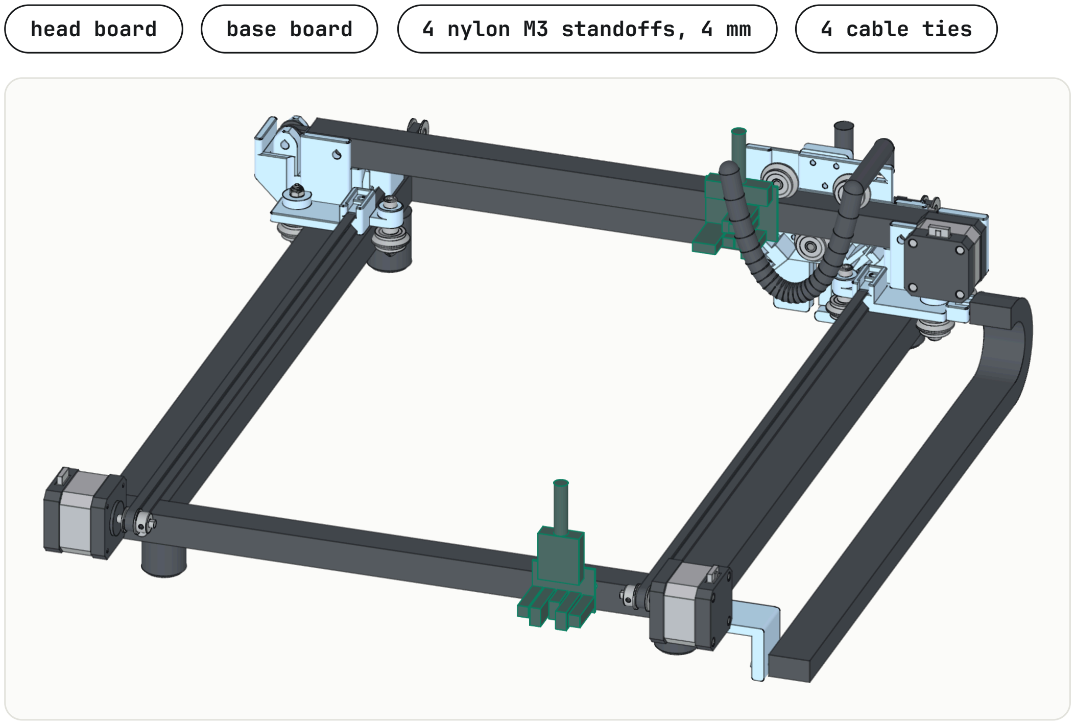
[picture p152: figure]

head board | base board | 4 nylon M3 standoffs, 4 mm | 4 cable ties
1. Base board: hold it on the back face of the back bar, 71 mm from the left end, a standoff under each of its two holes. The standoffs stand on the face of the bar, beside the slot.
2. Put a cable tie through each board hole and its standoff, round the bar. Pull the ties tight.
3. Plug in Y (Y1 motor, left), Z1 (Y2 motor, right), Y- (Y1 endstop) and Z- (Y2 endstop). Leave Z2 empty. Push the big 2 × 8 plug into the header.
4. Head board: hold it on the back face of the X beam, 96 mm from the left side of the frame, the big header up, on two standoffs. Tie it to the beam in the same way.
5. Plug in X (X motor), X- (X endstop) and the servo pigtail on BL_T. Push the big 2 × 15 plug into the header from the top. Keep the cable straight for 35 mm, then bend it back toward

Note. The firmware maps Z1 to the Y2 motor and Z- to the Y2 endstop. The board sizes are estimates: measure the boards first (MEASURE.md).

# 8 X plate and pen carriage

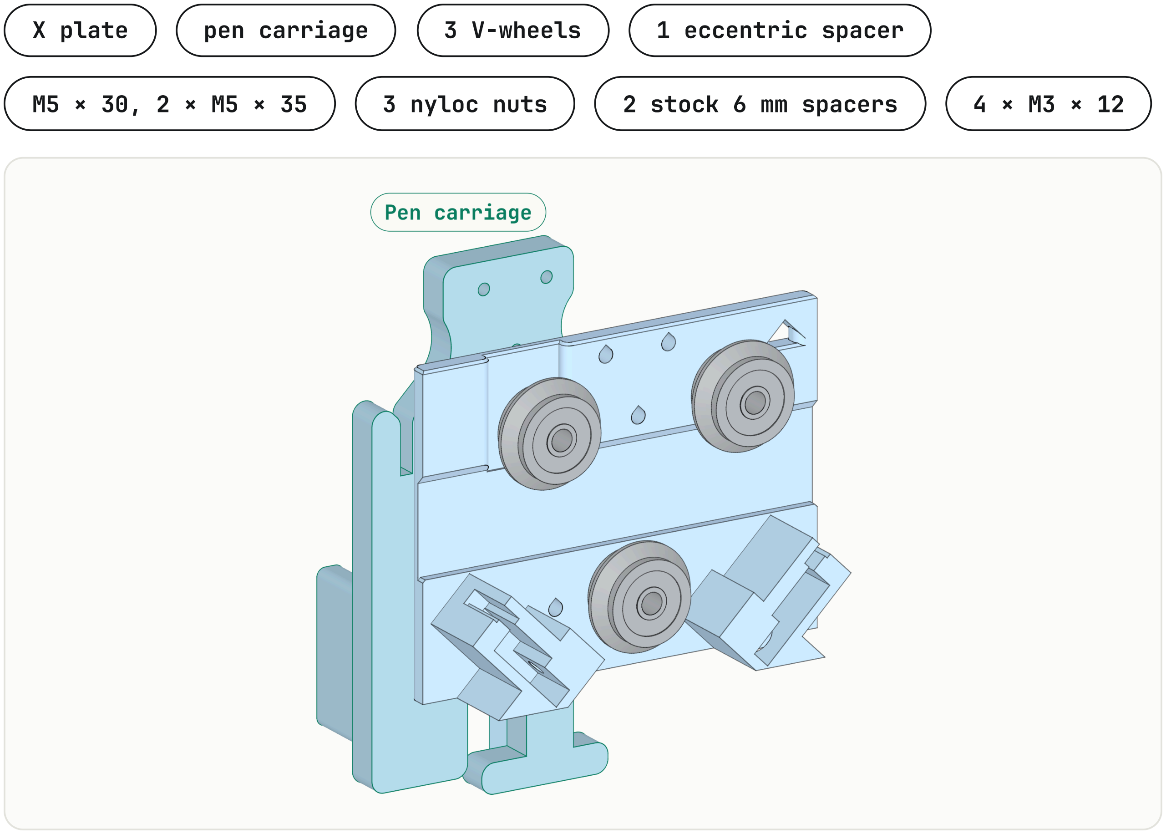
[picture p153: figure]
X plate; pen carriage; 3 V-wheels; 1 eccentric spacer

M5 × 30, 2 × M5 × 35 | 3 nyloc nuts | 2 stock 6 mm spacers | 4 × M3 × 12
1. Hold the pen carriage on the front face of the X plate. The three wheel bosses come through the round holes of the pen carriage.
2. Put four M3 × 12 screws from the back through the plate into the pen carriage (T1, T2, H1, H2). They cut their own thread. Do not overtighten them.
3. Top left wheel: from the back, an M5 × 30 screw through the wheel and a 6 mm spacer, into the boss (the spacer in the recess). Put a nyloc nut on the front.
4. Top right wheel: from the back, an M5 × 35 screw through the wheel and the eccentric spacer (the hex toward the plate), into the boss. Put a nyloc nut on the front. Leave it loose.
5. Bottom wheel: from the back, an M5 × 35 screw through the wheel and a 6 mm spacer, through the bottom boss (the spacer in the recess). Put a nyloc nut on the front.

Note. The eccentric is on the top right wheel. Turn its hex from above with the wrench.

# 9 Beam and X plate

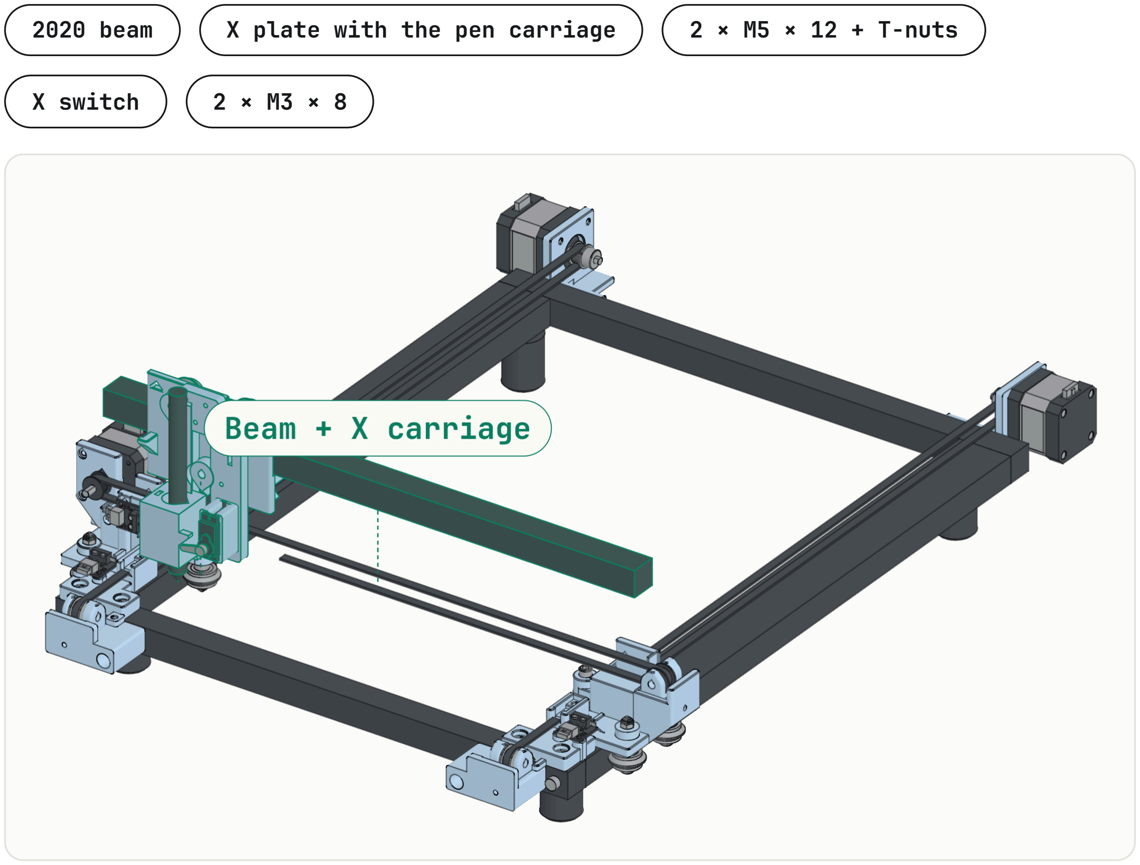
[picture p154: figure]
X switch

2020 beam | X plate with the pen carriage | 2 × M5 × 12 + T-nuts
1. Slide the X plate onto the beam from one end. The top wheels go in the top slot, the bottom wheel in the bottom slot.
2. Turn the eccentric hex of the top right wheel from above until the plate has no play. It must still roll freely. Tighten its nut.
3. Turn an M5 drop-in T-nut into the back slot of the beam, 14 mm from each end.
4. Lay the beam on the two saddles, the pen carriage to the front. The beam ends touch the stops at the outer ends of the saddles.
5. Screw the beam to each carriage with one M5 × 12 screw, through the back wall of the saddle into the T-nut.
6. Screw the X endstop board on the two standoffs on the front of the X endstop wall of the left carriage with two M3 × 8 screws: the parts to the front, the switch to the right, the plug to the left. The trigger lug at the bottom left of the X plate meets the lever tip.

Note. Keep the top and the bottom slots of the beam free: the X belt runs in them. The inner face of the left saddle is the hard stop of the X plate.

# 10 X motor

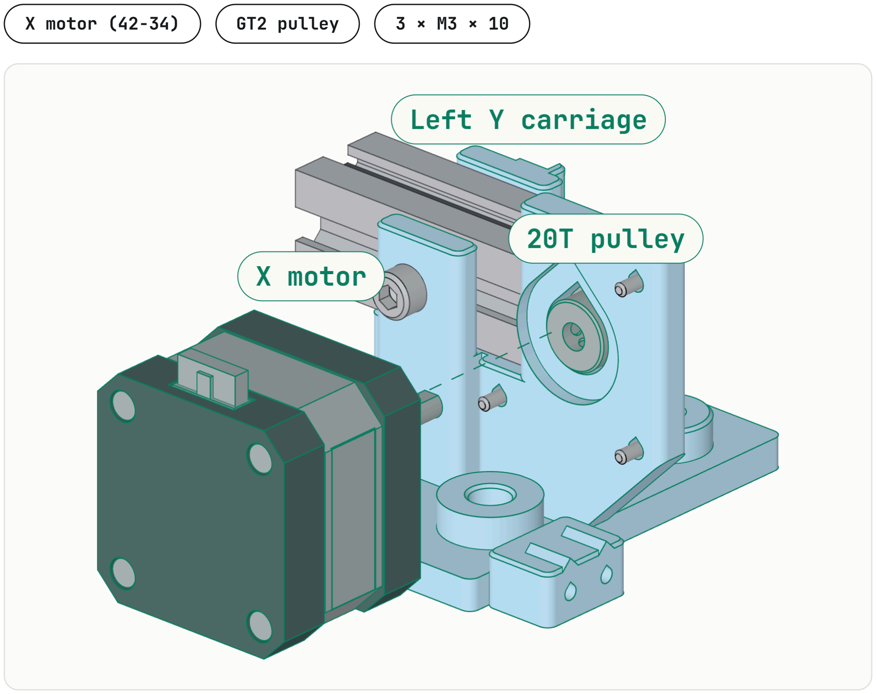
[picture p155: figure]
X motor (42-34); GT2 pulley

1. Put the GT2 pulley on the X motor shaft, the hub toward the motor. Do not tighten it yet.
2. Hold the motor behind the left beam end, the shaft to the front through the motor wall of the left carriage, the socket up.
3. Put three M3 × 10 screws from the front through the wall into the motor. The heads sit in counterbores. The hole over the beam end stays empty.
4. Slide the pulley along the shaft until its teeth are on the beam centre line, in line with the top and the bottom slots. Tighten the set screws.

Note. The X motor is a 42-34: it rides on the gantry, so the shorter motor keeps the moving mass low. The motor stands behind the left beam end, as on the stock CR-10. The pulley

# 11 X idler fork

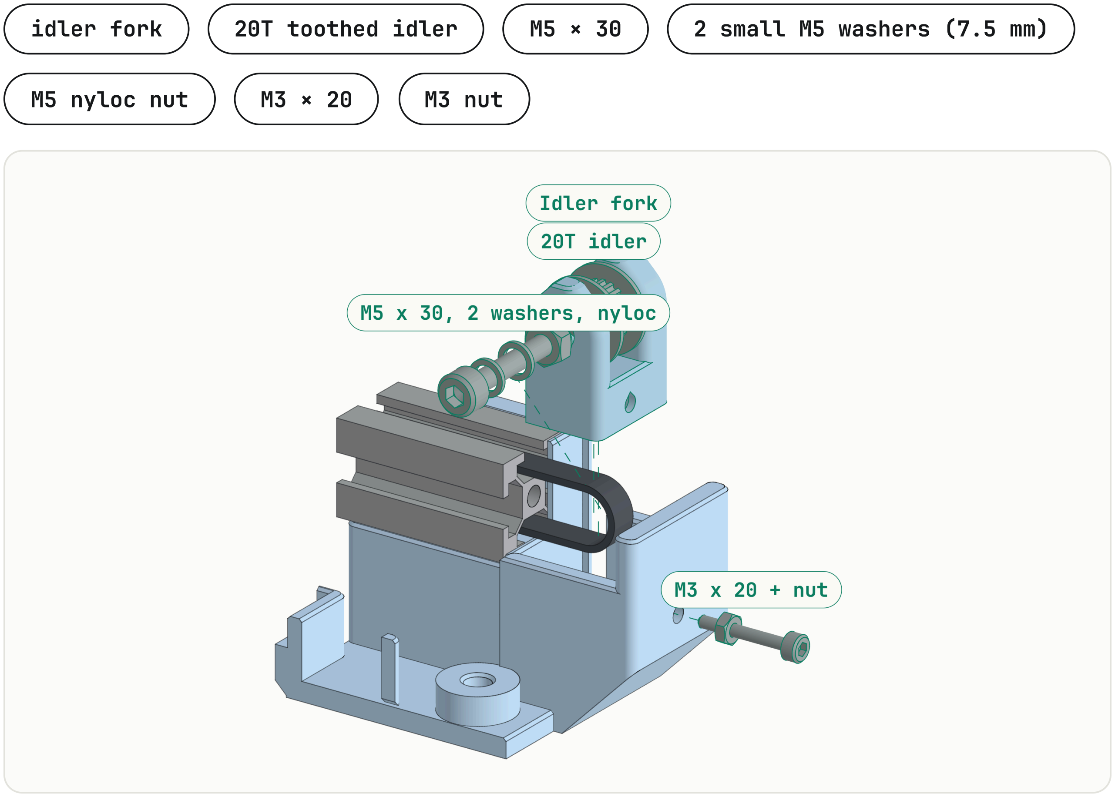
[picture p156: figure]
M5 nyloc nut; M3 nut

idler fork | 20T toothed idler | M5 × 30 | 2 small M5 washers (7.5 mm)
1. Push an M3 nut into the slot in the floor of the fork, from below. The slot is under the middle of the idler.
2. Hold the idler between the two cheeks of the fork, a washer on each side.
3. Put the M5 × 30 screw through the front cheek, the washer, the idler, the washer and the back cheek. Put the nyloc nut on the back. Tighten it until the idler turns freely with no play.
4. Set the fork in the seat past the right beam end, the floor on the seat.
5. Put the M3 × 20 screw through the end wall from the outside (the right side of the machine), into the nut in the fork. Turn it two turns only. It sets the X belt tension later (step "X belt").

Note. The idler axle has a support at each end. The fork slides 4 mm out and 2.5 mm in. The tension screw head is on the outside of the right carriage: you reach it without taking anything

# 12 Y belts and belt jaws

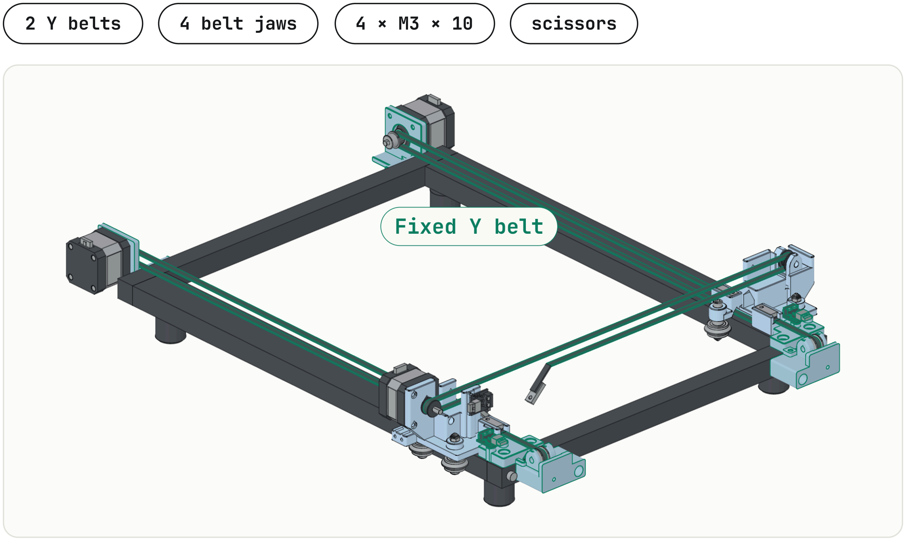
[picture p157: figure]
2 Y belts; 4 belt jaws; scissors

1. Turn the Y tension screw out until the fork is at the back end of its travel.
2. Cut each Y belt about 1195 mm long.
3. Front block: lay the belt end in the slit of the end wall, teeth down. Lay 10 mm of it on the pocket floor, past the end wall. Fold the end back over itself. The fold stops 3 mm short of the ledge.
4. Lay a jaw on the two layers, the screw hole over the ledge. Put an M3 × 10 screw through the jaw into the insert. Tighten it until the jaw is down on the ledge.
5. On the left carriage the X endstop board is over the front jaw screw. Take the board off (2 screws) to reach the screw, then put it back.
6. Lay the belt round the idler at the front and the motor pulley at the back, teeth inside. The lower run lies over the rail, under the two clamp blocks.
7. Back block: pull the belt tight by hand through the slit. Fold it back 10 mm past the end wall, cut the tail, and clamp it with a jaw in the same way.
8. Turn the tension screw in until the belt is tight. Do the same on the other side.

Note. The jaw stops on the ledge, so the screw presses the two layers 0.3 mm and no more. The length between the two folds is 1115.4 mm in the model, with the fork at the middle of its travel. The fork moves 4 mm forward and 3 mm back. If the belt is too long, open the back

# 13 X belt and belt jaws

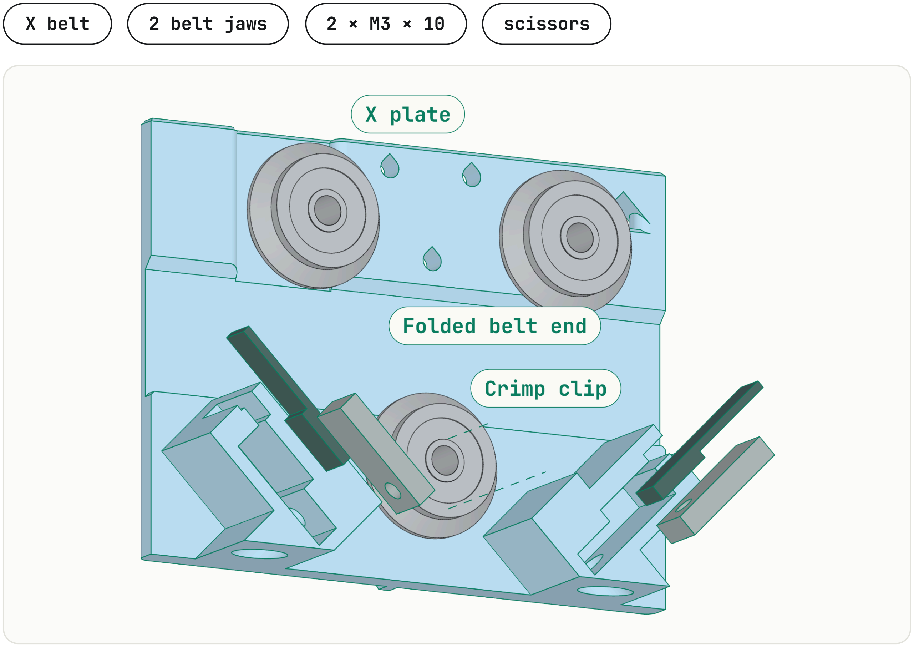
[picture p158: figure]
X belt; 2 belt jaws; scissors

1. Turn the M3 tension screw out until the X idler fork is at the inner end of its travel.
2. Cut the X belt about 959 mm long.
3. Feed the belt flat, teeth down, through the top slot of the beam from the idler end to the motor end, under the top wheels. Lay it round the pulley and back through the bottom slot.
4. Left clamp: from the back, lead the belt out of the bottom slot into the 45 degree slit and 10 mm along the pocket, past the end wall. Fold the end back under itself, 3 mm short of the ledge.
5. Slide a jaw into the pocket from the back, under the two layers. Put an M3 × 10 screw from below through the hole under the jaw, through the jaw, into the insert. Tighten it until the jaw is on the ledge.
6. Right clamp: pull the belt tight by hand, fold it, cut the tail, and clamp it in the same way.
7. Turn the M3 tension screw in. It pulls the fork outward. Stop when the belt is tight.

Note. This is the stock CR-10 belt path: both runs lie in the slot channels of the beam, so no belt stands in front of the beam. The length between the folds is 878.7 mm in the model, with the fork at the middle of its travel. The belt passes the 6.2 mm slot opening at the clamps:

# 14 Control box and harness

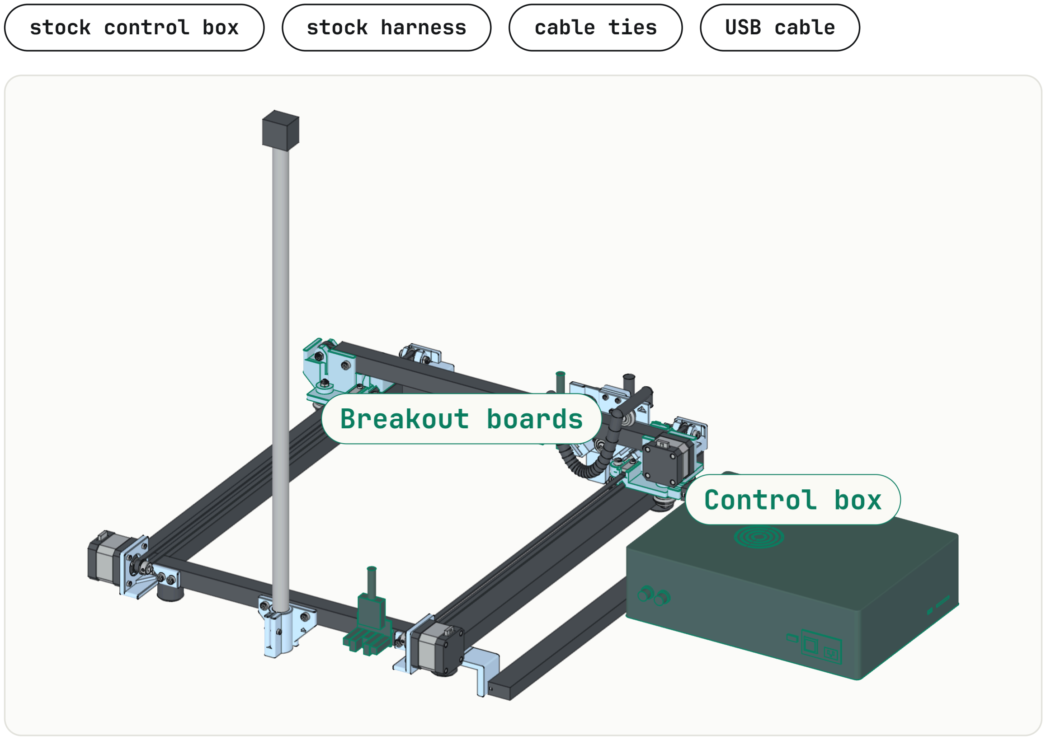
[picture p159: figure]
stock control box; stock harness; cable ties; USB cable

1. Stand the control box on the table, left of the frame. The LCD faces the front.
2. Run the head cable from the head board along the back of the beam to the left carriage. It goes into the Y drag chain (step "Moving cables"), and leaves the chain at its fixed end, at the back left corner.
3. Tie the head cable to the back of the beam. Tie the base cable along the back bar.
4. Plug the two cables into the box. Check the mains voltage setting of the supply.
5. Connect the USB port of the box to the computer. Flash the plotter firmware: tinygo flash

Note. The size of the control box is an estimate. Put the box where the stock cables reach. From the back: the head board rides on the beam, and the base board is on the back bar.

# 15 Moving cables

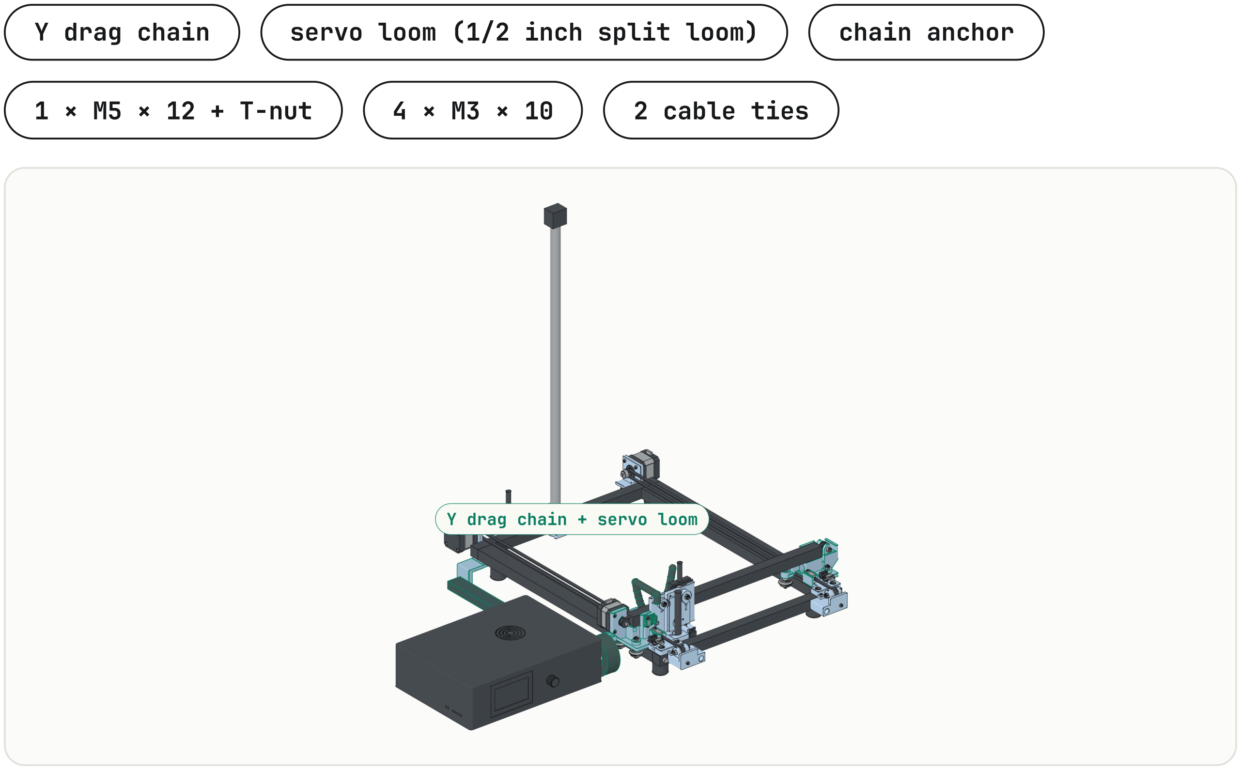
[picture p160: figure]

Y drag chain | servo loom (1/2 inch split loom) | chain anchor
1 × M5 × 12 + T-nut | 4 × M3 × 10 | 2 cable ties
1. Put the chain anchor at the back left corner, beside the left rail. Its arm goes under the rail: one M5 × 12 screw up into a T-nut in the bottom outer slot of the rail. The arm is wide round the screw, so the screw has 5 mm of material all round.
2. Open the links of the chain. Lay in the head harness. Close the links. The Y motor cables do not go in the chain: the Y motors do not move.
3. Bolt the end links with two M3 × 10 screws each: the fixed end to the anchor wall, the moving end to the tab of the left carriage plate. The lower run lies on the table, the bend points to the front.
4. Cut the split loom to 295 mm. Push the servo lead into it.
5. Moving end: lay the loom on the front of the X plate at the top left. Put a cable tie through the slot in the plate and round the loom. Lead the loom up over the plate top and back over the beam.
6. Fixed end: tie the loom to the head harness cable, just above the big plug of the head board. The loop between the two ties is 189 mm long and hangs free behind the beam.

Note. Cut the chain to 506 mm. The servo loom needs no printed holder. In the model the lowest point of the loop stays 37 mm or more above the paper.

# 16 Servo

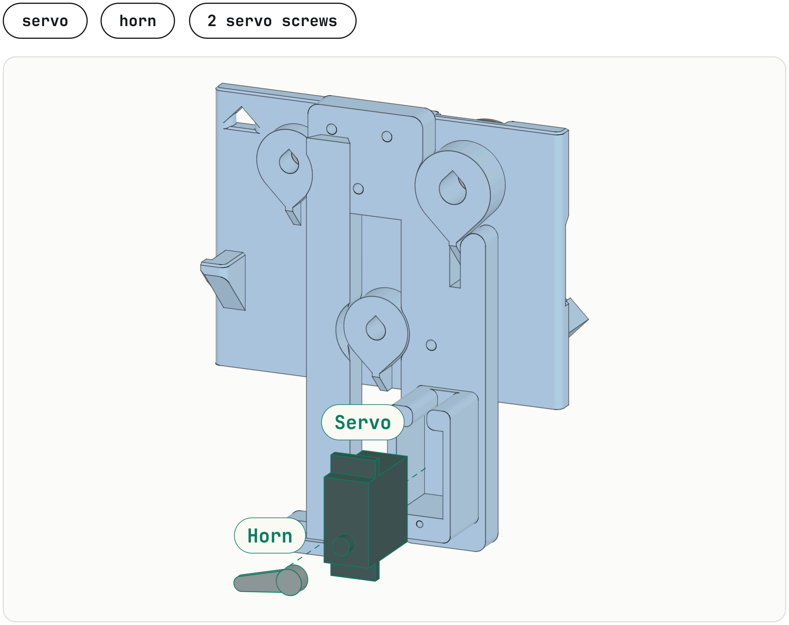
[picture p161: figure]
servo; horn; 2 servo screws

1. Push the servo into the pocket, the shaft at the bottom. The wire goes out through the slot.
2. Put the two servo screws through the tabs into the tower. Plug the servo into the servo pigtail.
3. Send M5 (pen up), then M3 (pen down). Leave it at pen down.
4. Put the horn on the spline. The arm points at the tab of the slider, 10° below level.

Note. At pen up the horn lifts the slider 7.0 mm. Fine-tune the angles with the LCD menu: Pen up +1, Pen up -1, Pen down +1, Pen down -1.

# 17 Pen slider and pen

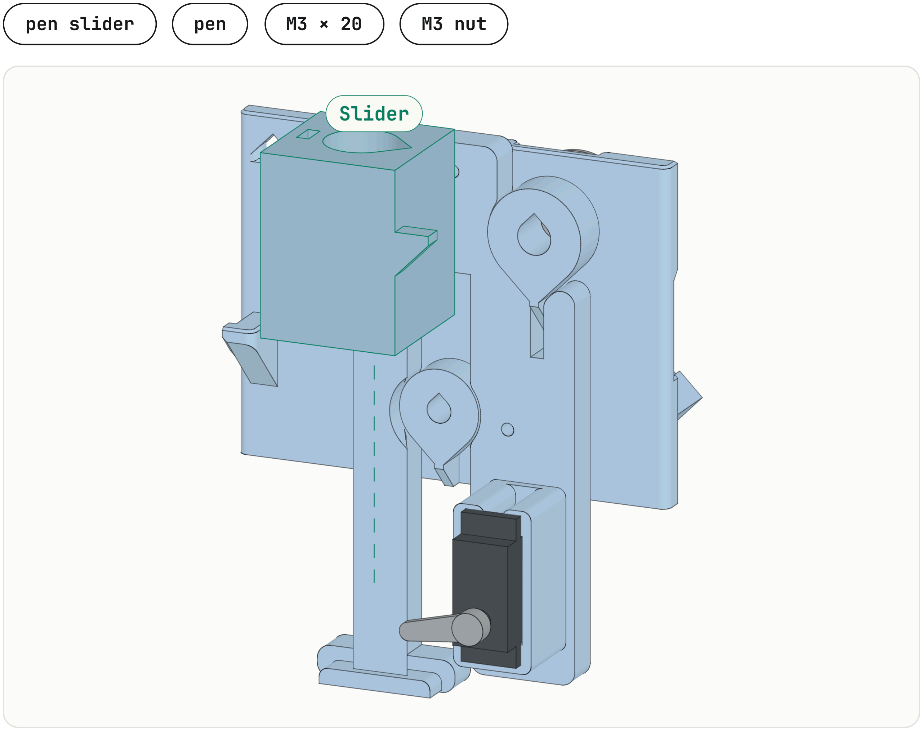
[picture p162: figure]
pen slider; pen; M3 nut

1. Push the M3 nut into the slot in the top of the slider. Turn the M3 × 20 clamp screw into it a few turns.
2. Slide the slider onto the dovetail rail of the pen carriage from the top.
3. Send M3 (pen down). Put the pen in the V bore until its tip touches the paper. Tighten the clamp screw.

Note. The weight of the slider and the pen is the pen force. Pens of 8 to 15 mm fit the V bore.

# 18 Camera pole (optional)

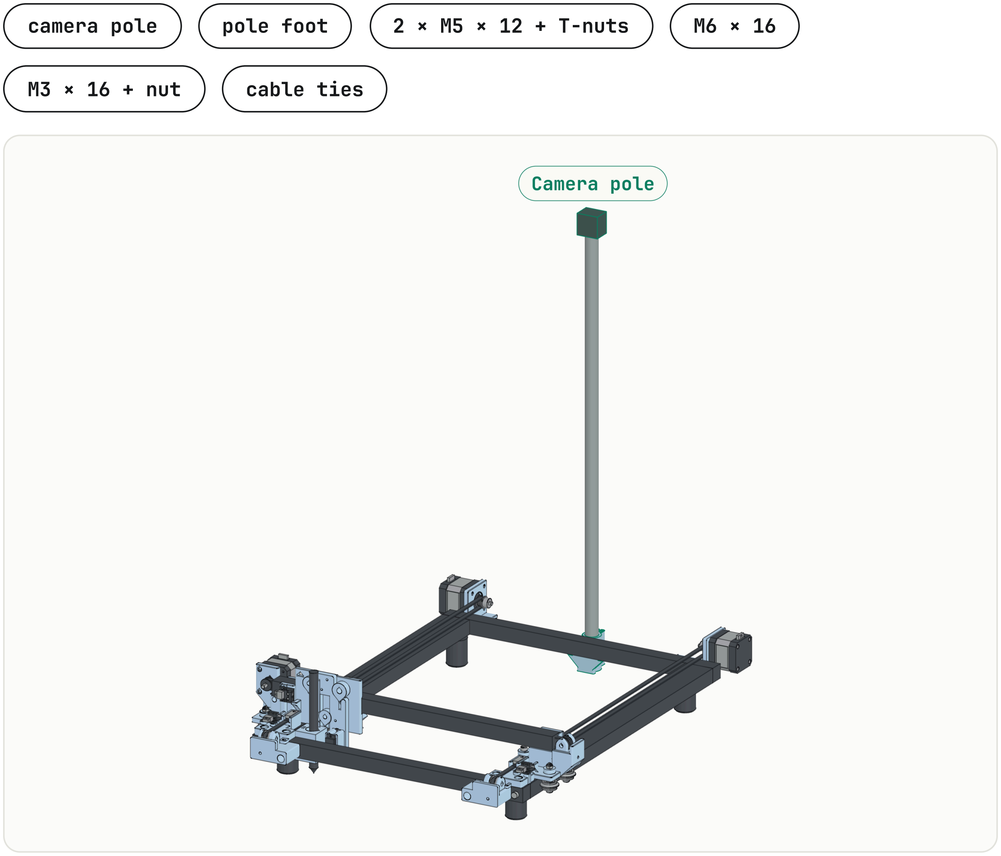
[picture p163: figure]
M3 × 16 + nut; cable ties

camera pole | pole foot | 2 × M5 × 12 + T-nuts | M6 × 16
1. Turn two M5 drop-in T-nuts into the slot in the back face of the back bar, at the centre.
2. Drop the M3 nut into the slot in the top of the right collar ear. Put the M3 × 16 screw through the two ears. Leave it loose.
3. Put the pole in the socket. Hold the foot on its side. Put the M6 × 16 screw up through the floor into the pole end. Tighten it.
4. Hold the foot and the pole behind the back bar. Screw the foot to the bar with two M5 × 12 screws. The foot hangs 3 mm over the table.
5. Tighten the M3 collar screw. Tie the USB cable to the foot through the two slots, and to the

Note. The pole is 590 mm long. The camera lens is about 15 mm above the top of the pole.

# 19 First run

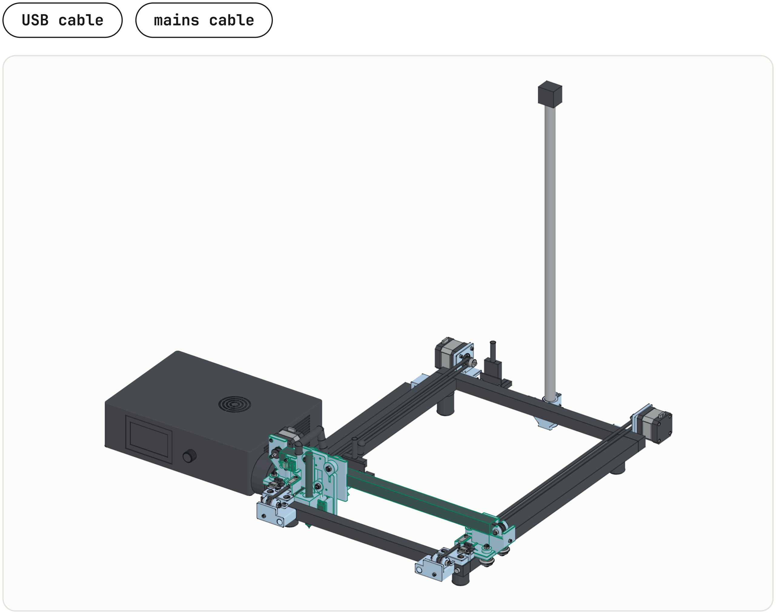
[picture p164: figure]
USB cable; mains cable

1. Connect the control box to the mains and turn it on. Connect the box to the computer with USB.
2. Send M119. Push each endstop by hand and check that it changes.
3. Send G28. Both Y sides go to the front switches. This squares the gantry.
4. Plot samples/square.gcode. Measure the square: it must be 40 × 40 mm.
5. For layout with the camera, run plotstudio (docs/studio.md).

Note. The travel is 246 × 395 mm in the model. A4 and Letter fit. Set the firmware to 245 ×

## The simplification

The build is simplified. The pen changer, the Pico W control pod, the two board housings, the bar end caps, the servo cover, the pen gauge and the X band with its two holders are gone. REVIEW.md has the findings and the reasons.

Each Y carriage is a flat 6 mm plate, as the stock CR-10 Z carriage plate, with only the features this plotter uses: the wheel bosses, the Y belt clamps, a beam saddle, the Y endstop striker; on the left the chain tab, the X motor wall and the X endstop wall; on the right the seat of the X idler fork. The wheel layout and the travel are unchanged.
The breakout boards stand bare on two 4 mm nylon standoffs each, held by cable ties.
The servo lead runs in a 1/2 inch split wire loom, in a free loop behind the beam, with one cable tie at each end.
The X motor is a 42-34 (213 g); the Y motors are 42-40 (287 g).
The main build is now 22 parts, 23 h 10 min, 408 g of PLA, $8.16 (before the simplification: 27 parts, 30 h 28 min, 544 g, $10.88). The travel is 246 × 395 mm.

## Print settings

Infill: 15 % gyroid. Top and bottom: 0.9 mm (3 layers).
Walls: 3 lines (1.5 mm); 4 lines (2 mm) on the rail fit test.
Outer walls 40 mm/s, skins 45 mm/s. At 0.3 mm layers the flow limit of the 0.5 mm nozzle (about 8 mm³/s) caps the other speeds near 55 mm/s.

## Adjust the fit

Change the values in shape.py, run make.sh, and print the part again. make.sh checks the fit, the meshes, and the supports before it writes the files.

Problem | Value | Now Change

The slider is tight or has

play on the rail | DT_CLR | 0.25 Add 0.05 if it is tight. Subtract 0.05 if it has play. Reprint the fit tests.

A self-tapping screw is

loose in its pilot hole | SELF_TAP | 2.8 Subtract 0.1 for a tighter thread. Add 0.1 if the screw is hard to turn.
The servo does not fit its pocket | SERVO_W, SERVO_L | 12.4, 22.8 The servo sizes are data sheet values. Measure your servo.

The horn does not reach

the tab | HORN_L | 14 Measure from the shaft to the centre of the round end of the
| | horn arm.

The eccentric cannot take

up the play of a carriage | WHEEL_OFF | 10.1 Subtract 0.2 if the wheels do not reach the slots. Add 0.2 if the
| | eccentric is at its end before the wheels turn freely. The fit
| | wheel test checks it.

The eccentric spacer is
loose or tight in its hole | ECC_HOLE | 7.5 Measure the shank of the eccentric spacer. Add 0.1 to it.

The beam is loose on the

saddles | CRADLE_CLR | 0.3 Subtract 0.1. The two M5 screws pull the beam against the back walls, so a small gap is fine.

The pen does not reach

the paper | DROP | 46 Set the pen in the slider at pen down first. DROP lowers the whole pen lift.

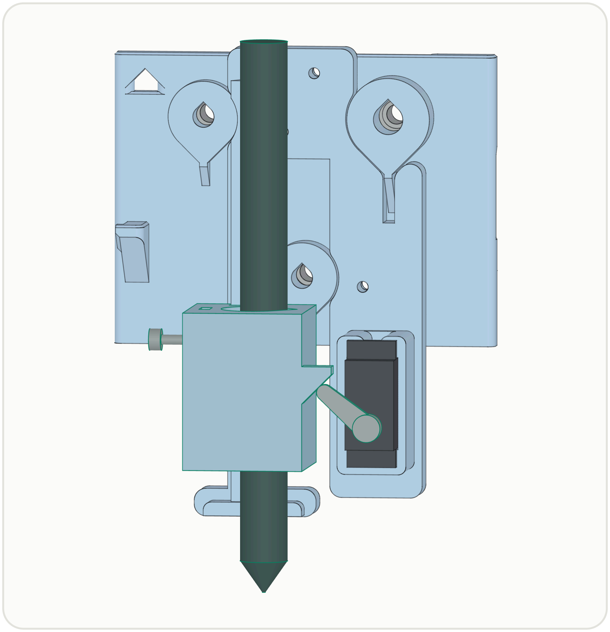
[picture p165: figure]

Pen up: the horn turns to 40° and lifts the slider 7.0 mm. Pen down: the horn is 1 mm under the tab, and the pen rests on the paper.

The pen carriage holds the pen lift. Four M3 screws hold it on the front of the printed X plate. Printed jaws clamp the X belt ends in two pockets of the X plate, under the beam.
