beetlebugorg/penplotter/(commit log)

2026-11-10 Add the table pen plotter
    A table pen plotter made from the parts of a Creality CR-10 V3. The
    stock control box with its ATmega2560 runs new firmware, and printed
    PLA parts hold a servo pen lift on the stock V-wheels.
    - firmware/: the Go and TinyGo firmware for the stock mainboard, with
    G-code motion, homing, the servo pen lift and manual pen changes.
    - hardware/: the printed parts in build123d, the fit and strength
    checks, the Cura profiles, the line art and the build guide PDF.
    - sim/: a simulator of the machine with a 3D view, a jog pad and a
    servo slider. The pen lift follows the horn and tab geometry.
    - studio/: plotstudio, the web app that lays out and sends plots.
    - samples/: G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
    [base_board.stl, beam.stl, belt_clips_carriage.stl, belt_clips_gantry.stl, belt_ends_carriage.stl, belt_ends_gantry.stl, carriage_black_plastic.stl, carriage_servo.stl]
2026-11-10 Print the parts in light blue MatterHackers PLA
    The printed parts change from orange eSun PLA (roll-2) to light blue
    MatterHackers PLA. The profiles get a new roll-6 for it. It copies the
    settings of the MatterHackers navy roll (roll-3) with a new colour.
2026-11-10 Remove the DA40 and Accord samples
    The samples drew a Diamond DA40 blueprint and line art of a 1999 Honda
    Accord. They use the names of other owners, and the plotter does not
    need them. The mandala, the blueprint and the test drawings stay. The
    README drops the trademark names of the removed samples.
2026-11-10 Leave the gantry and carriage screws out of the Printdeck view
    The first Printdeck plan failed its generate check. On the GitHub
    runner, model.py wrote fasteners_gantry.stl and fasteners_carriage.stl
    with other bytes than the committed files. All the other files were
    the same. The assembly now leaves out these two meshes, so the check
    compares only files that the runner writes the same way.
2026-11-10 Show the printed parts in light blue
    The parts print in light blue MatterHackers PLA, so the accent colour
    changes from orange to light blue (#7FB6E0). The model, the sim, the
    progress page, the line art and the build guide PDF use it. The hero
    images and the build guide are rendered again.
2026-11-10 Add the frame, wheels, belts and cables to the Printdeck view
    The 3D view of the assembly had no extrusions, V-wheels, belts, drag
    chain, servo loom, camera pole, X endstop or control box. The sim
    draws these parts from stl/frame.json at run time, so they had no STL
    files.
    hardware/context_meshes.py writes them to hardware/stl/context/ with
    the Python standard library. It uses the geometry of sim/web/machine.js
    and wiring.js at machine home: the V-slot profiles, the toothed belt
    wraps, the chain links on their path and the loom catenary. The X
    endstop is a crop of the stl/detail meshes. The output is rounded to
    0.0001 mm and has a fixed header, so the bytes are the same on each
    computer.
    T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
    [camera_pole.stl, control_box.stl, drag_chain_fixed.stl, drag_chain_moving.stl, feet.stl, frame.stl, servo_loom.stl, webcam.stl]
2026-11-10 Clear the size offsets of the light blue roll
    roll-6 copied the calibration of the navy roll: xy_offset 0.144 mm and
    hole_xy_offset 0.292 mm. The light blue roll has no calibration yet.
    The model already has its clearances, for example 0.25 mm on each
    side of the dovetail. The outer offset grew the rail and closed the
    slot by 0.29 mm on each side, so the dovetail fit test was too tight
    to slide. The hole offset made the 4.0 mm insert holes about 4.6 mm.
    Both offsets are now 0.
2026-11-11 Show the inserts and screws of each part in Printdeck
    Add seven exploded hardware views to the Printdeck build, one for each
    group of printed parts. Each view has the part, its heat-set inserts in
    brass, and its screws, nuts, T-nuts, spacers and wheels. The explode
    slider moves each item out along its axis.
    hardware_views.py writes the meshes from fasteners.py and writes the
    views into printdeck.yml between two marker lines. The generate step
    does not run it, so the runner does not mesh the fasteners again.
    [eccentric_eccentric_spacer_stock-yp.stl, eccentric_eccentric_spacer_stock-zn.stl, insert_m3_heat_set_insert_5_7_mm-yn.stl, insert_m3_heat_set_insert_5_7_mm-zp.stl, insert_m5_heat_set_insert_9_5_mm_long-yn.stl, insert_m5_heat_set_insert_9_5_mm_long-zp.stl, nut_m3_nut-zp.stl, nyloc_m5_nyloc_nut-xp.stl]
2026-11-12 Show where each heat-set insert goes in the guides
    The inserts step had one picture of the bare left Y carriage and the
    holes only in words. The inserts are now the first assembly step, by
    size: all M5 inserts, then all M3 inserts. Each part with inserts has
    a picture with its inserts in brass, lifted above their holes.
    The line-art renderer has a brass finish, and a guide page can show
    two pictures with captions.
2026-11-12 Clamp the belt ends with printed jaws and screw down the idler brackets
    The crimp clips are gone. Each of the 6 belt ends folds 180 degrees
    back over itself in its pocket, and a printed jaw presses the two
    layers. One M3 x 10 screw past the fold pulls the jaw into an M3 insert
    in a ledge. The ledge stops the jaw at 0.3 mm of squeeze.
    Each Y idler bracket gets an ear with an M5 x 12 countersunk screw into
    a T-nut in the front face slot of the front bar. The Y and X tension
    screws move to the belt centre line, with the nut in the fork floor.
    The measured servo depth (17.92 mm) moves the horn 1.92 mm forward:
    the slider tab stops at the slider face, and the Y strikers follow the
    new front sto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
    [beam.stl, belt_clips_carriage.stl, belt_clips_gantry.stl, belt_ends_carriage.stl, belt_ends_gantry.stl, belt_jaw.step, belt_jaw.stl, camera_pole.stl]
2026-11-12 Put a nyloc nut on every wheel axle and explode each printed part
    The front outer Y wheel axles and the bottom X wheel axle went into
    long M5 inserts with no lock, so they can back out as the wheels turn.
    Each is now an M5 x 35 with a nyloc nut, as on the other wheels. The
    bosses grow to keep 5 mm of material round the M5 hole. The build now
    has no M5 inserts, only the 12 M3 inserts.
    In the Printdeck assembly each item has its own explode direction, so
    each printed part comes off on its own. The belt jaws come off before
    the belt ends.
    [belt_jaw.step, fasteners_carriage.stl, fasteners_gantry.stl, fit_rail.step, fit_slider.step, fit_wheel.step, insert_m5_heat_set_insert_9_5_mm_long-yn.stl, insert_m5_heat_set_insert_9_5_mm_long-zp.stl]
